leedanie2/curve-tracer/sim/README.md

# sim/ — LTspice experiments

One file per experiment, and that file is the source of truth. Circuits with
topology worth seeing are LTspice schematics (`.asc`: 00–03, 08–11); circuits
that are just a resistor network are plain netlists (`.cir`: 04–07). Vendor
models live in `models/`. LTspice's `.log`, `.raw`, `.db`, `.op.raw` and `.net`
outputs are regenerable and gitignored.

Run a file headless (`-b` takes `.asc` and `.cir` alike), then parse its log or
`.raw`. This LTspice is the Windows build
in a CrossOver bottle, so the `/Applications` binary is only a launcher stub —
`-b` against it returns exit 0 without simulating. Drive the bottled `.exe`
instead:

```
CX=/Applications/LTspice.app/Contents/SharedSupport/ltspice/bin
"$CX/cxstart" --bottle ltspice --workdir "$PWD/sim" -- \
  "C:\\Program Files\\ADI\\LTspice\\LTspice.exe" -b "$PWD/sim/06_diffamp_loading.cir"

python3 host/parse_cmrr_log.py sim/05_diffamp_mc.log   # -> media/cmrr_mc.png
```

Note that `.meas` on a stepped `.op` logs only the first step; the remaining
steps are in the `.raw` file (f64 first variable, f32 for the rest).

---

## 04_diffamp_cmrr.cir — CMRR vs resistor tolerance, worst-case corner

**Sweeps:** `VCM` 0–11 V, stepped over `tol` = 1e-6, 1e-3, 1e-2. The four
resistors are skewed to the worst-case sign pattern (`s1..s4` = +, −, −, +) so
each tolerance gives the corner, not a typical case. `E1` gain 1e7 and tightened
`reltol/vntol/abstol` keep the solver from dominating the result.

**Question:** with a plain one-op-amp difference amp, how much common-mode
rejection do resistor tolerances alone cost at the worst-case corner?

**Results:**

| tol  | CMRR |
|---|---|
| 1e-6 | 134.40 dB |
| 0.1% | 74.42 dB |
| 1% | 54.57 dB |

The 1e-6 row is a **solver-floor control, not a result** — it confirms the
numerical noise floor sits far below the rows that matter.

Closed form for this corner:

```
A_cm = 80t / [(1 - t^2)(1 + b)],   b = 20(1 + t) / (1 - t)
```

The familiar `(1 + G)/(4t)` shortcut agrees to within 0.02 dB at 0.1%.

## 05_diffamp_mc.cir — CMRR Monte Carlo, 0.1% resistors

**Sweeps:** 500 runs (`.step param run 1 500 1`), each resistor drawn
independently via `mc(1, tol)` at `tol` = 1e-3, same `VCM` 0–11 V DC sweep.

**Question:** the corner in 04 is the guaranteed floor — what does the
*distribution* look like across a real production batch?

**Results (n = 500):**

| stat | CMRR |
|---|---|
| min | 76.20 dB |
| p5 | 79.43 dB |
| median | 88.26 dB |
| p95 | 110.51 dB |
| max | 144.73 dB |

Report this as a distribution with **74.4 dB as the floor**, not as a single
number. Note that `mc()` draws uniform and independent values, whereas real
reel-matched resistors are both tighter and correlated — so this spread is
conservative. **Do not cite the max**; it is one lucky draw, not a spec.

Reproduced from a batch run on 2026-09-18: `parse_cmrr_log.py` returns these
figures to the digit, since LTspice seeds `mc()` deterministically. Histogram:
`media/cmrr_mc.png`.

## 06_diffamp_loading.cir — input loading with no DUT connected

**Sweeps:** `Rsh` stepped over 1 Ω, 100 Ω, 10 kΩ at a fixed 10 V source, `.op`
only. `E1` gain is 1e5 here since the question is resistive loading, not CMRR.

**Question:** with nothing plugged into the fixture, does the difference amp's
own input network inject current into the shunt?

**Results:** `V(out) = 9.512 mV` at `Rsh = 1 Ω`, which is **475.6 µA of phantom
current with no DUT connected**. In general:

```
I_err = 0.476 / (1000 + Rsh)   [A]
```

Against full scale that is **0.95% / 43% / 433%** on ranges 1 / 2 / 3.

**Conclusion:** unity-gain input buffers are required — move to the 3-op-amp
instrumentation topology. The op-amp count goes from four channels to six,
i.e. from 2 to 3 × OPA2197.

## 07_diffamp_buffered.cir — same loading test, with input buffers

**Sweeps:** identical to 06 — `Rsh` over 1 Ω, 100 Ω, 10 kΩ, fixed 10 V source,
`.op` only. Node names are kept the same as 06 so the two files diff cleanly;
the only change is `Eba`/`Ebb`, unity-gain buffers inserted between the source
nodes (`na`, `nb`) and the bridge resistors, which now feed from `bufa`/`bufb`.

**Question:** does the 3-op-amp instrumentation topology remove the phantom
current that 06 measured?

**Read this before citing a number from it:** the buffers here are ideal
`E` sources, so they draw **zero input current by construction**. The sim
returns zero because that is what an ideal VCVS does, not because it measured
anything. It demonstrates the topology change — the bridge no longer loads the
shunt — and nothing more.

The real-world figure is the **OPA2197 input bias current, ~5 pA typical**,
which comes from the datasheet, not from this netlist. **This sim does not
prove pA-level performance.** To simulate that, swap the `E` sources for the
vendor OPA2197 model.

**Measured (batch run, 2026-09-18):**

| Rsh | 06 unbuffered V(out) | 07 buffered V(out) |
|-----|---|---|
| 1 Ω | 9.5123 mV | 0 |
| 100 Ω | 0.86563 V | 0 |
| 10 kΩ | 8.6578 V | 0 |

07 returns exact zero at every step, which is the expected output of an ideal
VCVS and confirms the netlist is wired as intended — it is **not** evidence of
any particular bias-current performance. Read it as: the error term 06 found
is gone once the bridge stops drawing from the shunt. Sizing the residual
needs the vendor model.

## 08_sweep_source_rb_sweep.asc — base resistor and falling edge, no clamp

**Sweeps:** three nested steps, 48 runs in all:
- `Rb` over 100, 220, 330, 390, 470 and 680 Ω (470 and 680 added 2026-09-22).
- Four load cases, stepped as `lcase` 1–4 with `Cload` and `RL` set by
  `table()`: 100 nF / 200 Ω, 100 nF / open (1 GΩ), 100 pF / 200 Ω, 100 pF / open.
- Two drive cases, stepped as `tcase` with the `V2` pulse levels set by
  `table()`: `tcase` = 1 is a 100 mV small-signal step, `PULSE(1.5 1.6 ...)`,
  5.0 V → 5.33 V at the emitter; `tcase` = 2 is full scale, `PULSE(0.3 2.7 ...)`,
  1 V → 9 V.

LTspice sets `.tran` once per run, not per step, so both drive cases share
`.tran 0 20m 0 10n`. That is long enough for the full-scale passive fall to
finish while keeping the 10 ns max timestep (blueprint §12, item 3); the
small-signal measurements only use 0–90 µs. `.save` limits output to
`V(emitter)`, `V(n004)` (the BD139 base, which has no FLAG) and `I(Rbase)`.
Even so the `.raw` is ~1.8 GB and a batch run takes ~20 min. (It was ~1.3 GB
and ~7 min at the original four `Rb` values.) The `tcase` = 2 / `lcase` = 2
steps — full scale into 100 nF with an open load — dominate the runtime: a
3.33 ms passive fall resolved at a 10 ns maximum timestep.

**Question:** which base resistor, and what does the falling edge do when the
follower can only source current?

**Results — `Rb` vs small-signal overshoot** (`tcase` = 1, 100 nF / 200 Ω;
batch runs 2026-09-18 and 2026-09-22, the first four rows reproduced exactly):

| Rb | Overshoot | 1% settling | ζ (2nd-order) | implied PM |
|----|---|---|---|---|
| 100 Ω | 0.28% | 0.23 µs | 0.88 | ~88° |
| 220 Ω | 5.28% | 0.36 µs | 0.68 | ~68° |
| **330 Ω** | **10.34%** | **0.50 µs** | **0.59** | **~59°** |
| 390 Ω | 12.73% | 0.56 µs | 0.55 | ~55° |
| 470 Ω | 15.57% | 0.62 µs | 0.51 | ~51° |
| 680 Ω | 21.35% | 0.94 µs | 0.44 | ~44° |

The 470 and 680 Ω rows were added in a re-run on **2026-09-22** (48 steps,
~20 min, 2.0 GB `.raw`) to test whether a larger `Rb` could cut the
short-circuit load current; see 11. Nothing oscillates at any `Rb`, and the
100 pF cases show no overshoot at all. But ζ falls monotonically, and at
680 Ω the `Rb·C_jc` pole has halved to 6.5 MHz against a ~3 MHz crossover.

**680 Ω was rejected.** Not for anything in this sim, which it passes, but
because the breadboard input pole at 2–3 MHz (blueprint §3.1) is *not*
modelled here and costs ~45° where it sits. From 330 Ω's ~59° that is
recoverable with the prescribed 2–4 pF `C_f`; from ~44° it is not.

Up to 390 Ω, damping does not set `Rb`; op-amp current does, when the limiter
trips (~13.95 V / `Rb`), which this netlist does not model — see blueprint
§3.1. Beyond 470 Ω damping becomes the binding constraint. Both point to
**330 Ω**.

At full scale (`tcase` = 2), rising edges are slew-limited at 9.1–9.95 V/µs
and settle to 1% in 0.87–1.18 µs across all four loads and all four `Rb`.
Overshoot at 100 nF is 0.22 / 1.25 / 2.18 / 2.65% at 100 / 220 / 330 / 390 Ω,
and zero at 100 pF. The op-amp sources under 3 mA on the rise. Falling edges
do not depend on `Rb` without the clamp; they are tabulated under 09.

Even the 100 mV small-signal fall reverse-biases the base-emitter junction to
−5.3 V at 100 nF open load, because the op-amp output still slams to its low
rail while the load holds the emitter up. The swing size does not protect the
junction; the clamp in 09 does.

**Convergence:** 24 of the 32 steps need Gmin stepping to find the initial
operating point. All succeed, with no timestep failures. The op-amp is
`UniversalOpAmp2` with default parameters: 10 V/µs slew and a 25 mA output
clamp, against the OPA2197's ~20 V/µs and ~65 mA typical.

```
python3 host/parse_tran_overshoot.py sim/08_sweep_source_rb_sweep.raw
```

## 09_sweep_source_clamped.asc — 08 plus a B-E clamp diode

**Sweeps:** 08's full-scale case only: `Rb` over 220 and 330 Ω, the same four
loads, `PULSE(0.3 2.7 ...)`, same `.tran`. The only circuit change is `D1`, a 1N4148 across the
BD139 base-emitter junction, anode at the emitter and cathode at the base
(`D1 emitter N004 1N4148` in the netlist). It uses the stock LTspice
`standard.dio` model (`Is=2.52n Rs=.568 N=1.752 Cjo=4p M=.4 tt=20n`). Those
are fitted-looking values, not placeholders. `Cjo` matches the datasheet, but
`tt` implies ~14 ns reverse recovery against the datasheet's 4 ns, so the sim
is pessimistic there. Reverse breakdown is not modelled; the clamp never gets
near it.

**Question:** does the clamp keep V_BE inside the BD139's 5 V `V_EBO`, and what
does the active pull-down it creates cost the op-amp?

**Results — falling edge, 9 V → 1 V, `Rb` = 330 Ω** (batch run, 2026-09-18):

| Load | 08 τ | 08 settle | 08 min V_BE | 09 τ | 09 settle | 09 min V_BE | 09 op-amp sink |
|---|---|---|---|---|---|---|---|
| 100 nF, 200 Ω | 19.9 µs | 45.1 µs | −7.72 V | 12.9 µs | 33 µs | −0.73 V | 18.6 mA |
| 100 nF, open | 3.33 ms | 7.06 ms | −8.98 V | 36.6 µs | 103 µs | −0.74 V | 21.9 mA |
| 100 pF, 200 Ω | driven | 0.88 µs | +0.83 V | driven | 0.88 µs | +0.83 V | 0.2 mA |
| **100 pF, open** | 3.05 µs | **9.4 µs** | **−6.28 V** | driven | **1.7 µs** | −0.58 V | 1.0 mA |

"Driven" means the op-amp pulls the emitter down at its slew rate: through the
BJT, which stays on, at 100 pF / 200 Ω; and through the diode, with the BJT
off, in 09 at 100 pF open. Everywhere else in 08 the BJT cuts off and the load
discharges passively. At 100 nF, τ matches `C·(RL ‖ 33.3 kΩ)` to 3 significant figures.
In 09 the diode path runs in parallel, giving `τ ≈ C·[RL ‖ (R_iso + Rb)]`:
12.7 / 34.9 µs predicted, 12.9 / 36.6 µs fitted.

100 pF open is current range 3's real operating condition. Unclamped, it
reverse-biases the junction past `V_EBO` on every falling step; the clamp fixes
that and cuts settling from 9.4 to 1.7 µs. Rising edges are unchanged:
overshoot, sustained slew and settling are identical to 08's `tcase` = 2 rows.

**Read this before citing the 220 Ω rows** (in the parser output, not the table
above): the discharge would need ~33 mA at 220 Ω. The op-amp model clamps at
25 mA and hit exactly 25.00 mA, so those rows show the model's limit, not the
circuit's.

```
python3 host/parse_tran_overshoot.py sim/09_sweep_source_clamped.raw
```

## 10_current_limit.asc — the current limiter (Q2 + R_sense)

**Circuit:** 09 plus the limiter, the one block no earlier sim covered.
`R_sense` (10 Ω) sits between the BD139 emitter (`e_bjt`) and the feedback tap
(`fb`), with `R_iso` (22 Ω) from `fb` to the load (`out`). Q2 is a 2N3904 with
its base on `e_bjt`, emitter on `fb`, and collector on the BD139 base. The
1N4148 clamp is across the BD139's own B-E junction (`e_bjt` → `base`).
`V2` is DC 3.0 V, so the setpoint is 10 V at `fb`.

**Sweeps:** `Rb` over 100 and 330 Ω × op-amp `Ilimit` over 25 mA and 65 mA ×
`Cload` over 100 pF and 100 nF (8 runs). `Ilimit` is set through the op-amp's
`SpiceLine`: 25 mA is the `UniversalOpAmp2` default and 65 mA is the OPA2197's
typical. It has to be stepped because at 25 mA both `Rb` values deliver exactly
25 mA of drive, which would make the `Rb` comparison meaningless. The load is a
time-varying resistor: open (1 MΩ) to 0.2 ms, a log ramp to 0.1 Ω by 2.2 ms, a
held short to 3.2 ms, then snapped back open. `.tran 0 3.6m 0 10n`; the `.raw`
is ~130 MB and a batch run takes ~15 s.

**Question:** where does the limiter engage, what does `R_B` change, and what
happens when the short is removed?

**Results — held short at 3.1 ms** (batch run, 2026-09-18; identical at 100 pF
and 100 nF):

| Rb | op-amp Ilimit | I(R_sense) | op-amp drive | in own limit? | load current | Q2 | BD139 |
|----|---|---|---|---|---|----|---|
| 100 Ω | 25 mA | 74.3 mA | 25.0 mA | yes | 99.0 mA | 24.6 mA, 41 mW | 894 mW |
| 330 Ω | 25 mA | 74.3 mA | 25.0 mA | yes | 99.0 mA | 24.6 mA, 41 mW | 894 mW |
| 100 Ω | 65 mA | 77.8 mA | 65.0 mA | yes | 142.6 mA | 64.6 mA, 109 mW | 860 mW |
| **330 Ω** | **65 mA** | **75.2 mA** | **32.2 mA** | **no** | **107.0 mA** | 31.8 mA, 53 mW | 891 mW |

- **Q2's threshold is log-insensitive to drive, as predicted.** Going from 32
  to 65 mA of drive moves the `R_sense` current by 2.6 mA (3%). With the
  default 25 mA clamp both `Rb` rows are identical, which is why `Ilimit` is
  stepped.
- **The threshold is ~75 mA, not ~65 mA.** Q2's V_BE is ~0.75 V at these
  currents. The stock `2N3904` model has round, generic-looking parameters
  (`IS=1E-14 VAF=100 Bf=300`), so the same case was cross-checked with the
  fitted Rohm `SST3904` (swap Q2's value): 76.5 / 79.9 mA at 330 / 100 Ω,
  within 2%.
- **The load current is not limited to the `R_sense` current.** Q2's emitter
  returns to the output side of `R_sense`, so the drive it steals from the
  BD139 base goes to the load: load = `R_sense` current + drive. At 330 Ω the
  load current is ~81 mA when the output has drooped 1% and 107 mA into a hard
  short, because the drive grows as the output collapses.
- **Op-amp dissipation** is 12 mW at 330 Ω and 238 mW at 100 Ω (65 mA limit),
  from (15 V − V(oa)) × drive. The model rails at exactly 15 V, so treat these
  as lower bounds.

**Results — recovery when the short is removed (3.2 ms):**

| Cload | peak V(out) | above 10.1 V for | back within 1% |
|---|---|---|---|
| 100 pF | 14.8 V (+48%) | ~1.6 µs | 1.9 µs |
| 100 nF | no overshoot at `out` (V(fb) peaks 10.8–10.9 V) | — | 12–14 µs |

With a light load the output jumps to within a V_BE of the op-amp's rail. It
holds near 14.2 V for ~1 µs while the op-amp comes out of saturation, then
slews back to 10 V. The same happens whenever a heavy load current suddenly
stops, for example when a MOSFET DUT in the current limit is switched off. The
peak is structural: the op-amp is at its rail when the short clears. The
duration depends on the op-amp's overload recovery, which this model does not
represent faithfully. Results are the same for both `Rb` values and both
`Ilimit` settings.

**Read this before citing the op-amp rows:** the model's output stage (hard
rail at 15 V, ideal current clamp) is not the OPA2197's, so the op-amp's own
condition in the fault is not trustworthy here. The trip point, the Q2 and
BD139 figures, and the drive routing are.

**Convergence:** the four `Rb` = 330 Ω runs need Gmin stepping to find the
initial operating point; all succeed, with no timestep failures.

```
python3 host/parse_current_limit.py sim/10_current_limit.raw
```

## 11_limit_sizing.asc — joint R_B / R_sense sizing

**Circuit:** identical to 10, with `R_sense` set by the parameter `Rs`.

**Sweeps:** `Rb` over 330, 470 and 680 Ω × `Rs` over 10, 12 and 15 Ω ×
setpoint (`vin` 3.0 V → 10 V at `fb`; `vin` 3.3 V, the DAC's full scale →
11 V at `fb`). That is 18 runs. The op-amp `Ilimit` is fixed at 65 mA (the
OPA2197's typical) and `Cload` at 100 pF; the sim 10 short-circuit figures did
not depend on `Cload`. The load profile is the same as 10. The .raw is ~280 MB
and a batch run takes ~30 s.

**Question:** the spec is now **load** current in a hard short, ≤ 65 mA. Load
current = `R_sense` current + op-amp drive, because Q2's emitter is on the
output side of `R_sense`. Which pair gets there?

**Results** (batch run, 2026-09-18). "Onset" is the load current when `V(fb)`
first droops 1% below its setpoint during the ramp, i.e. where limiting begins
to bite. Everything else is the held short and does not depend on the
setpoint.

| Rb | Rs | load, hard short | I(R_sense) | op-amp drive | Q2 | BD139 | onset @ 10 V | onset @ 11 V |
|----|----|---|---|---|----|---|---|---|
| 330 | 10 | 107.0 mA | 75.2 mA | 32.2 mA | 53 mW | 891 mW | 81.2 mA | 77.3 mA |
| 470 | 10 | 97.1 mA | 74.1 mA | 23.3 mA | 38 mW | 895 mW | 77.3 mA | 74.2 mA |
| 680 | 10 | 89.2 mA | 73.1 mA | 16.5 mA | 26 mW | 895 mW | 74.0 mA | 71.6 mA |
| 330 | 12 | 95.4 mA | 62.7 mA | 32.9 mA | 54 mW | 759 mW | 69.4 mA | 65.7 mA |
| 470 | 12 | 85.4 mA | 61.8 mA | 23.9 mA | 39 mW | 762 mW | 65.6 mA | 62.7 mA |
| 680 | 12 | 77.5 mA | 60.9 mA | 16.9 mA | 27 mW | 762 mW | 62.5 mA | 60.3 mA |
| 330 | 15 | 83.7 mA | 50.2 mA | 33.7 mA | 55 mW | 621 mW | 57.5 mA | 54.0 mA |
| 470 | 15 | 73.7 mA | 49.5 mA | 24.4 mA | 40 mW | 624 mW | 53.9 mA | 51.2 mA |
| 680 | 15 | **65.8 mA** | 48.8 mA | 17.3 mA | 28 mW | 623 mW | 51.0 mA | **49.0 mA** |

The op-amp stays out of its own 65 mA limit in every case. Its dissipation is
3–13 mW, a lower bound because the model rails at exactly 15 V. The
short-removal overshoot is +47.9 to +48.3% for every pair, the same as 10.
The 330 / 10 row reproduces sim 10's matching row exactly.

**Read this before choosing a pair:** only 680 / 15 reaches the ≤ 65 mA
load-current target, and at the 11 V spec corner it starts limiting at
**49.0 mA**, below the 50 mA sweep spec.

The two targets conflict in this topology. The gap between onset and hard
short is roughly the op-amp drive current, which grows as the output collapses
and base headroom opens up. That gap is still ~17 mA at 680 Ω. Closing it to
~10 mA would need `Rb` near 1.4 kΩ, which puts the `Rb·C_jc` pole at ~3 MHz,
on top of the ~3 MHz crossover.

Onset is also lower at the higher setpoint, because less headroom above the
base means less drive. On top of that, Q2's V_BE falls about 2 mV/°C, which
lowers every onset figure as Q2 warms.

**Convergence:** 13 of the 18 runs need Gmin stepping; all succeed.

```
python3 host/parse_current_limit.py sim/11_limit_sizing.raw
```

## 12_bare_loop_cin.cir — bare loop with a stray C_in at IN−, held at 6 V

Written 2026-11-03, after board 2 oscillated at open load (CONTINGENCY A3).
It is CONTINGENCY §3's procedure: add C_in at IN−, C1 empty, and step it
until the simulated oscillation matches the bench.

**Circuit:** sim 10/11's topology (feedback after `R_sense`, B-E clamp, Q2
limiter), plus what the board has between FB_SENSE and the socket: `R_iso`
22 Ω, the PTC at 8.4 Ω, the 1 Ω range-1 shunt, D3 as a capacitor
(`cd3`), the 400 kΩ Kelvin divider, and the scope's 10× probe on TP3
(12 pF ‖ 10 MΩ). `R_f` is the board's 23.2 kΩ. The op-amp is sims 08–11's
`UniversalOpAmp2` (GBW 10 MHz, no excess phase, no input capacitance), with
slew raised to the OPA2197's 20 V/µs. The 8.4 Ω PTC is inferred from the
bench, not measured: (6.001 − 5.193) V / 25.74 mA − 23 Ω, which also
absorbs any DAC error. D3's capacitance is in no datasheet on hand;
distributor listings for other makers' SMAJ12A give 0.8–1.3 nF at 0 V, less
at 6 V, so `cd3` is bracketed at 0.5, 1.2 and 2.2 nF.

**Sweeps:** `cin` 0, 5, 9, 15, 20, 30 pF × load (open; 200 Ω ‖ 100 nF) ×
`cd3`, 36 runs, ~30 s. The DAC steps 0 → 6 V at 2 µs; a 5 mV kick at the
node at 150 µs; p-p and frequency at TP3 over the last 50 µs.

**Results (simulated, LTspice, sim 12):**

| `cin` | open, D3 0.5 nF | open, 1.2 nF | open, 2.2 nF | 200 Ω ‖ 100 nF, all `cd3` |
|---|---|---|---|---|
| 0–15 pF | quiet | quiet | quiet | quiet |
| 20 pF | 1.24 V p-p, 0.986 MHz | 1.90 V, 0.893 MHz | quiet (rings, decays) | quiet |
| 30 pF | 3.39 V, 0.954 MHz | 4.48 V, 0.780 MHz | 4.18 V, 0.673 MHz | quiet |

Under the 200 Ω ‖ 100 nF load the node sits at 5.185 V, 25.94 mA (bench:
5.193 V, 25.74 mA into 202 Ω; partly circular, since the PTC value came from
that reading). Below the threshold the open-load loop rings after the kick
at 0.8–2.6 MHz and decays more slowly as `cin` rises: at `cin` = 0 each
half-cycle is ~0.3× the last, at 15 pF and 1.2 nF 0.93–0.95×. The ~0.8 MHz
ring is there even at `cin` = 0. Sustained oscillation runs at a lower
frequency than that small-signal ring: it is large-signal, with the follower
cutting off on each down-swing (see `docs/characterization.md`).

All runs need Gmin stepping for the operating point; all succeed.

```
python3 host/parse_osc.py sim/12_bare_loop_cin.raw
```

## 13_parallel_load.cir — the smallest resistor across D–S that keeps it quiet

Written 2026-11-03 for the diode demo. A diode sweep starts at open load,
because the diode is off below ~0.3–0.4 V on range 1, so the question is
what resistor `R_p`, clamped across D–S with the diode, keeps the loop free
of sustained oscillation from 0.1 V up.

**Circuit:** sim 12's, at its fitted `cin` of 20 pF (the threshold) and
30 pF (margin), `cd3` 0.5 and 1.2 nF (D3 near zero bias).

**Sweeps:** load (open; `R_p` 10 k, 4.7 k, 2.2 k, 1 k, 680, 470, 330,
200 Ω; 100 nF alone) × level (0.1, 0.2, 0.3, 0.6, 1.0, 1.5, 6 V) × `cin` ×
`cd3`, 280 runs, ~3 min.

**Results (simulated, LTspice, sim 13).** Sustained oscillation, p-p at TP3:

| `R_p` | `cin` 20 pF (both `cd3`) | `cin` 30 pF, `cd3` 0.5 nF | `cin` 30 pF, `cd3` 1.2 nF |
|---|---|---|---|
| open | 0.6–6 V | 0.2–6 V | 0.2–6 V |
| 10 k, 4.7 k | 0.1–1.5 V | 0.1–6 V | 0.1–6 V |
| 2.2 k | 0.1–0.3 V | 0.1–0.3 V | 0.1–1.5 V |
| 1 k | quiet | quiet | **0.1–0.3 V**, 105–274 mV p-p |
| 680 | quiet | quiet | **0.1 V**, 97 mV p-p, 0.76 MHz |
| **470, 330, 200** | **quiet** | **quiet** | **quiet** |
| 100 nF alone | quiet | quiet | quiet |

470 Ω is the largest value quiet in all 28 level × corner cases. The
100 nF-alone row shows that a large capacitance quiets the loop with almost
no bias current, so the mechanism is not bias alone.

**Refuted on the bench, 2026-11-08.** 470 Ω (469 Ω by DMM) across D–S
oscillated at idle, with the node at the DAC floor (~0.19 V): **781.1 kHz,
> 205 mV p-p** at TP3, clipped. L1 was quiet at idle, 0.1 V and 0.3 V. So
the 470/330/200 Ω rows above are not evidence that a plain resistor is
safe. The 20–30 pF fit made the macro-model oscillate at open load as the
bench did. That did not make it a faithful stand-in for the op-amp's excess
phase at other loads. The 100 nF-alone row is the one the bench bears out;
see sim 15 and `docs/characterization.md` (2026-11-08 (a)). The table is
kept as the record of the prediction.

```
python3 host/parse_osc.py sim/13_parallel_load.raw
```

## 14_bare_loop_opa197.cir, 14b_l1_opa197.cir — sim 12 with TI's OPAx197 model

Written 2026-11-03. Sims 08–13 use LTspice's generic `UniversalOpAmp2`,
which has one pole and no excess phase. In sim 12 the fitted 20–30 pF
"C_in" therefore stands in for every lag that model lacks. This sim swaps in
the vendor model to see how much of that lag is real.

**The model is not in git** (TI copyright). Fetch it once:

```
curl -sSL -o "$TMPDIR/sboma34.zip" https://www.ti.com/lit/zip/sboma34
unzip -o -j "$TMPDIR/sboma34.zip" OPAx197.LIB -d sim/models
```

That is `OPAx197.LIB`, Final 1.3, 23 Jun 2022. It models input capacitance:
C_COM 6.4 pF from each input to ground and C_DIFF 1.6 pF across them. That
answers §2A's open question for the model: 6.4 pF is per input. So `cin` is
0 here, and C1 (C_f, across R_f) is stepped instead.

**Slow.** TI's E2E forum reports the same. Once a ring decays below
~0.1 mV, the timestep collapses and the run never finishes. Each run stops at
14 µs, and the 0 → 6 V start-up step at 2 µs is the only excitation. The
metric is the start-up ring's frequency and the median ratio of successive
half-cycle peaks over 3–14 µs. A ratio near 1 is near-marginal.

**Sweeps:** `cf` 0, 3.3 pF, D3 1.2 nF. Sim 14 is open load. Sim 14b is
L1 (200 Ω ‖ 100 nF). With L1, LTspice finds no operating point for TI's
model (Gmin and source stepping both fail), so 14b starts from zero
(`uic`). Its 6 V step charges 100 nF and is still settling at 14 µs, so its
metric is the p-p left after a cubic fit to the settling over 10–14 µs.
Each L1 run takes ~5 s. Each open-load run takes ~1 min. A first combined
deck stalled for over an hour at the L1 operating point and was split.

**Results (simulated, LTspice, sims 14 and 14b), V(e) at TP3:**

| Load | `cf` | Ring f | Half-cycle ratio | First peak | Residual 10–14 µs |
|---|---|---|---|---|---|
| open | 0 | 0.91 MHz | **0.83** | 616 mV | — |
| open | 3.3 pF | 1.1–1.6 MHz (few cycles) | **0.40** | 129 mV | — |
| L1 | 0 | — | — | — | 0.24 mV p-p |
| L1 | 3.3 pF | — | — | — | 0.24 mV p-p |

With no C_in added, the bare loop at open load is near-marginal at
0.91 MHz. Sim 12 needed 20–30 pF of C_in to reach that, so that figure
mostly stands in for excess phase the macro-model lacks. 3.3 pF in C1 damps
the ring well. Under L1 it is quiet either way. The ring decays here where
the bench's was sustained, so the model is somewhat optimistic. The open
3.3 pF ring is too damped to give a firm frequency: 1.10 MHz over 3–6.4 µs,
1.55 MHz over 3–14 µs.

```
python3 host/parse_osc.py sim/14_bare_loop_opa197.raw --ring 3e-6 14e-6
python3 host/parse_osc.py sim/14b_l1_opa197.raw --residual 10e-6 14e-6
```

## 14c_cf_bracket_opa197.cir, 14d_low_level_opa197.cir — C1 either side of 3.3 pF, and low levels

Sim 14 with TI's model, open load, D3 1.2 nF, for the rev 2 C1 value
(`hardware/REV2.md` on the `rev2` branch). **14c** steps C1 to the stocked
values either side of 3.3 pF, 2.2 and 4.7 pF, at 6 V. **14d** holds 0.1
and 0.3 V with C1 empty and 3.3 pF. At 0.1 V Q1 carries only ~3 µA, the
case sim 13 found hardest.

**Run notes.** 14c's 4.7 pF step hit the timestep collapse at 9.30 µs and
was stopped there after an hour (2 fs of simulated time per second). Its
raw file was truncated to whole points and read over 3–9.2 µs, and so were
sim 14's two steps and 14c's 2.2 pF step, for a common window. 14d runs to
80 µs, ~40 min. Its start-up overshoot recovers slowly through R_f + R_g
and D3, so 14 µs would have caught that recovery, not the loop.

**Results (simulated, LTspice, TI's OPAx197 model), V(e) at TP3, 6 V step,
3–9.2 µs:**

| C1 | Sim | Half-cycle ratio | Peak over final | 1% settling after the edge |
|---|---|---|---|---|
| 0 | 14 | 0.80 | +1.47 V | 7.1 µs |
| 2.2 pF | 14c | 0.50 | +0.76 V | 2.7 µs |
| 3.3 pF | 14 | 0.40 | +0.40 V | 2.1 µs |
| 4.7 pF | 14c | no ring (0.4 mV) | +0.4 mV; one 0.17 V dip | 0.5 µs |

The edge itself is slew-limited and identical in all four: 90% in 0.33 µs.

**Low levels (14d), residual p-p after a cubic fit:**

| Level | C1 | 40–60 µs | 60–80 µs |
|---|---|---|---|
| 0.1 V | 0 | 8.68 mV | 0.23 mV (0.23 MHz, ratio 0.62) |
| 0.3 V | 0 | 2.69 mV | 0.03 mV |
| 0.1 V | 3.3 pF | 0.01 mV | 0.00 mV |
| 0.3 V | 3.3 pF | 0.00 mV | 0.00 mV |

**What it says.** In this model, damping improves steadily from 0 to
4.7 pF. 4.7 pF shows none of CONTINGENCY's *too much C_f* failure, and
C1's ±0.1 pF tolerance is far inside the 2.2–4.7 pF bracket. With C1
empty the low levels ring and decay without sustaining. That is the same
optimism as sim 14: the bench sustained at open load where the model
decays. With 3.3 pF both levels are quiet within 40 µs. All of this is
one vendor model, open load only.

```
python3 host/parse_osc.py sim/14c_cf_bracket_opa197.raw --ring 3e-6 9.2e-6   # after truncating, see above
python3 host/parse_osc.py sim/14d_low_level_opa197.raw --ring 60e-6 80e-6
python3 host/parse_osc.py sim/14d_low_level_opa197.raw --residual 40e-6 60e-6
python3 host/parse_osc.py sim/14d_low_level_opa197.raw --residual 60e-6 80e-6
```

## 14e_l1_4p7_opa197.cir, 14f_low_level_4p7_opa197.cir — C1 = 4.7 pF into L1 and at low levels

Rev 2's C1 is 4.7 pF (`hardware/DECISIONS.md` R2-4, 2026-11-03). These two
cover the cases sim 14c didn't. **14e** is sim 14b (L1, 6 V, `uic`) at
3.3 and 4.7 pF. **14f** is sim 14d (open load, 0.1 and 0.3 V, 80 µs) at
4.7 pF. 14e runs in seconds and 14f in ~5 min.

**Results (simulated, LTspice, TI's OPAx197 model), V(e) at TP3:**

| Sim | Load, level | C1 | Residual p-p after a cubic fit |
|---|---|---|---|
| 14e | L1, 6 V, 10–14 µs | 3.3 pF | 0.24 mV (matches 14b) |
| 14e | L1, 6 V, 10–14 µs | 4.7 pF | 0.24 mV |
| 14f | open, 0.1 V, 40–60 and 60–80 µs | 4.7 pF | 0.00 / 0.00 mV |
| 14f | open, 0.3 V, 40–60 and 60–80 µs | 4.7 pF | 0.00 / 0.00 mV |

4.7 pF is as quiet as 3.3 pF in every case simulated. The `--ring` parse of
14f reports a ratio of 1.0 at 0.1 V. That is sub-µV numerical noise: its
first peak rounds to 0.0 mV.

```
python3 host/parse_osc.py sim/14e_l1_4p7_opa197.raw --residual 10e-6 14e-6
python3 host/parse_osc.py sim/14f_low_level_4p7_opa197.raw --residual 40e-6 60e-6
python3 host/parse_osc.py sim/14f_low_level_4p7_opa197.raw --residual 60e-6 80e-6
```

## 15_floor_rp_opa197.cir — 470 Ω against L1 at the DAC floor: is it the 100 nF?

Written 2026-11-08. On the bench that night, 470 Ω across D–S oscillated at
idle (781.1 kHz, > 205 mV p-p at TP3) and L1 (200 Ω ‖ 100 nF) did not.
Sim 13 had predicted 470 Ω quiet. 470 Ω and L1 differ in two ways, Q1's
bias and the 100 nF. This sim separates them.

**Circuit:** sim 14b's deck (TI's OPAx197 model, `uic`, D3 1.2 nF, C1
empty), held at the sweep DAC's floor instead of 6 V. The bench read
0.18 V at J6 with L1 at idle; referred to FB_SENSE that is
0.18 V + 0.9 mA × 31.4 Ω = 0.208 V, the `vds` used. The DAC steps 0 → floor
at 2 µs, and that step is the only excitation.

**Sweeps:** load: 470 Ω; 470 Ω ‖ 100 nF (470's bias, L1's capacitance);
200 Ω alone (L1's bias, no capacitance); L1. Runs end at 12 µs. A first
30 µs run stalled in the timestep collapse described under sim 14, at
~15 µs, once the 470 Ω ring had decayed. All four take ~3 min.

**Results (simulated, LTspice, TI's OPAx197 model), V(e) at TP3:**

| Load | Q1 bias | Ring f | Half-cycle ratio, 3–12 µs | Residual p-p, 8–12 µs |
|---|---|---|---|---|
| 470 Ω | 0.415 mA | 1.69 MHz | 0.66 | 0.77 mV |
| 470 Ω ‖ 100 nF | (charging) | none | — | 0.01 mV |
| 200 Ω alone | 0.900 mA | 2.13 MHz | 0.57 | 0.01 mV |
| L1 | (charging) | none | — | 0.01 mV |

The `--ring` parse reports a "first peak" of 165–198 mV for every load. For
the two 100 nF loads that is the charging step, not a ring: no crossings
follow it.

**What it says.** With 100 nF the loop doesn't ring at either bias; without
it, it rings at either bias, and the extra bias only moves the ratio from
0.66 to 0.57. So the 100 nF is what quiets it, by moving the load's
pole-zero pair from ~1.6–4.9 MHz to ~20–60 kHz, far below crossover
(`docs/characterization.md`, 2026-11-08 (a)). The model is optimistic, as
in sims 14 and 14d: its 470 Ω ring decays where the bench sustained, and
at 1.7 MHz where the bench oscillated at 781 kHz. Read it for the
ordering, not the margin.

```
python3 host/parse_osc.py sim/15_floor_rp_opa197.raw --ring 3e-6 12e-6
python3 host/parse_osc.py sim/15_floor_rp_opa197.raw --residual 8e-6 12e-6
```

## 16_cap_only_opa197.cir, 16b_cap_only_levels_opa197.cir — 100 nF alone across D–S, and the session-3 fixture

Written 2026-11-09, for MVP card section E. Sim 15 found that L1's 100 nF,
not its 200 Ω, keeps the loop quiet. Does the capacitor alone do it? A
resistor-free stabiliser draws no DC, so nothing would need subtracting.
Without a resistor Q1 carries only the feedback network and the Kelvin
divider, ~6 µA at the floor (r_e ~4 kΩ): the weakest bias the loop has.

**Circuit:** sim 15's (TI's OPAx197 model, `uic`, C1 empty, D3 1.2 nF).
The stabiliser is either at J6, or 5 cm away on the session-3 breadboard,
behind 100 nH and 0.1 Ω for the D and S wires together. 100 nH with 100 nF
resonates near 1.6 MHz, inside the loop's band, which is why the fixture
gets its own case.

**Sweeps:**
- **16, at the floor** (FB_SENSE 0.205 V): cap at J6; cap on the fixture;
  open load as the reference. Each settles from the start-up step, then the
  DAC moves one sweep step (15 mV at the node) up at 30 µs and back down at
  50 µs. 70 µs.
- **16b, at 1 V and 6 V**: cap at J6 and on the fixture. Start-up step only,
  25 µs. TI's model collapses its timestep once a run goes quiet, and a
  first 70 µs version of these crawled at ~1 µs per minute.

**Results (simulated, LTspice, TI's OPAx197 model), V(e) at TP3:**

| Sim | Load | Level | Ring after the step | Residual / note |
|---|---|---|---|---|
| 16 | 100 nF at J6 | floor, settled 20–29 µs | none | 0.00 mV |
| 16 | 100 nF at J6 | +15 mV step | none (smooth charge) | node reaches 0.218 V in 20 µs |
| 16 | 100 nF at J6 | −15 mV step | none | node stays at 0.219 V: no path down but 33.2 kΩ |
| 16 | 100 nF on the fixture | floor, both steps | none (µV wiggle, gone in 5 µs) | as at J6 |
| 16 | open load (reference) | floor, steps | **155 kHz, ratio 0.44 (up); 290 kHz, 0.72 (down)** | 58 mV p-p still left from start-up at 20–29 µs |
| 16b | 100 nF at J6 | 1 V, 6 V start-up | none | tail 0.12 / 0.96 mV (exponential charge, not a ring) |
| 16b | 100 nF on the fixture | 1 V | none | 0.12 mV |
| 16b | 100 nF on the fixture | 6 V | overshoot to 7.35 V at TP3 during the charge, gone by 8 µs; none after | 0.96 mV |

**What it says.** In TI's model, 100 nF with no resistor keeps the loop
from ringing from the floor to 6 V, at J6 and on the fixture. The open-load
reference rings under the same steps, so the method can see a ring. The
weakness is DC, not stability. With no resistor, the node can only fall
through the 33.2 kΩ feedback network (τ ≈ 3 ms), because the B-E clamp
can't sink below ~0.6 V. That's harmless for a rising diode sweep, but a
MOSFET family's off steps would start high. As always with this model
(blueprint §11), it decides what the bench tries first, not the margin.

```
python3 host/parse_osc.py sim/16_cap_only_opa197.raw --ring 30.2e-6 49e-6
python3 host/parse_osc.py sim/16_cap_only_opa197.raw --ring 50.2e-6 69e-6
python3 host/parse_osc.py sim/16b_cap_only_levels_opa197.raw --ring 3e-6 25e-6
python3 host/parse_osc.py sim/16b_cap_only_levels_opa197.raw --residual 15e-6 25e-6
```
