leedanie2/curve-tracer/firmware/README.md

# firmware/ — STM32 curve tracer

MVP scope: **range 1 only, DC sweep, no pulsed mode, no auto-ranging.**
Target board is the **Nucleo-F303RE**. Measurement logic lives in `core/`,
which has no STM32 dependency and is tested on the host against a modelled
DUT — see [Testing without hardware](#testing-without-hardware).

```
core/    portable sweep and HOLD engines, CSV writer, parameters, command parser
sim/     modelled DUT + a host binary that speaks the same protocol
tests/   C suites for the engine and format, pytest for the CSV contract
stm32/   STM32 build: HAL glue, peripheral init, interrupts, Makefile
```

---

## The CSV contract

This section and `core/ct_csv.h` define the format. **Change them together
or not at all** — the Python host in `host/` parses what is specified here.

### Framing

One rule, which makes command responses and sweep output shareable on a
single serial link:

| First character | Meaning |
|---|---|
| `#` | metadata or informational |
| `!` | error response |
| anything else | a CSV row |

Lines end **CRLF**, so a raw serial terminal stays readable.

### A complete sweep

```
# curve-tracer csv
# schema: 2
# fw: 0.1.0
# board: nucleo-f303re
# device: 2N7000
# date: 2026-09-28T14:03:11Z
# date_src: host
# range: 1
# mode: dc
# temp_c: 31.4
# temp_src: mcu_die
# settle_us: 50
# n: 200
# oversample_n: 64
# i_limit_ma: 60.00
# vds_max: 10.000
# vgs_list: 2.500,3.000,3.500
# cal_gain_sweep: 3.320
# cal_gain_gate: 3.320
# cal_shunt_ohm: 1.000
# cal_diffamp_gain: 20.00
# cal_vdiv: 4.000
# cal_rdiv_ohm: 400000
# cal_r_iso_ohm: 22.000
# cal_r_ptc_ohm: unset
# cal_vref: 3.300
# cal_adc_full_scale: 4095
# cal_dac_full_scale: 4095
# columns: point,vgs_set_v,vds_set_v,vds_meas_v,i_meas_ma,i_acc,v_acc,range,flags
point,vgs_set_v,vds_set_v,vds_meas_v,i_meas_ma,i_acc,v_acc,range,flags
0,2.499,0.000,0.000,0.0000,0,0,1,
1,2.499,0.714,0.622,3.9890,6336,12352,1,
...
# end: ok
```

### Columns

| Column | Unit | Meaning |
|---|---|---|
| `point` | — | index within the whole sweep, across all gate steps; detects dropped lines |
| `vgs_set_v` | V | gate voltage **commanded**, after DAC quantisation |
| `vds_set_v` | V | drain voltage **commanded**, after DAC quantisation |
| `vds_meas_v` | V | drain voltage **measured** by ADC2, Kelvin-sensed at the DUT |
| `i_meas_ma` | mA | **DUT** current: the shunt current less the Kelvin divider's `V_DS / cal_rdiv_ohm` (schema 2; see below) |
| `i_acc` | counts | **sum** of `oversample_n` raw current conversions |
| `v_acc` | counts | **sum** of `oversample_n` raw voltage conversions |
| `range` | — | always `1` in this build |
| `flags` | — | empty for a valid point; see below |

### `vds_set_v` and `vds_meas_v` are not redundant

This is the single most misread part of the format, so it is worth being
blunt about: **the two columns are different physical quantities, and their
difference is a measurement, not noise.**

- `vds_set_v` is the DAC code converted through the **nominal** gain of 3.32.
  It is what the amplifier's feedback node was *told* to produce. It contains
  no measurement at all.
- `vds_meas_v` is what **ADC2 actually read** at the DUT terminals through
  the Kelvin sense lines.

They differ because the feedback node is tapped **ahead of `R_iso`**
(blueprint §3.1), so three drops are downstream of the loop and
uncorrected: `R_iso` (22 Ω), the shunt burden (1 Ω on range 1), and the PTC
in the drain path (blueprint §3.6):

```
delta = vds_set_v - vds_meas_v ≈ I × (R_iso + R_shunt + R_PTC) = I × (23 Ω + R_PTC)
```

**`R_PTC` is not a constant.** The nSMD010 on the board is 1.6 Ω minimum and
15 Ω maximum, and its datasheet specifies the maximum one hour after reflow,
so a new board can sit anywhere in that range. **The figure also moves after
every trip**: the part recovers to a value anywhere up to 15 Ω, not
necessarily the one it had. So the expected delta is a band, not a line:
**1.23–1.90 V at 50 mA** (I × 24.6 Ω to I × 38 Ω). The 1.15 V at 50 mA that
this section used to quote (I × 23 Ω) left the PTC out.

Measure the board's own `R_PTC` at bring-up — the drop from TP5 (`LOAD`) to
TP17 (`PTC_OUT`) at a known current — and re-measure it after any trip. With
that number the delta becomes a tight check again. Either way it should grow
smoothly and monotonically with current, which makes it a useful diagnostic:

| What you see | What it means |
|---|---|
| delta ≈ I × (23 Ω + R_PTC) | working as designed |
| delta ≈ 0 at high current | Kelvin leads probably shorted to the force leads, or sensing the wrong node |
| delta scattered / non-monotonic | noise on ADC2, or a bad Kelvin connection — **or a PTC still recovering from a trip**, whose resistance drifts during the sweep |
| delta much larger than I × (23 Ω + R_PTC) | extra series resistance — lead, socket or contact. Rule out a recent trip first |

The expected resistance travels in the header as calibration constants,
not as a literal: `cal_r_iso_ohm` (22 Ω, the fitted part) and
`cal_r_ptc_ohm`, which is **`unset`** until the board's PTC has been measured.
Set `CT_R_PTC_OHM` in `core/ct_config.h` after bring-up. Because a trip moves
it, the host also takes an override without a reflash:
`vds_delta_report(sweep, r_ptc_ohm=...)` or `python -m ct_host extract
--diagnostics --r-ptc OHM`. While it is unset, the report says to measure it
and prints the R_PTC the fit implies, against the nSMD010's 1.6–15 Ω band.

**Plot `vds_meas_v`, never `vds_set_v`.** The whole reason the instrument has
a four-wire sense is that the commanded value is wrong by over a volt at full
current. `vds_set_v` is retained for diagnosis and for reconstructing what
was asked for, not for plotting.

### Raw accumulators

`i_acc` and `v_acc` are the **sum** of `oversample_n` conversions, not the
mean — with the default 64 samples they span 0..262080.

They are in the format so an archived sweep survives a calibration change.
If the 3.32 gain turns out to be 3.31 on the bench, or the shunt measures
0.998 Ω, every CSV ever captured can be re-derived from the raw counts using
the `cal_*` header fields. Without them, a calibration correction would mean
re-measuring every device. Nine extra bytes a row is a cheap insurance
premium against that.

To re-derive:

```python
mean     = i_acc / oversample_n
volts    = mean / cal_adc_full_scale * cal_vref
i_shunt  = volts / (cal_diffamp_gain * cal_shunt_ohm) * 1000     # mA
v_dut    = v_acc / oversample_n / cal_adc_full_scale * cal_vref * cal_vdiv
i_ma     = i_shunt - v_dut / cal_rdiv_ohm * 1000                 # schema 2
```

**Why the subtraction (schema 2).** The ÷4 Kelvin divider (300k/100k,
blueprint §3.4) hangs across the DUT, on the DUT side of the shunt, so the
shunt carries `I_DUT + V_DS / 400 kΩ`: 2.5 µA per volt. The firmware reports
and current-limits on the DUT's share alone. A **schema-1** capture has no
`cal_rdiv_ohm` and its `i_meas_ma` is the shunt current; re-derive it without
the last line, which is what the host does.

On range 1 the divider's 25 µA at 10 V is 0.6 of an LSB. The subtraction is
exact while the shunt reading is quantised, so a device that is off reads
within one LSB of zero on either side — **slightly negative is expected**,
and averages out once ADC noise dithers the oversampled mean. The correction
matters most on ranges 2 and 3, where 25 µA is most of full scale.

### The `flags` column and the current limit

**Any row with a non-empty `flags` field is not a valid measurement point.**
A host should filter on `flags == ""` by default.

Currently one flag exists, `ilimit`. When a measured current exceeds
`i_limit_ma`, the firmware — in this order, per blueprint §4:

1. zeroes the sweep DAC,
2. emits the offending point **with `flags=ilimit`**,
3. terminates both loops,
4. emits `# end: ilimit`.

The offending point is kept because it tells you *where* the DUT ran away,
which is exactly what you need to choose a lower ceiling. The ordering
matters: zeroing before emitting means the DUT is not held at an over-limit
bias for the ~5.5 ms the row takes to transmit. `tests/test_sweep.c` asserts
that ordering explicitly rather than trusting it.

### `# end:` reasons

| Reason | Meaning |
|---|---|
| `ok` | ran to completion (SWEEP only) |
| `ilimit` | aborted, firmware current limit |
| `stopped` | SWEEP: aborted by Ctrl-C. HOLD: ended by STOP, Ctrl-C or any other command; this is HOLD's normal end |

A transcript without an `# end:` line is **truncated** — treat it as a failed
capture, not a short sweep.

### Metadata the firmware cannot know

Two fields are host-supplied because the MCU genuinely has no way to
determine them. Both say so rather than guessing.

- **`date`** — a Nucleo has no battery-backed RTC time source. Set it with
  `SET date <ISO8601>` and the header reports `date_src: host`. Unset, it
  emits `date: unset` / `date_src: none`, and the host should stamp the file
  when saving.
- **`device`** — the firmware cannot identify what is in the socket. Defaults
  to `unknown`.

### Temperature is the MCU die, not the DUT

`temp_c` is the **STM32's internal die temperature**, labelled
`temp_src: mcu_die`. It is included because §5 asks for a temperature field,
but be clear about what it is not:

- it is **not** the DUT temperature, which is what a self-heating measurement
  needs;
- it is **not** ambient — it reads high by the MCU's own dissipation;
- the F303 has **no factory temperature calibration** (unlike L4/G4), so it is
  derived from the datasheet's *typical* V25 = 1.43 V and 4.3 mV/°C, both with
  wide tolerances. Treat it as indicative to a few degrees, not as a
  measurement.

If DC-vs-pulsed self-heating work needs real DUT temperature, that is an
external sensor, not this field.

---

## Command interface

Commands share the serial link with CSV output, are case-insensitive, and are
terminated by CR, LF or CRLF.

| Command | Effect |
|---|---|
| `ID` | firmware version, board, schema |
| `GET` | every parameter, one `# name: value` per line |
| `SET <name> <value>` | assign; replies `# ok: name=value` or `! err: ...` |
| `SWEEP` | run a sweep, emitting a full CSV block |
| `HOLD <vds>` | hold the drain at one level until STOP or any other command, one row per second ([HOLD](#hold)) |
| `STOP` | end a HOLD. A running **SWEEP** is aborted only by **Ctrl-C (0x03)**: the parser is blocked while a command runs, so a typed `STOP` waits in the receive queue until the sweep finishes |
| `HELP` | command list |

### HOLD

`HOLD <vds>` sets the sweep DAC to `<vds>` (0–10.96 V) and the gate DAC to
`vgs_list`'s **single** entry, and keeps them there. It exists for the bench,
where a level has to stay put long enough to read with a meter. A sweep
point lasts at most `settle_us` = 1 s, and the drain returns to zero at the
end. To hold a gate level, `SET vgs_list 10.95` first.

- **Gate.** `vgs_list` must have exactly one entry. With more, HOLD is
  rejected (`! err: HOLD needs vgs_list with exactly one entry`) rather than
  guessing which to use. The DACs are not touched.
- **Current limit, as the sweep does it.** The current is measured every
  `settle_us` (oversampled `oversample_n` times) and checked against
  `i_limit_ma` on **every** measurement, not only the reported ones. On
  exceedance the drain DAC is zeroed **before** the offending measurement is
  emitted, flagged `ilimit`, and HOLD ends with `# end: ilimit`.
- **Reporting.** One row per second (`CT_HOLD_REPORT_MS`), the first after
  the first `settle_us`, so a HOLD always reports at least one row. `point`
  counts reported rows. The rows are ordinary CSV rows; `vds_set_v` is the
  level the DAC code actually commands.
- **Ending.** STOP, Ctrl-C, or **any other command** ends it with
  `# end: stopped`; both DACs go to zero. The command that ended it is
  then executed normally (STOP replies `# stop: requested`). A bare CR or LF
  does not end it: the host's CRLF would otherwise end the hold at once.
- **Header.** The usual block, with `# mode: hold` (SWEEP says `dc`) and
  `# hold_vds_set_v:` before the column header. `n` and `vds_max` are
  printed as the current parameter values; HOLD does not use them.

```
SET vgs_list 0
SET i_limit_ma 60
HOLD 5
...rows, one per second...
STOP
```

From the host: `python -m ct_host hold --port <port> --vds 5 --seconds 30 -o
hold.csv`, or `ct_host.protocol.run_hold()`. Against the simulator its clock
is simulated, so "one per second" means simulated seconds and rows arrive far
faster than that.

### Settable parameters

| Name | Default | Range | Notes |
|---|---|---|---|
| `settle_us` | 50 | 1 – 1000000 | blueprint §4; the 1 kΩ × 10 nF ADC1 filter (τ = 10 µs) binds, not the amplifier. DUT settling may need more |
| `n` | 200 | 2 – 4096 | points per gate step |
| `oversample_n` | 64 | 1 – 1024 | samples summed per reading |
| `i_limit_ma` | 60 | 0.001 – 165 | **DUT protection ceiling** |
| `vds_max` | 10.0 | 0.1 – 10.96 | ceiling is DAC full scale × 3.32 |
| `vgs_list` | `0` | 0 – 10.96, ≤16 entries | comma-separated, no spaces |
| `device` | `unknown` | ≤31 chars | no `,` `#` CR LF |
| `date` | unset | ≤31 chars | ISO 8601 from the host |

`range` is reported but **rejects writes** in this build.

**Setters reject, they never clamp.** `SET i_limit_ma 500` is an error and
leaves the old value in place; it does not silently become 165. For a DUT
protection ceiling, a silently-adjusted value is a safety bug, not a
convenience. The same applies to `vgs_list`: a malformed list leaves the
previous one entirely intact rather than partially applying.

### Example session

```
SET device 2N7000
SET date 2026-09-28T14:03:11Z
SET vgs_list 2.5,3.0,3.5,4.0
SET vds_max 8
SET i_limit_ma 55
SET n 200
SWEEP
```

---

## Testing without hardware

`core/` depends only on `core/ct_device.h`, a struct of function pointers.
Two implementations satisfy it:

- `stm32/Core/Src/ct_hal_device.c` — real DACs, ADCs and UART
- `sim/ct_sim_device.c` — a modelled DUT, with output captured to a buffer

The sweep engine cannot tell them apart, so every test below runs the
**actual firmware logic**, not a reimplementation of it.

```sh
make            # build the simulator and the test binaries
make test       # run all four C suites
make demo       # a short MOSFET sweep to stdout
pytest tests/test_csv_contract.py
```

The simulator is also a standalone tool that speaks the real protocol, so the
Python host can be developed against it with no board attached. It **streams**
— each line is written and flushed as the sweep produces it, exactly as rows
arrive over the serial link — so the host's live plot is developed and tested
against it rather than against a replayed file:

```sh
printf 'SET n 50\nSET vgs_list 2.5,3.0,3.5\nSWEEP\n' | ./build/ct_sim --dut mosfet
./build/ct_sim --dut diode --noise 8 < commands.txt > data/sim_diode.csv
```

### What the models are

| `--dut` | Model |
|---|---|
| `mosfet` | square-law with a subthreshold exponential tail; `--vth`, `--k`, `--lambda` |
| `diode` | `I = Is(exp(V/nVt) − 1)`; `--is`, `--n-diode`, `--rs` |
| `resistor` | ohmic; `--rload`. The simplest way to trip the current limit |

Front-end options, for any `--dut`: `--rptc OHM` (the drain-path PTC; off
by default), `--rdiv OHM` (the Kelvin divider; 400 kΩ by default),
`--rpar OHM` (a resistor clamped across D–S with the DUT, which the firmware
reports as DUT current; off by default) and `--dac-floor V` (the lowest node
voltage the sweep DAC reaches; ideal by default).

The simulator models the **whole signal chain**, not just the device: the
commanded voltage becomes a node voltage, the DUT draws current, that current
drops across `R_iso` and the shunt, and what remains is what ADC2 would
Kelvin-sense. So `vds_set_v` and `vds_meas_v` differ in simulation for the
same physical reason they differ on the bench, and the tests can assert the
23 Ω relationship above. **The simulator has no PTC unless `--rptc` is
given**, so by default its delta is the low edge of the board's band,
I × 23 Ω, not the middle of it.

**It is a test fixture, not a circuit simulator.** No reactive elements, no
settling, no loop dynamics — sims 08–11 in `sim/` cover those. Its purpose is
to exercise the sweep engine, the CSV writer and the current limit.

### What the tests cover

| Suite | Checks |
|---|---|
| `test_sweep.c` | row counts, header ordering, **limit fires**, **DAC zeroed before emit**, STOP, settle called per point, ramp endpoints, accumulator semantics, the `vds` delta |
| `test_csv.c` | row shape, field count, float formatting and rounding, buffer-overflow safety, framing rule, CRLF, metadata presence |
| `test_params.c` | bounds rejection, `vgs_list` parsing, unit conversions, command parsing, line framing, overlong lines |
| `test_hold.c` | HOLD: held levels and one report per second, **limit checked between reports**, **DAC zeroed before the flagged row**, rejection without touching the DACs (bad value, two gate values), Ctrl-C, the no-clock fallback, SWEEP still `dc` |
| `test_csv_contract.py` | the format as a naive Python host consumes it, **no truncation on a full-size family**, **output streams rather than arriving in one block** |

Current status: **230 C checks and 16 pytest cases, all passing** (2026-10-09).

---

## Pin assignments

**Every pin below is a choice made while writing this firmware. The blueprint
specifies none of them. Check each against the Nucleo-F303RE pinout before
flashing.**

| Signal | Pin | Peripheral | Arduino / connector | Why this pin |
|---|---|---|---|---|
| Gate / step source | **PA4** | `DAC1_OUT1` | A2 (CN8-3) | DAC1 channel 1 |
| Sweep source | **PA5** | `DAC1_OUT2` | D13 (CN10-11), **jumpered to CN10-13** | the F303RE's only other DAC output; the board takes it at PA6. **SB21 fitted, LD2 loads it** — see below |
| (sweep, board side) | **PA6** | analog, high-Z | D12 (CN10-13) | where the board's DAC_SWEEP lands; held analog so it never drives against PA5 |
| Current sense | **PA0** | `ADC1_IN1` | A0 (CN8-1) | §4 assigns current to ADC1 |
| Voltage sense | **PC0** | `ADC2_IN6` | A5 (CN8-6) | §4 assigns voltage to ADC2; PA4–PA7 are taken |
| Serial TX | **PA2** | `USART2_TX` | ST-LINK VCP | fixed by the board |
| Serial RX | **PA3** | `USART2_RX` | ST-LINK VCP | fixed by the board |
| Die temperature | — | `ADC1_IN16` | internal | not a DUT reading |

### The sweep DAC: PA5, jumpered to PA6

**The F303RE has one DAC peripheral, DAC1, with two outputs: PA4 and PA5.**
This file used to put the sweep source on `DAC2_OUT1`, PA6. DAC2 exists only
on the F303x6/x8, F328 and F334, and `stm32f303xe.h` defines no DAC2. The
first build against ST's real headers failed on it (2026-10-23). The earlier
compile check used stub headers that defined DAC2, so it could not catch
this (blueprint §11). The board was already built with DAC_SWEEP on PA6
(CN10-13) and CN10-11 left open.

**Option A, taken** (Daniel, 2026-10-24): the sweep source is `DAC1_OUT2`
on PA5, carried to the board on the Nucleo itself.

- A 2.54 mm shunt joins **CN10-11 (PA5) to CN10-13 (PA6)**, on the morpho
  pins on the Nucleo's top side.
- PA6 is set **analog** in `MX_GPIO_Init`, before any DAC starts, so it has
  no output driver and cannot fight PA5. From reset until then it is a
  floating digital input, also high-impedance.
- **SB21 stays fitted for now** (Daniel, 2026-10-25; `hardware/DECISIONS.md`
  R2-3). LD2, the green user LED, and its 510 Ω resistor hang on PA5. They
  load the DAC beyond its 5 kΩ rating from PA5 ≈ 2.0–2.3 V, 6.6–7.8 V at the
  feedback node. H4 never needs that range. Above it `vds_set_v` is not
  what the DAC produced, and full-range sweeps may fall short. Removing
  SB21 is the fallback.
- H4 prep P1a fits the shunt. P1b, which was to map where the LED load
  starts to bite, is skipped (Daniel, 2026-10-30): not measured.

**Why not a Nucleo-F334R8** (which has DAC2 on PA6, so the board would work
unchanged):

- the F303RE is already in hand, and the F334R8 cost ~$11 and ~3 days;
- the F334's DAC2 has no output buffer, up to 15 kΩ out. The DAC feeds IN+,
  not the critical IN− node, so that RC is on the command path, outside the
  loop. But it stops IN+ being held at AC ground above roughly 1.3–2.2 MHz,
  around the ~3 MHz crossover. The 1.6 pF differential input capacitance,
  which `hardware/CONTINGENCY.md` §2A counts at IN− as fixed, would become
  frequency-dependent there: an unmodelled change to C_in, on the parameter
  §3.1 treats as critical;
- A puts both sources back on one peripheral, so the synchronised
  dual-channel update that was lost on PA6 is available again if pulsed
  mode returns.

**Range.** Both channels run with the output buffer on, for the same
low-impedance reason. Buffered, the F3's DAC output is guaranteed only from
**0.2 V to VDDA − 0.2 V**, 0.66 V to 10.29 V after the ×3.32 gain, not
0–10.96 V. Better parts get closer to the rails. The floor matters more
than the ceiling: sweeps start at V_DS = 0, and the diode fit lives at the
low end. H4 prep P1b was to record this part's actual minimum and maximum; it is
skipped (Daniel, 2026-10-30), so this stays open (blueprint §3.5, *Range*).

### "USB CDC" is the ST-LINK VCP

Blueprint §4 originally said "USB CDC virtual COM", which describes what the
*host* sees. The F303RE's native USB device peripheral (PA11/PA12) is **not
routed to a connector on a Nucleo-64** — no socket, no pull-up. The board's
VCP is the ST-LINK's, wired to USART2, and it enumerates on the PC as a USB
CDC serial port.

So the host opens an ordinary serial device at 115200, and the firmware needs
**no USB stack, no descriptors, no middleware**. Do not add USB device
middleware to this project; on this board it would have nothing to connect
to. Corrected in blueprint §4.

### Peripheral configuration

If the `.ioc` misbehaves, this table is authoritative — recreating the project
from it takes a few minutes.

| Peripheral | Setting |
|---|---|
| Clock | HSI 8 MHz → PREDIV /1 → PLL ×9 → **72 MHz**, Flash latency 2. (Was written as /2 → ×18: the F3 PLL stops at ×16, and the fixed HSI/2 input is the F303xB/C, not the xE) |
| | HSI not HSE: the Nucleo's 8 MHz comes from the ST-LINK MCO, absent when standalone |
| AHB / APB1 / APB2 | ÷1 / ÷2 / ÷1 → 72 / 36 / 72 MHz |
| ADC12 clock | PLL ÷1 → 72 MHz |
| ADC1, ADC2 | 12-bit, single-ended, software trigger, scan off, **601.5-cycle sampling** |
| DAC1, channels 1 and 2 | 12-bit right-aligned, trigger none, **output buffer enabled** on both |
| USART2 | 115200 8N1, TX+RX, RXNE and TC interrupts, priority 1 |
| TIM6 | prescaler 71 → 1 MHz free-running, for the µs delay |

Both ADCs are calibrated at startup (`HAL_ADCEx_Calibration_Start`). On the
F303 an uncalibrated ADC can sit several LSB off, which on range 1 is tens of
microamps.

---

## Timing

At 115200 baud a ~64-byte row takes **~5.5 ms** to transmit, against **~1.1 ms**
for 128 conversions (2 channels × 64 samples at 601.5 cycles). **Transmission
dominates.**

A blocking write would therefore hold the DUT at each bias point roughly five
times longer than the measurement needs — the self-heating that pulsed mode
exists to suppress. So TX is an interrupt-driven 4 KB ring buffer, and
`ct_hal_tx_pump()` is called from inside the conversion and delay loops so
transmission overlaps measurement. A 200-point sweep lands near **1.2 s**.

The ring only blocks if the host stops reading, and then only at the point
where it fills.

---

## Building

### Host (simulator and tests)

```sh
make            # gcc/clang, no dependencies beyond libm
make test
```

Built with `-Wall -Wextra -Wpedantic -Wshadow -Wconversion -Werror`.

### STM32

`stm32/` holds hand-written sources, a linker script and a Makefile. ST's
HAL and CMSIS are not vendored: `make drivers` fetches them from ST's
GitHub (STM32CubeF3 **v1.11.4**, the package the `.ioc` names, checked by
commit) into `stm32/STM32CubeF3/`, which is gitignored.

```sh
cd stm32
make drivers    # once
make            # build/curve-tracer.elf, .bin, .hex
make flash      # copies the .bin onto the Nucleo's ST-LINK USB drive
```

Project sources (`stm32/Core/`, `core/`) build with the host's warning flags
and `-Werror`; the HAL builds with `-Wall`, not fatal.

**Toolchain:** Arm GNU Toolchain **14.3.Rel1** (GCC 14.3.1 with
newlib-nano), the same GCC STM32CubeIDE 2.2.0 bundles. It was installed on
2026-10-23 from Arm's darwin-arm64 tarball, whose SHA-256 matched Arm's
published digest. It lives in
`~/.local/opt/arm-gnu-toolchain-14.3.rel1-darwin-arm64-arm-none-eabi`, with
its binaries symlinked into `~/.local/bin`. To upgrade, extract a newer
tarball beside it and re-point the symlinks. Homebrew's `arm-none-eabi-gcc`
formula ships without a C library and will not link this firmware.

**Not through CubeIDE or CubeMX.** STM32CubeIDE 2.x no longer contains
CubeMX, so it cannot open `curve-tracer.ioc` or generate code from it;
that needs the standalone STM32CubeMX, which is not installed. Do not
generate code into `stm32/` anyway: these sources have no `USER CODE`
markers, and CubeMX rewrites `main.c`, `stm32f3xx_it.c` and
`stm32f3xx_hal_msp.c` outside them. The `.ioc` is a record of the
peripheral settings, unvalidated; the table above is authoritative.

---

## Known limitations

- **Range 1 only.** Ranges 2 and 3 need the jumper and a `range` command.
- **No pulsed mode.** `duty_off_us` is deliberately absent from the parameter
  table rather than present and ignored.
- **No auto-ranging.**
- **No calibration storage.** The `cal_*` constants are compile-time, in
  `core/ct_config.h`. Bench calibration currently means editing and
  reflashing — though because the raw accumulators are in the CSV, past
  captures can be corrected without re-measuring.
- **Die temperature is uncalibrated** and is not a DUT reading.
- **Nothing here has run on hardware.** As of 2026-09-28 the bench is blocked
  on a lab trainer fault (`docs/characterization.md`, 2026-09-24), so every
  figure in this file comes from the host simulation or from datasheets. The
  pin assignments have been checked against ST's device headers by a real
  build (2026-10-23), but never against a running board.
