leedanie2/curve-tracer/hardware/review/pass1/p1_3d.png

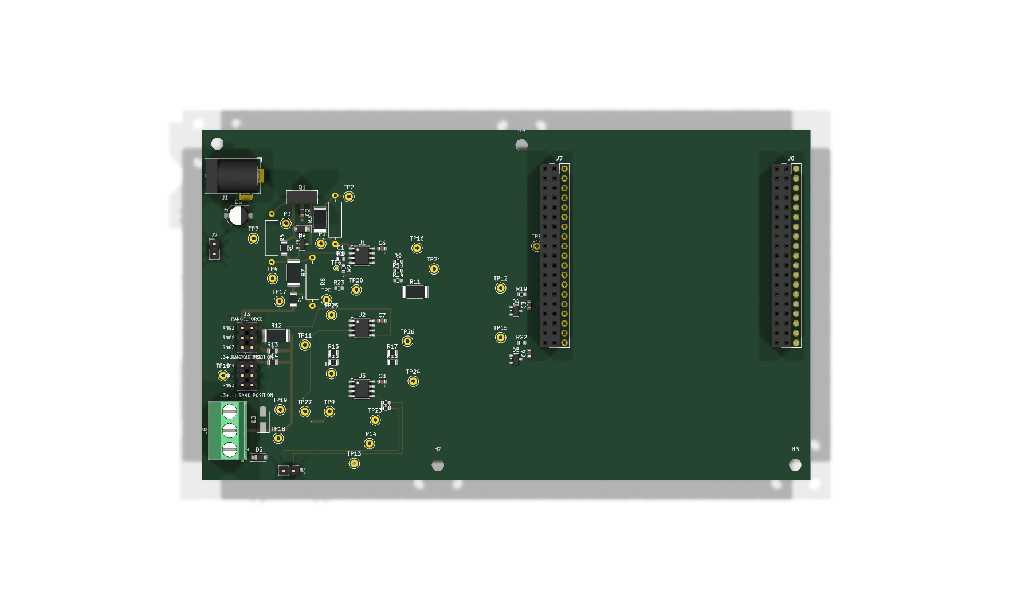
hardware/review/pass1/p1_3d.png
