leedanie2/curve-tracer/hardware/review/pass1/p1_decoupling.png

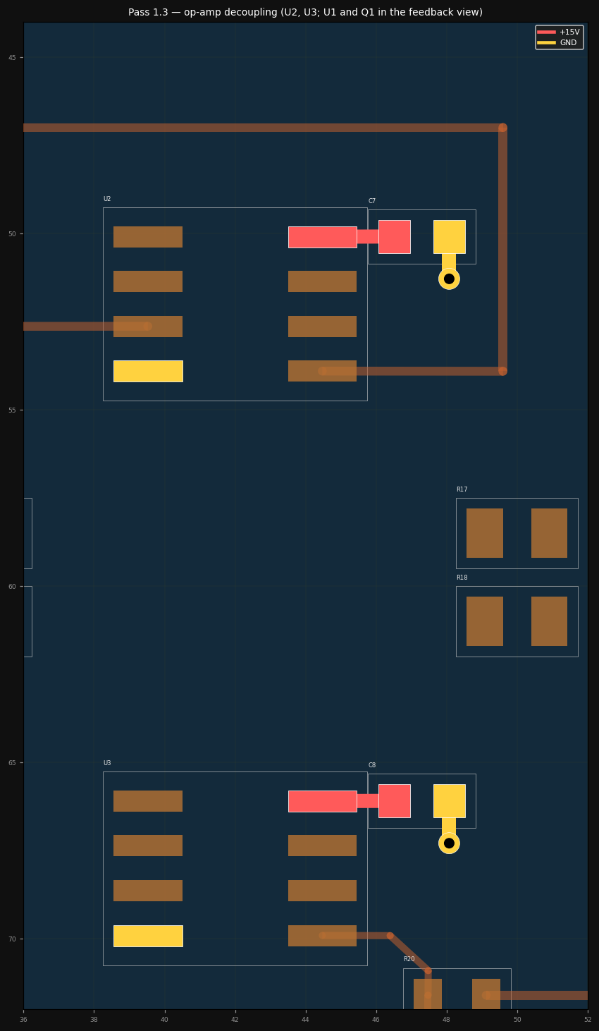
hardware/review/pass1/p1_decoupling.png
