leedanie2/curve-tracer/hardware/review/pass1/p1_feedback.png

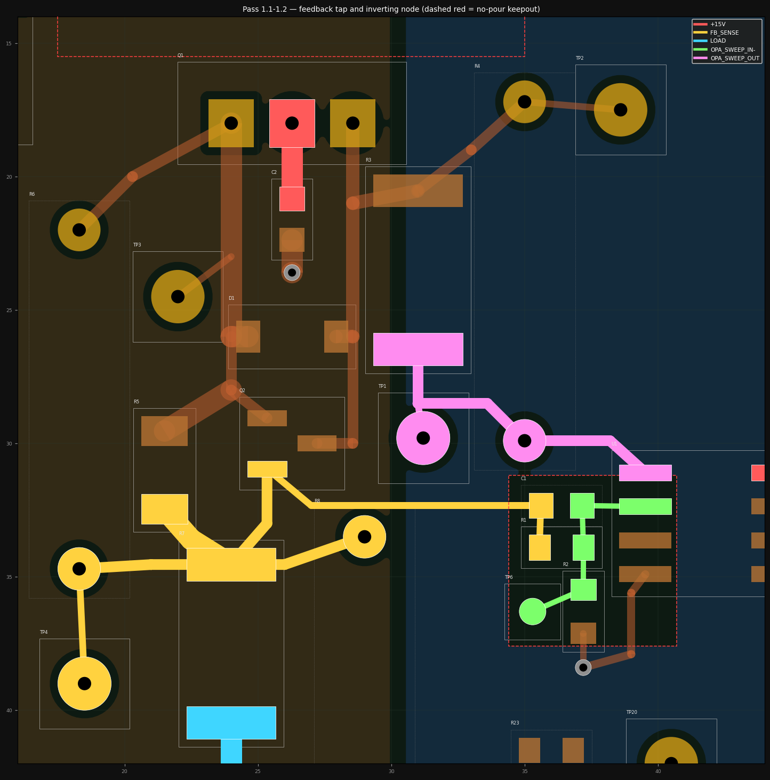
hardware/review/pass1/p1_feedback.png
