leedanie2/curve-tracer/hardware/review/pass1/p1_kelvin.png

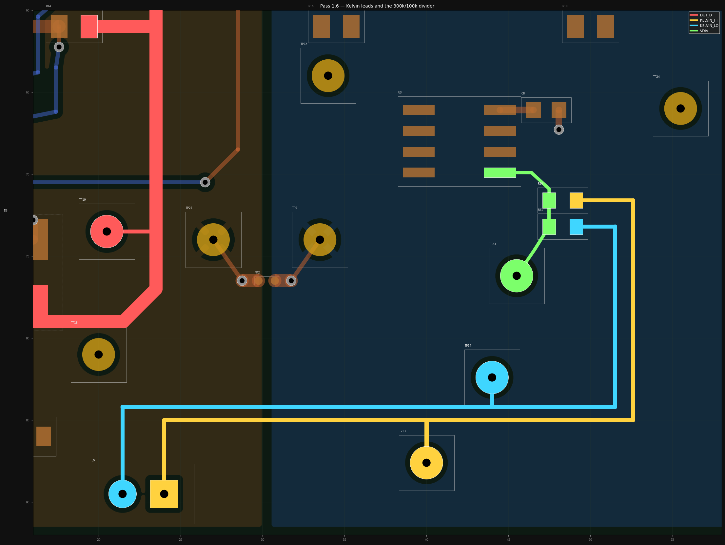
hardware/review/pass1/p1_kelvin.png
