leedanie2/curve-tracer/hardware/review/pass1/p1_overview.png

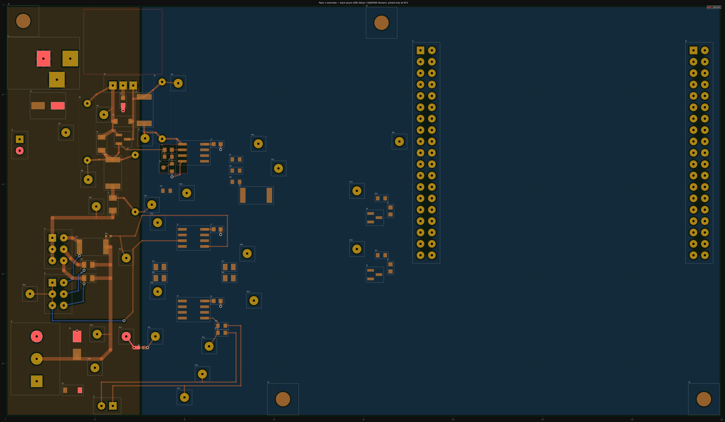
hardware/review/pass1/p1_overview.png
