leedanie2/curve-tracer/hardware/review/pass1/p1_shunt.png

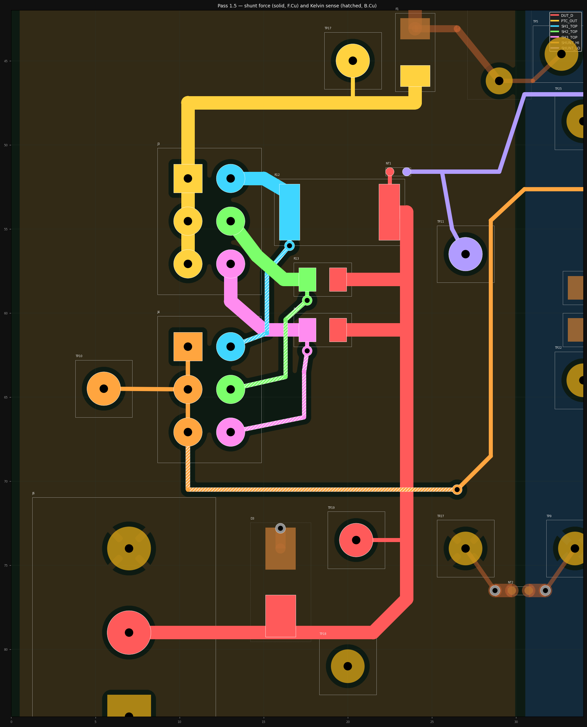
hardware/review/pass1/p1_shunt.png
