leedanie2/curve-tracer/hardware/review/pass1/p1_star.png

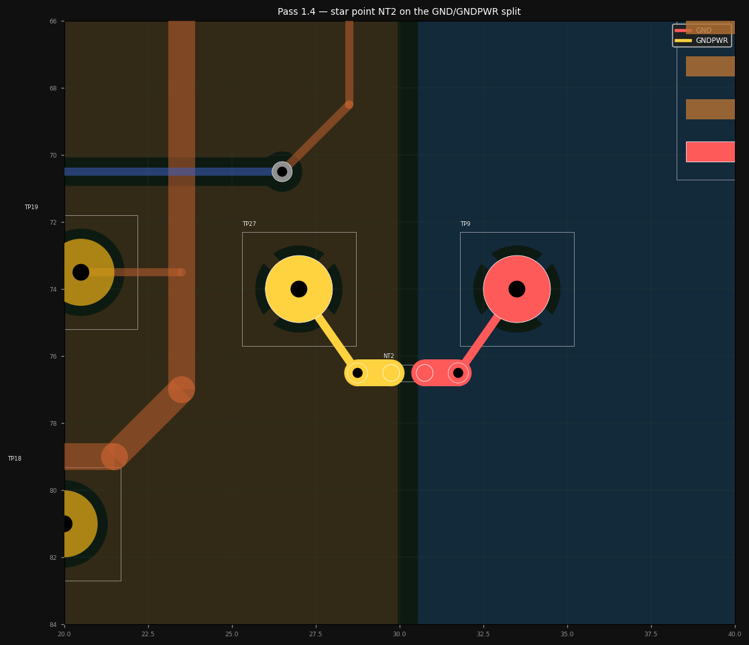
hardware/review/pass1/p1_star.png
