leedanie2/curve-tracer/hardware/review/pass2/p2_bottom.png

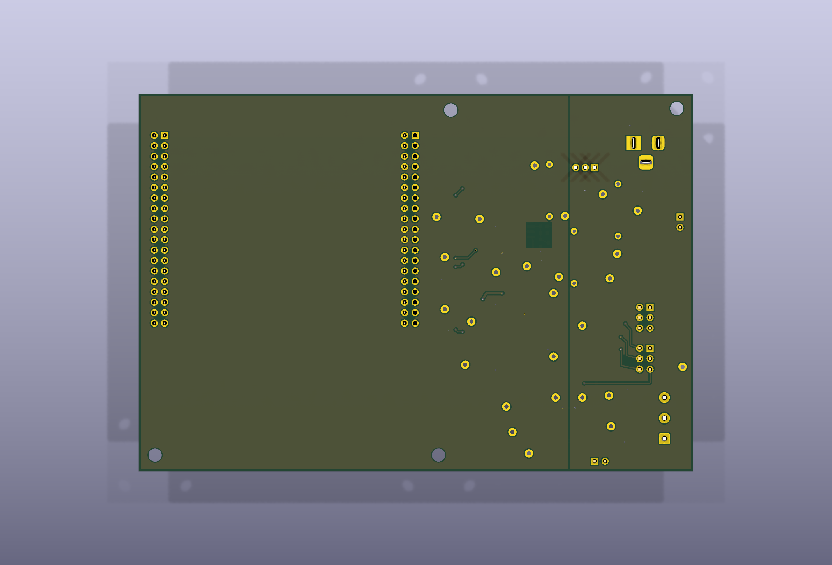
hardware/review/pass2/p2_bottom.png
