leedanie2/curve-tracer/hardware/review/pass2/p2_orientation.png

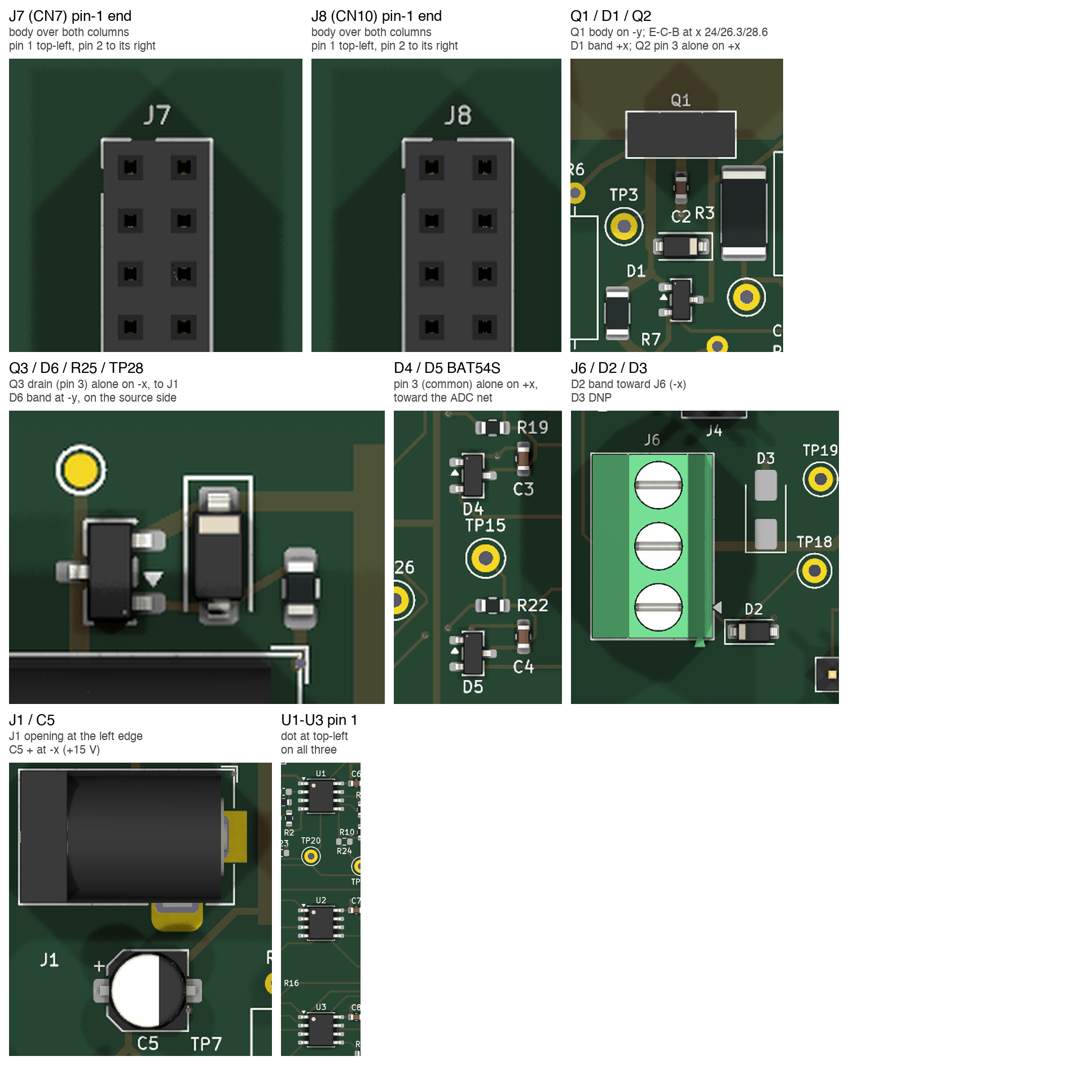
hardware/review/pass2/p2_orientation.png
