leedanie2/curve-tracer/hardware/review/pass2/p2_split_crossings.png

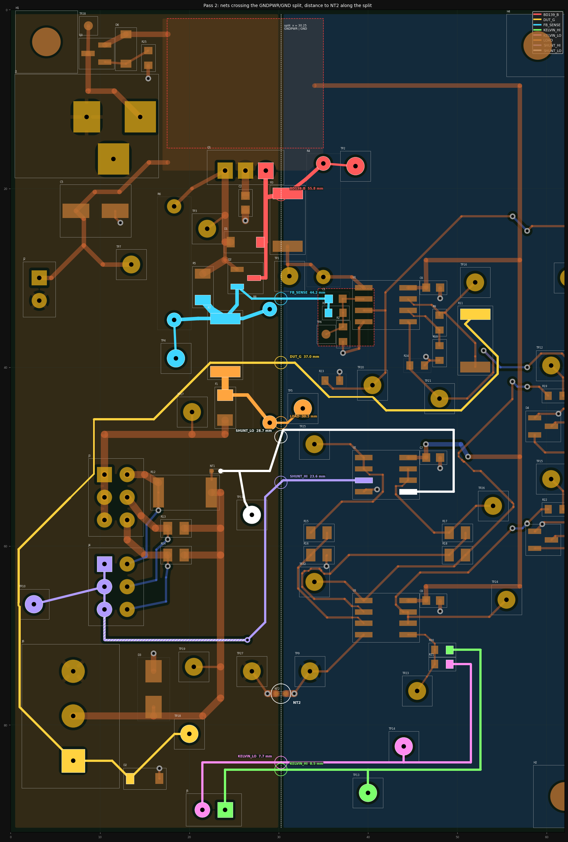
hardware/review/pass2/p2_split_crossings.png
