leedanie2/curve-tracer/host/h4/mvp_17_diode_rp.png

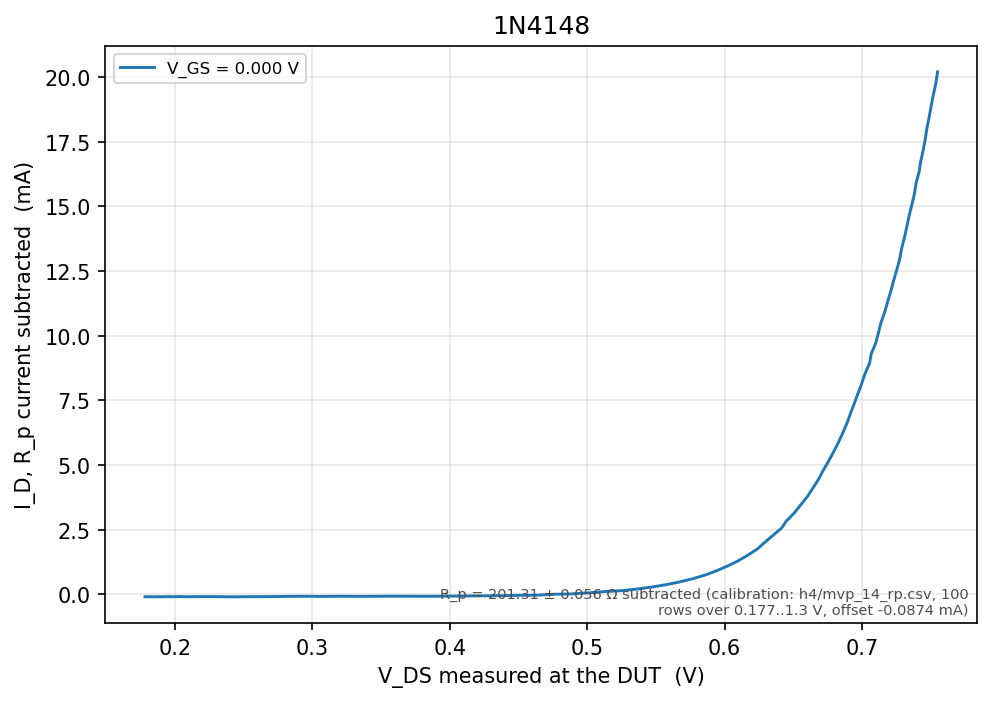
host/h4/mvp_17_diode_rp.png
