leedanie2/curve-tracer/host/h4/mvp_18_mosfet_rp.png

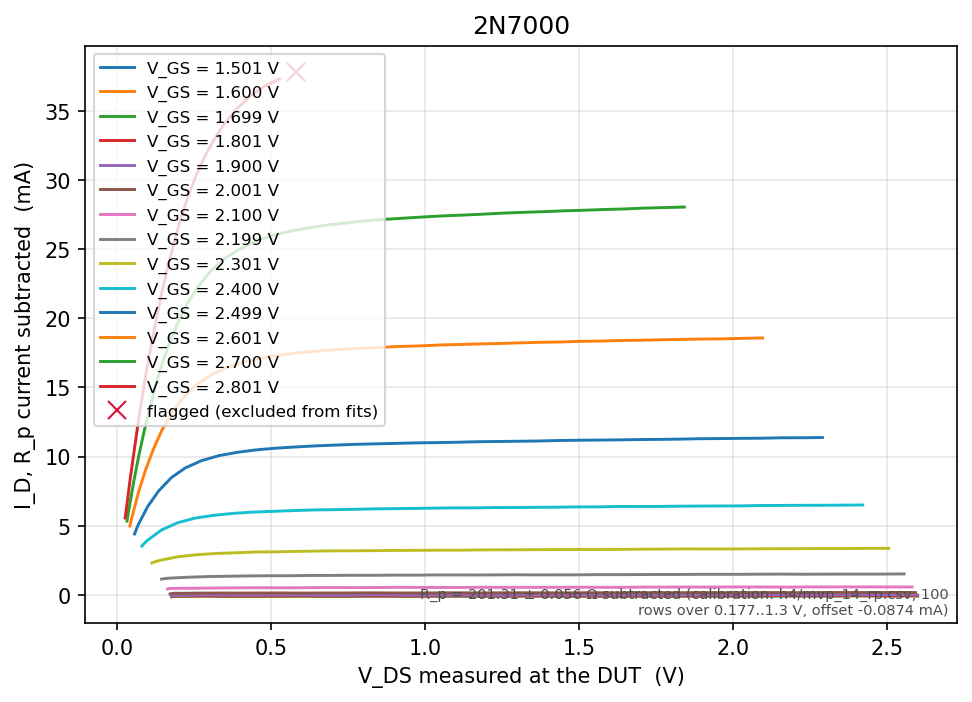
host/h4/mvp_18_mosfet_rp.png
