leedanie2/curve-tracer/host/h4/s3_25_mosfet.png

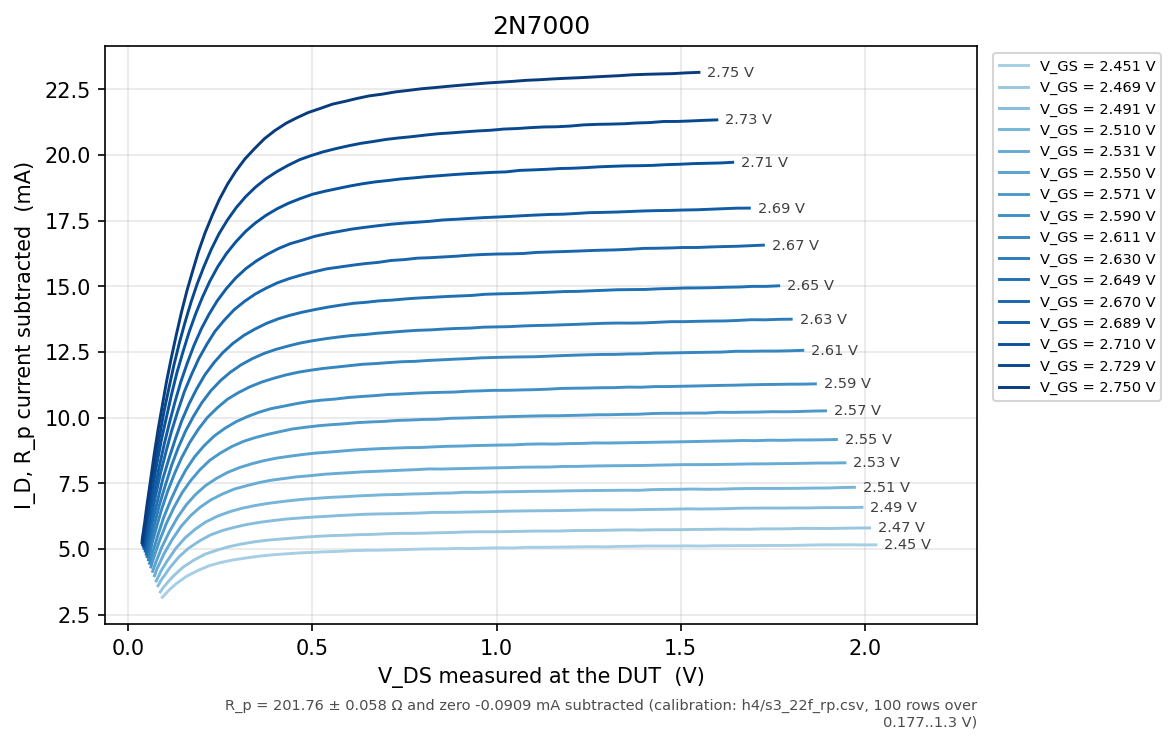
host/h4/s3_25_mosfet.png
