leedanie2/curve-tracer/media/demo_overlay_diode_SIMULATED.png

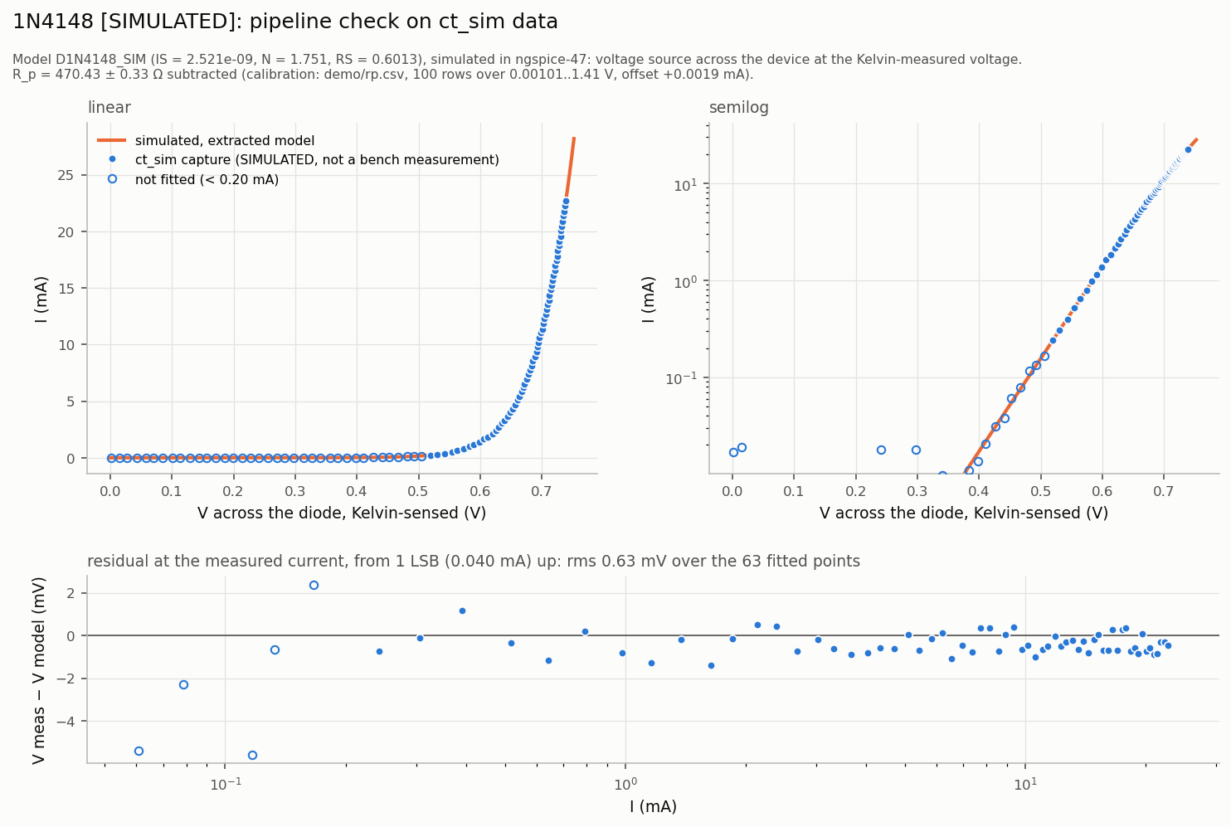
media/demo_overlay_diode_SIMULATED.png
