leedanie2/curve-tracer/media/demo_overlay_mosfet_SIMULATED.png

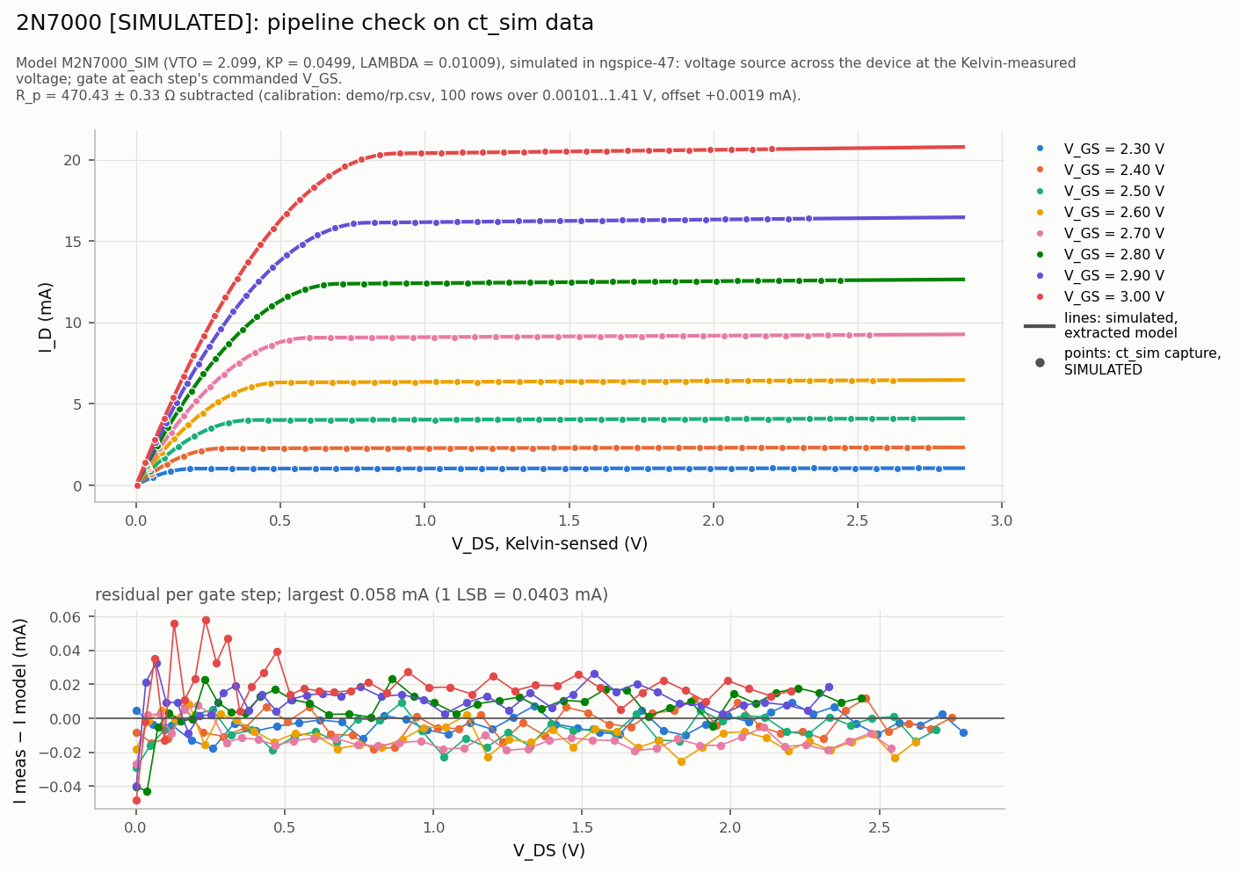
media/demo_overlay_mosfet_SIMULATED.png
