leedanie2/curve-tracer/media/overlay_2n7000_s3.png

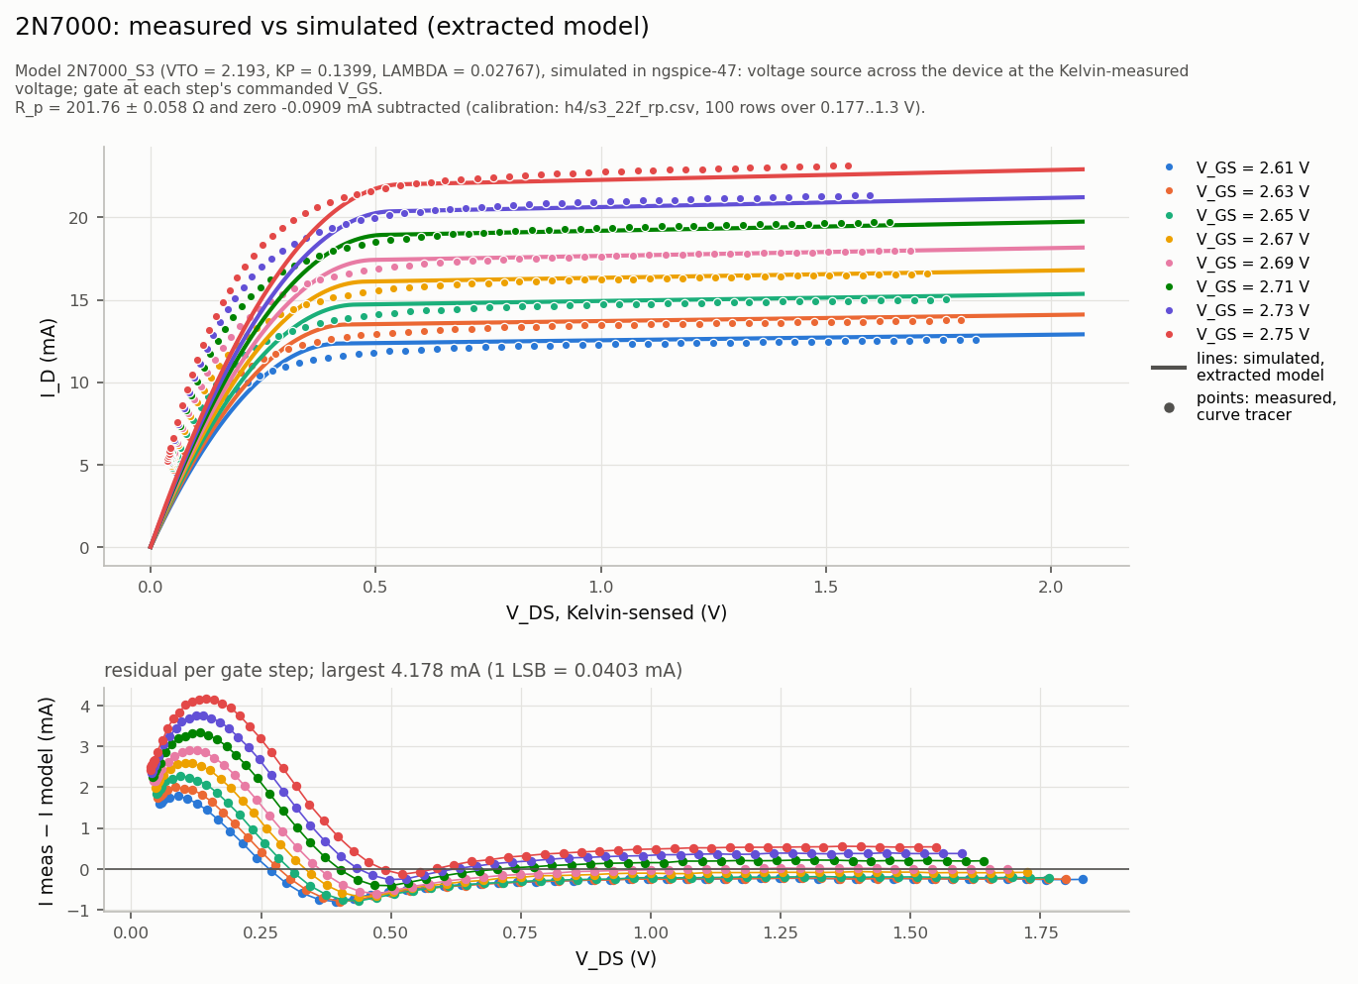
media/overlay_2n7000_s3.png
