leedanie2/curve-tracer/hardware/orders/LCSC__WM2610120117_20261012094515.csv

LCSC Part Number | Manufacture Part Number | Manufacturer | Customer NO. | Package | Description | RoHS | Quantity | Unit Price($) | Ext.Price($) | Estimated lead time (business days) | Updated lead time | Date Code / Lot No.
C100114 | 2.54 | BOOMELE(Boom Precision Elec) |  | P=2.54mm | Capped 2.54mm P=2.54mm Shunts, Jumpers | YES | 50 | 0.0094 | 0.47
C2836771 | 0603CG3R3B500NT | FH |  | 0603 | 3.3pF 50V Ceramic Capacitor C0G 0603 | YES | 50 | 0.0127 | 0.64
C507055 | 0603CG1R5B500NT | FH |  | 0603 | 1.5pF 50V Ceramic Capacitor C0G 0603 | YES | 100 | 0.0066 | 0.66
C313085 | 0603CG2R2B500NT | FH |  | 0603 | 2.2pF 50V Ceramic Capacitor C0G 0603 | YES | 50 | 0.0118 | 0.59
C2836769 | 0603CG2R7B500NT | FH |  | 0603 | 2.7pF 50V Ceramic Capacitor C0G 0603 | YES | 50 | 0.0129 | 0.65
C162229 | GRM1885C1H3R9BA01D | muRata |  | 0603 | 3.9pF 50V Ceramic Capacitor C0G 0603 | YES | 10 | 0.1428 | 1.43
C313086 | 0603CG4R7B500NT | FH |  | 0603 | 4.7pF 50V Ceramic Capacitor C0G 0603 | YES | 100 | 0.0095 | 0.95
C172930 | MFR1WSFTE52-200R | YAGEO |  | Through Hole,D3.3xL9mm | 200Ω 1W Metal Film Resistor ±50ppm/℃ ±1% Through Hole,D3.3xL9mm Through Hole Resistors | YES | 20 | 0.0303 | 0.61
C1882781 | C317C104K5R5TA7301 | KEMET |  | Through Hole | 100nF ±10% 50V Ceramic Capacitor X7R Through Hole | YES | 5 | 0.524 | 2.62
C385394 | RN1WS47ΩFT/BA1 | TyoHM |  | Through Hole,D3.3xL9.2mm | 47Ω 1W 350V Metal Film Resistor ±50ppm/℃ ±1% Through Hole,D3.3xL9.2mm Through Hole Resistors RoHS | YES | 20 | 0.0269 | 0.54
C172941 | MFR1WSFTE52-330R | YAGEO |  | Through Hole,D3.3xL9mm | 330Ω 1W Metal Film Resistor ±50ppm/℃ ±1% Through Hole,D3.3xL9mm Through Hole Resistors | YES | 20 | 0.0319 | 0.64
C2057972 | OPA2196IDR | TI |  | SOIC-8 | Standard (General Purpose) Amplifier 2 Circuit Rail-to-Rail Input, Rail-to-Rail Output SOIC-8 | YES | 2 | 1.5405 | 3.08
C113957 | SMAJ12A | MDD(Microdiode Semiconductor) |  | DO-214AC(SMA) | 19.9VC Clamp 20.1A@10/1000us Ipp TVS DIODE DO-214AC(SMA) | YES | 20 | 0.0432 | 0.86
C410695 | RN1/4W10KFT/BA1 | TyoHM |  | Through Hole,D2.4xL6.5mm | 10kΩ 250mW 250V Metal Film Resistor ±50ppm/℃ ±1% Through Hole,D2.4xL6.5mm Through Hole Resistors RoHS | YES | 50 | 0.0145 | 0.73
C410692 | RN 1/4W 10R F T/B A1 | TyoHM |  | Through Hole,D2.4xL6.4mm | 10Ω 250mW 250V Metal Film Resistor ±100ppm/℃ ±1% Through Hole,D2.4xL6.4mm Through Hole Resistors RoHS | YES | 50 | 0.013 | 0.65
