leedanie2/curve-tracer/sim/00_inverting_amp_smoke_test.asc

R1: res; 10k
R2: res; 100K; tol=1 pwr=0.1
U1: UniversalOpAmp2
V1: voltage; SINE(0 0.1 1k); AC 1
V2: voltage; -15
V3: voltage; 15
Named nets: 0
.ac dec 100 1 10Meg
