leedanie2/curve-tracer/sim/08_sweep_source_rb_sweep.asc

C1: cap; {Cload}
Rbase: res; {Rb}
Rf: res; 23.3k
RG: res; 10k
Ri: res; 22
RL: res; {RLv}
U1: UniversalOpAmp2
V1: voltage; 15
V2: voltage; PULSE({vlo} {vhi} 1u 100n 100n 100u 40m)
X: npn; BD139
Named nets: 0, emitter
.tran 0 20m 0 10n
.include models/BD139.LIB
.step param Rb list 100 220 330 390 470 680
.step param lcase list 1 2 3 4
.step param tcase list 1 2
.param vlo=table(tcase,1,1.5,2,0.3)
.param vhi=table(tcase,1,1.6,2,2.7)
.param Cload=table(lcase,1,100n,2,100n,3,100p,4,100p)
.param RLv=table(lcase,1,200,2,1e9,3,200,4,1e9)
.save V(emitter) V(n004) I(Rbase)
.meas tran vbase FIND V(emitter) AT 0.9u
.meas tran vmax MAX V(emitter) FROM 1u TO 90u
.meas tran vfin FIND V(emitter) AT 90u
.meas tran os PARAM 100*(vmax-vfin)/(vfin-vbase)
.meas tran cl PARAM Cload
.meas tran rl PARAM RLv
.meas tran taupred PARAM Cload*RLv*33322/(RLv+33322)
