leedanie2/curve-tracer/sim/11_limit_sizing.asc

C1: cap; {Cload}
D1: diode; 1N4148
Q2: npn; 2N3904
Rbase: res; {Rb}
Rf: res; 23.3k
RG: res; 10k
Riso: res; 22
RL: res; R=if(time>3.2m,1Meg,pow(10,6-7*min(max((time-0.2m)/2m,0),1)))
Rsense: res; {Rs}
U1: UniversalOpAmp2; Ilimit={ilim} Rail=0 Vos=0
V1: voltage; 15
V2: voltage; {vin}
X: npn; BD139
Named nets: 0, e_bjt, fb, out, base, oa
.tran 0 3.6m 0 10n
.include models/BD139.LIB
.step param Rb list 330 470 680
.step param Rs list 10 12 15
.step param vin list 3.0 3.3
.param ilim=65m
.param Cload=100p
.meas tran ilimit PARAM ilim
.save V(fb) V(out) V(base) V(e_bjt) V(oa) I(Rbase) I(Rsense) Ic(Q2) Ib(Q2)
Load: open (1 MEG) to 0.2 ms, log ramp to 0.1 ohm by 2.2 ms,
short held to 3.2 ms, then snapped back open to watch recovery.
op-amp Ilimit fixed at 65m (OPA2197 typ). Joint R_B / R_sense sizing:
target <= 65 mA LOAD current in a hard short.
vin 3.0 = 10 V setpoint; 3.3 = DAC full scale, 11 V at fb (the 50 mA spec corner).
