leedanie2/curve-tracer/sim/07_diffamp_buffered.cir

* Diff amp input loading WITH input buffers - no DUT connected
.param R1n=1k R2n=20k
.param Rsh=1
V1  na 0 DC 10
Rs  na nb {Rsh}
Eba bufa 0 na 0 1
Ebb bufb 0 nb 0 1
R1  bufb inm {R1n}
R2  inm out {R2n}
R3  bufa inp {R1n}
R4  inp 0  {R2n}
E1  out 0 inp inm 1e5
.step param Rsh list 1 100 10k
.op
.meas op vout find V(out)
.end
