leedanie2/curve-tracer/sim/03_sweep_source_load_sweep.asc

C1: cap; {Cload}
Rbase: res; 100
Rf: res; 23.3k
RG: res; 10k
Ri: res; 22
RL: res; 200
U1: UniversalOpAmp2
V1: voltage; 15
V2: voltage; PULSE(1.5 1.6 1u 100n 100n 100u 200u)
X: npn; BD139
Named nets: 0
.tran 0 200u 0 10n
.include models/BD139.LIB
.step param Cload list 100p 1n 10n 100n
