leedanie2/curve-tracer/sim/01_sweep_source_compensation.asc

C1: cap; 1n
Ccomp: cap; {Cc}
Q1: npn
Rbase: res; 100
Rf: res; 23.3k
RG: res; 10k
RL: res; 200
U1: UniversalOpAmp2
V1: voltage; 15
V2: voltage; PULSE(1.5 1.6 1u 100n 100n 100u 200u)
Named nets: 0
.tran 0 200u 0 10n
.step param Cc list 1p 10p 22p 47p 100p
