leedanie2/curve-tracer/hardware/curve-tracer.kicad_pcb

## KiCad design hardware/curve-tracer.kicad_pcb (2026-10-11)

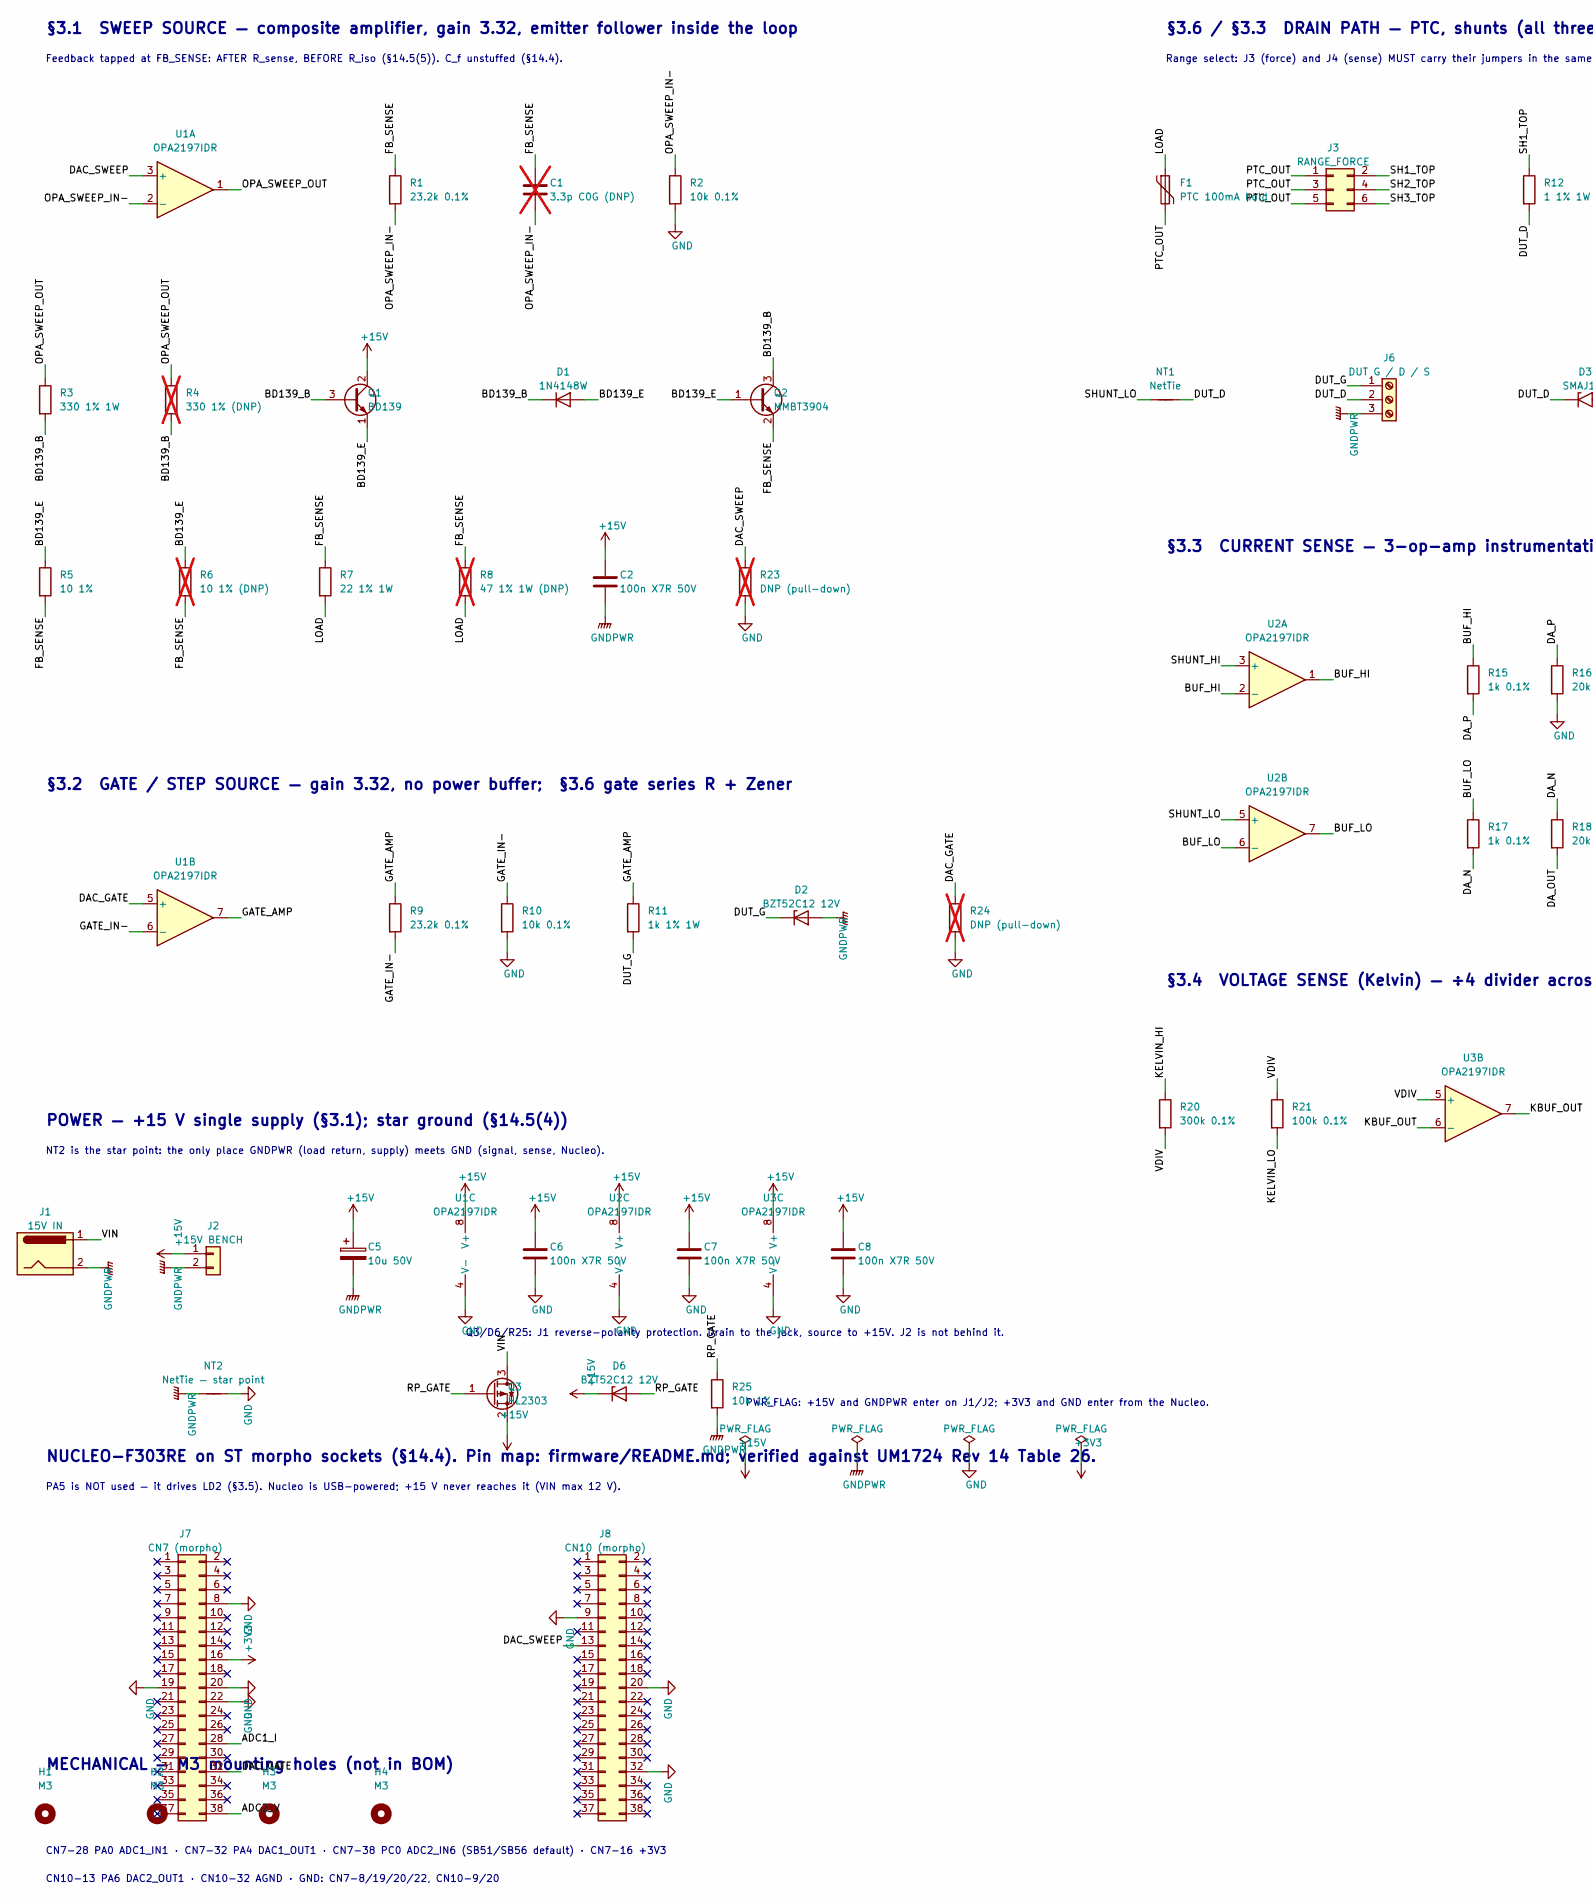
[picture p22: schematic curve-tracer.kicad_sch, Curve tracer — MVP schematic (range 1, DC sweep), part in row 1, column 1]

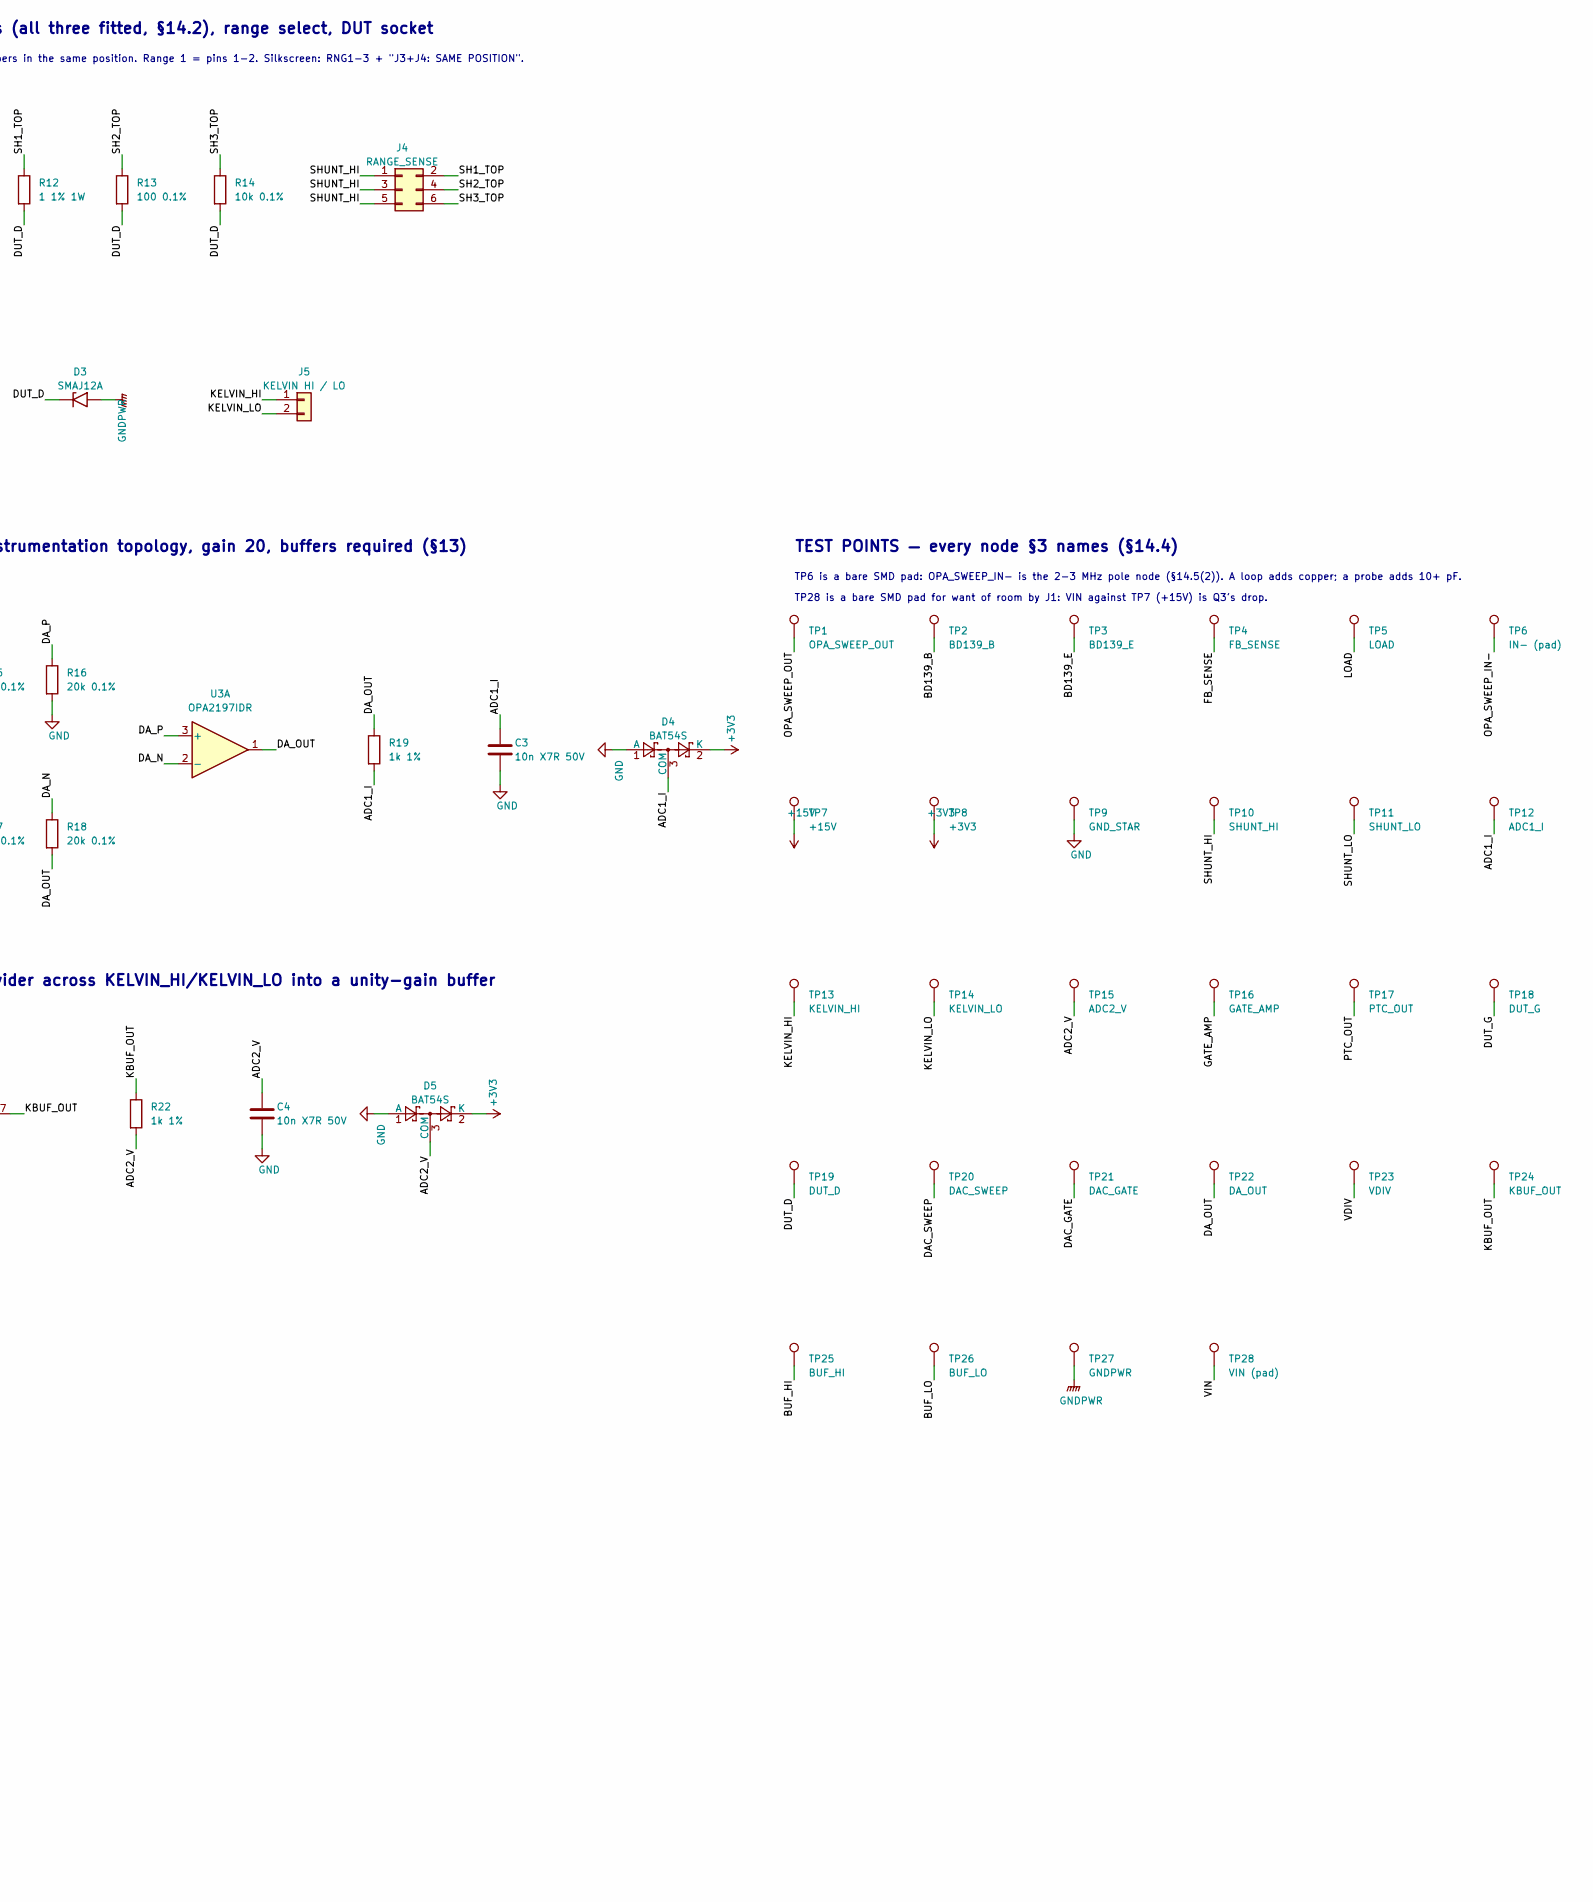
[picture p23: schematic curve-tracer.kicad_sch, Curve tracer — MVP schematic (range 1, DC sweep), part in row 1, column 2]

Parts:
C1: 3.3p C0G (DNP); C_0603_1608Metric; MPN 0603CG3R3B500NT; LCSC C2836771; not fitted
C2, C6, C7, C8: 100n X7R 50V; C_0603_1608Metric; MPN CC0603KRX7R9BB104; LCSC C14663
C3, C4: 10n X7R 50V; C_0603_1608Metric; MPN 0603B103K500NT; LCSC C57112
C5: 10u 50V; CP_Elec_5x5.4; MPN RVT50V10M5X5; LCSC C47023118
D1: 1N4148W; D_SOD-123; MPN 1N4148W; LCSC C81598
D2, D6: BZT52C12 12V; D_SOD-123; MPN BZT52C12; LCSC C173429
D3: SMAJ12A; D_SMA; MPN SMAJ12A; LCSC C113957
D4, D5: BAT54S; SOT-23; MPN BAT54S; LCSC C7420333
F1: PTC 100mA hold; Fuse_1206_3216Metric; MPN nSMD010; LCSC C70065
H1, H2, H3, H4: M3; MountingHole_3.2mm_M3
J1: 15V IN; BarrelJack_Horizontal; MPN DC-005 2.0; LCSC C16214
J2: 15V BENCH; PinHeader_1x02_P2.54mm_Vertical; MPN PZ254V-11-02P; LCSC C492401
J3: RANGE_FORCE; PinHeader_2x03_P2.54mm_Vertical_RangeSelect; MPN PZ254V-12-6P; LCSC C492420
J4: RANGE_SENSE; PinHeader_2x03_P2.54mm_Vertical_RangeSelect; MPN PZ254V-12-6P; LCSC C492420
J5: KELVIN HI / LO; PinHeader_1x02_P2.54mm_Vertical; MPN PZ254V-11-02P; LCSC C492401
J6: DUT G / D / S; TerminalBlock_Phoenix_MKDS-1,5-3_1x03_P5.00mm_Horizontal; MPN KF301-5.0-3P; LCSC C474882
J7: CN7 (morpho); PinSocket_2x19_P2.54mm_Vertical_NucleoCarrier; MPN PM254-2-19-Z-8.5; LCSC C2897420
J8: CN10 (morpho); PinSocket_2x19_P2.54mm_Vertical_NucleoCarrier; MPN PM254-2-19-Z-8.5; LCSC C2897420
NT1: NetTie; NetTie-2_SMD_Pad0.5mm
NT2: NetTie — star point; NetTie-2_SMD_Pad0.5mm
Q1: BD139; TO-126-3_Vertical; MPN BD139; LCSC C27866
Q2: MMBT3904; SOT-23; MPN MMBT3904; LCSC C20526
Q3: HL2303; SOT-23; MPN HL2303; LCSC C7420345
R1, R9: 23.2k 0.1%; R_0603_1608Metric; MPN RT0603BRE0723K2L; LCSC C861768
R2, R10: 10k 0.1%; R_0603_1608Metric; MPN RT0603BRD0710KL; LCSC C95204
R3: 330 1% 1W; R_2512_6332Metric; MPN FRC2512F3300TS; LCSC C2934068
R4: 330 1% (DNP); R_Axial_DIN0309_L9.0mm_D3.2mm_P12.70mm_Horizontal; not fitted
R5: 10 1%; R_1206_3216Metric; MPN CRCW120610R0FKEAHP; LCSC C511457
R6: 10 1% (DNP); R_Axial_DIN0309_L9.0mm_D3.2mm_P12.70mm_Horizontal; not fitted
R7: 22 1% 1W; R_2512_6332Metric; MPN RC2512FK-0722RL; LCSC C276336
R8: 47 1% 1W (DNP); R_Axial_DIN0309_L9.0mm_D3.2mm_P12.70mm_Horizontal; MPN RN1WS47ΩFT/BA1; LCSC C385394; not fitted
R11: 1k 1% 1W; R_2512_6332Metric; MPN FRC2512F1001TS; LCSC C2960683
R12: 1 1% 1W; R_2512_6332Metric; MPN RC2512FK-071RL; LCSC C181756
R13: 100 0.1%; R_0805_2012Metric; MPN RT0805BRD07100RL; LCSC C110773
R14: 10k 0.1%; R_0805_2012Metric; MPN RT0805BRD0710KL; LCSC C110775
R15, R17: 1k 0.1%; R_0805_2012Metric; MPN RT0805BRD071KL; LCSC C110774
R16, R18: 20k 0.1%; R_0805_2012Metric; MPN RT0805BRD0720KL; LCSC C469660
R19, R22: 1k 1%; R_0603_1608Metric; MPN 0603WAF1001T5E; LCSC C21190
R20: 300k 0.1%; R_0603_1608Metric; MPN RT0603BRD07300KL; LCSC C705762
R21: 100k 0.1%; R_0603_1608Metric; MPN RT0603BRD07100KL; LCSC C122538
R23, R24: DNP (pull-down); R_0603_1608Metric; not fitted
R25: 10k 1%; R_0603_1608Metric; MPN 0603WAF1002T5E; LCSC C25804
TP1: OPA_SWEEP_OUT; TestPoint_Keystone_5000-5004_Miniature; MPN RH-5001; LCSC C5199801
TP2: BD139_B; TestPoint_Keystone_5000-5004_Miniature; MPN RH-5001; LCSC C5199801
TP3: BD139_E; TestPoint_Keystone_5000-5004_Miniature; MPN RH-5001; LCSC C5199801
TP4: FB_SENSE; TestPoint_Keystone_5000-5004_Miniature; MPN RH-5001; LCSC C5199801
TP5: LOAD; TestPoint_Keystone_5000-5004_Miniature; MPN RH-5001; LCSC C5199801
TP6: IN- (pad); TestPoint_Pad_D1.0mm
TP7: +15V; TestPoint_Keystone_5000-5004_Miniature; MPN RH-5001; LCSC C5199801
TP8: +3V3; TestPoint_Keystone_5000-5004_Miniature; MPN RH-5001; LCSC C5199801
TP9: GND_STAR; TestPoint_Keystone_5000-5004_Miniature; MPN RH-5001; LCSC C5199801
TP10: SHUNT_HI; TestPoint_Keystone_5000-5004_Miniature; MPN RH-5001; LCSC C5199801
TP11: SHUNT_LO; TestPoint_Keystone_5000-5004_Miniature; MPN RH-5001; LCSC C5199801
TP12: ADC1_I; TestPoint_Keystone_5000-5004_Miniature; MPN RH-5001; LCSC C5199801
TP13: KELVIN_HI; TestPoint_Keystone_5000-5004_Miniature; MPN RH-5001; LCSC C5199801
TP14: KELVIN_LO; TestPoint_Keystone_5000-5004_Miniature; MPN RH-5001; LCSC C5199801
TP15: ADC2_V; TestPoint_Keystone_5000-5004_Miniature; MPN RH-5001; LCSC C5199801
TP16: GATE_AMP; TestPoint_Keystone_5000-5004_Miniature; MPN RH-5001; LCSC C5199801
TP17: PTC_OUT; TestPoint_Keystone_5000-5004_Miniature; MPN RH-5001; LCSC C5199801
TP18: DUT_G; TestPoint_Keystone_5000-5004_Miniature; MPN RH-5001; LCSC C5199801
TP19: DUT_D; TestPoint_Keystone_5000-5004_Miniature; MPN RH-5001; LCSC C5199801
TP20: DAC_SWEEP; TestPoint_Keystone_5000-5004_Miniature; MPN RH-5001; LCSC C5199801
TP21: DAC_GATE; TestPoint_Keystone_5000-5004_Miniature; MPN RH-5001; LCSC C5199801
TP22: DA_OUT; TestPoint_Keystone_5000-5004_Miniature; MPN RH-5001; LCSC C5199801
TP23: VDIV; TestPoint_Keystone_5000-5004_Miniature; MPN RH-5001; LCSC C5199801
TP24: KBUF_OUT; TestPoint_Keystone_5000-5004_Miniature; MPN RH-5001; LCSC C5199801
TP25: BUF_HI; TestPoint_Keystone_5000-5004_Miniature; MPN RH-5001; LCSC C5199801
TP26: BUF_LO; TestPoint_Keystone_5000-5004_Miniature; MPN RH-5001; LCSC C5199801
TP27: GNDPWR; TestPoint_Keystone_5000-5004_Miniature; MPN RH-5001; LCSC C5199801
TP28: VIN (pad); TestPoint_Pad_D1.0mm
U1, U2, U3: OPA2197IDR; SOIC-8_3.9x4.9mm_P1.27mm; MPN OPA2197IDR; LCSC C139363

Connections:
+3V3: D4.2 (K), D5.2 (K), J7.16, TP8.1
+15V: C2.1, C5.1, C6.1, C7.1, C8.1, D6.1 (K), J2.1, Q1.2 (C), Q3.2 (S), TP7.1, U1.8 (V+), U2.8 (V+), U3.8 (V+)
/ADC1_I: C3.1, D4.3 (COM), J7.28, R19.2, TP12.1
/ADC2_V: C4.1, D5.3 (COM), J7.38, R22.2, TP15.1
/BD139_B: D1.1 (K), Q1.3 (B), Q2.3 (C), R3.2, R4.2, TP2.1
/BD139_E: D1.2 (A), Q1.1 (E), Q2.1 (B), R5.1, R6.1, TP3.1
/BUF_HI: R15.1, TP25.1, U2.1, U2.2 (-)
/BUF_LO: R17.1, TP26.1, U2.6 (-), U2.7
/DAC_GATE: J7.32, R24.1, TP21.1, U1.5 (+)
/DAC_SWEEP: J8.13, R23.1, TP20.1, U1.3 (+)
/DA_N: R17.2, R18.1, U3.2 (-)
/DA_OUT: R18.2, R19.1, TP22.1, U3.1
/DA_P: R15.2, R16.1, U3.3 (+)
/DUT_D: D3.1 (A1), J6.2, NT1.2, R12.2, R13.2, R14.2, TP19.1
/DUT_G: D2.1 (K), J6.1, R11.2, TP18.1
/FB_SENSE: C1.1, Q2.2 (E), R1.1, R5.2, R6.2, R7.1, R8.1, TP4.1
/GATE_AMP: R9.1, R11.1, TP16.1, U1.7
/GATE_IN-: R9.2, R10.1, U1.6 (-)
/KBUF_OUT: R22.1, TP24.1, U3.6 (-), U3.7
/KELVIN_HI: J5.1, R20.1, TP13.1
/KELVIN_LO: J5.2, R21.2, TP14.1
/LOAD: F1.1, R7.2, R8.2, TP5.1
/OPA_SWEEP_IN-: C1.2, R1.2, R2.1, TP6.1, U1.2 (-)
/OPA_SWEEP_OUT: R3.1, R4.1, TP1.1, U1.1
/PTC_OUT: F1.2, J3.1, J3.3, J3.5, TP17.1
/RP_GATE: D6.2 (A), Q3.1 (G), R25.1
/SH1_TOP: J3.2, J4.2, R12.1
/SH2_TOP: J3.4, J4.4, R13.1
/SH3_TOP: J3.6, J4.6, R14.1
/SHUNT_HI: J4.1, J4.3, J4.5, TP10.1, U2.3 (+)
/SHUNT_LO: NT1.1, TP11.1, U2.5 (+)
/VDIV: R20.2, R21.1, TP23.1, U3.5 (+)
/VIN: J1.1, Q3.3 (D), TP28.1
GND: C3.2, C4.2, C6.2, C7.2, C8.2, D4.1 (A), D5.1 (A), J7.8, J7.19, J7.20, J7.22, J8.9, J8.20, J8.32, NT2.2, R2.2, R10.2, R16.2, R23.2, R24.2, TP9.1, U1.4 (V-), U2.4 (V-), U3.4 (V-)
GNDPWR: C2.2, C5.2, D2.2 (A), D3.2 (A2), J1.2, J2.2, J6.3, NT2.1, R25.2, TP27.1

Notes on the sheet:
Feedback tapped at FB_SENSE: AFTER R_sense, BEFORE R_iso (§14.5(5)). C_f unstuffed (§14.4).
CN7-28 PA0 ADC1_IN1 · CN7-32 PA4 DAC1_OUT1 · CN7-38 PC0 ADC2_IN6 (SB51/SB56 default) · CN7-16 +3V3
PA5 is NOT used — it drives LD2 (§3.5). Nucleo is USB-powered; +15 V never reaches it (VIN max 12 V).
Range select: J3 (force) and J4 (sense) MUST carry their jumpers in the same position. Range 1 = pins 1-2. Silkscreen: RNG1-3 + "J3+J4: SAME POSITION".
§3.1 SWEEP SOURCE — composite amplifier, gain 3.32, emitter follower inside the loop
NUCLEO-F303RE on ST morpho sockets (§14.4). Pin map: firmware/README.md; verified against UM1724 Rev 14 Table 26.
MECHANICAL — M3 mounting holes (not in BOM)
TP28 is a bare SMD pad for want of room by J1: VIN against TP7 (+15V) is Q3's drop.
POWER — +15 V single supply (§3.1); star ground (§14.5(4))
§3.6 / §3.3 DRAIN PATH — PTC, shunts (all three fitted, §14.2), range select, DUT socket
CN10-13 PA6 DAC2_OUT1 · CN10-32 AGND · GND: CN7-8/19/20/22, CN10-9/20
TP6 is a bare SMD pad: OPA_SWEEP_IN- is the 2-3 MHz pole node (§14.5(2)). A loop adds copper; a probe adds 10+ pF.
TEST POINTS — every node §3 names (§14.4)
PWR_FLAG: +15V and GNDPWR enter on J1/J2; +3V3 and GND enter from the Nucleo.
§3.4 VOLTAGE SENSE (Kelvin) — ÷4 divider across KELVIN_HI/KELVIN_LO into a unity-gain buffer
Q3/D6/R25: J1 reverse-polarity protection. Drain to the jack, source to +15V. J2 is not behind it.
§3.2 GATE / STEP SOURCE — gain 3.32, no power buffer; §3.6 gate series R + Zener
NT2 is the star point: the only place GNDPWR (load return, supply) meets GND (signal, sense, Nucleo).
§3.3 CURRENT SENSE — 3-op-amp instrumentation topology, gain 20, buffers required (§13)

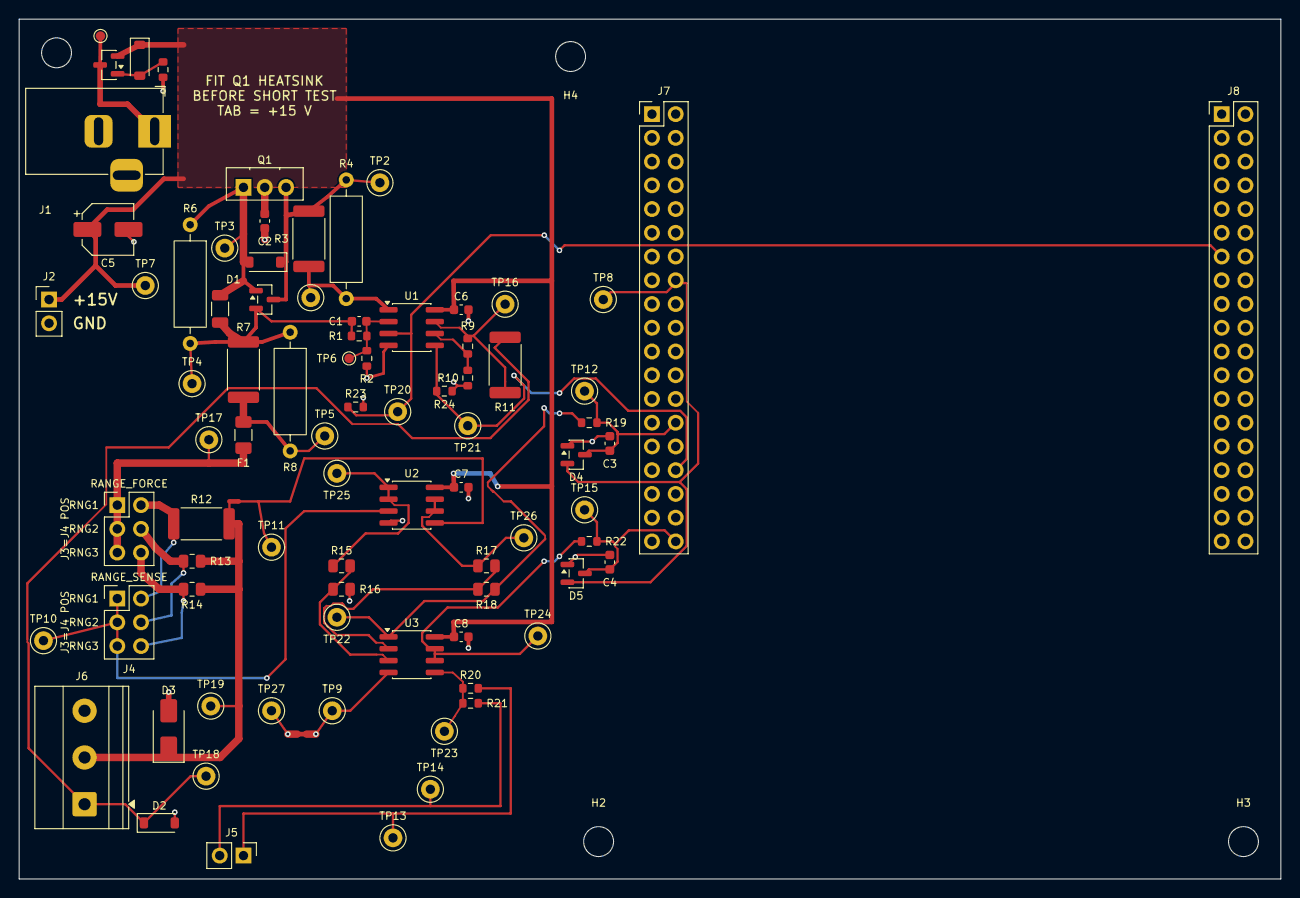
[picture p24: board curve-tracer.kicad_pcb from above]

Board: 2 copper layers, 135.0 x 92.0 mm, 88 parts (0 on the bottom side), 35 nets.
