leedanie2/curve-tracer/firmware/stm32/curve-tracer.ioc

Mcu.UserName=STM32F303RETx
PA0.Signal=ADC1_IN1
PA13.Signal=SYS_JTMS-SWDIO
PA14.Signal=SYS_JTCK-SWCLK
PA2.Signal=USART2_TX
PA3.Signal=USART2_RX
PA4.Signal=DAC1_OUT1
PA5.Signal=DAC1_OUT2
PA6.Signal=GPIO_Analog
PC0.Signal=ADC2_IN6
