leedanie2/curve-tracer/host/ct_host/plot.py

"""Plotting the I-V family, live as it arrives and as a finished figure.

**The x-axis is ``vds_meas_v``, never ``vds_set_v``.** The whole reason the
instrument carries a four-wire sense is that the commanded voltage is wrong by
over a volt at full current (blueprint §3.1, §3.4). Plotting the commanded
value would draw a curve the device never saw. ``vds_set_v`` appears here only
in the diagnostic overlay, where the *difference* between the two is the
quantity of interest.

Live plotting is driven by the ``on_row`` callback of
:func:`ct_host.protocol.run_sweep`, so points appear at the rate the
instrument produces them. It works against the simulator too, which streams
line by line for exactly this reason.
"""

from __future__ import annotations

import time
from collections import OrderedDict
from dataclasses import dataclass, field
from pathlib import Path
from typing import Any, Iterable

from .csvio import Row, Sweep
from .dataset import VDS_SET_MAX_V, family_of, vds_delta_report

__all__ = ["LivePlot", "plot_family", "plot_vds_delta"]


def is_two_terminal(vgs_values: Iterable[float]) -> bool:
    """One gate step, at 0 V: a diode, LED or resistor capture.

    V_GS means nothing there, so its plots carry no V_GS legend or label and
    are titled with the device name alone.
    """
    steps = set(vgs_values)
    return len(steps) == 1 and abs(next(iter(steps))) < 5e-4


@dataclass
class LivePlot:
    """Accumulates rows and redraws the family as they arrive.

    Redraws are rate-limited: a 1600-point sweep completes in about a second
    and a half on the wire, and redrawing per row would make the plot, not the
    instrument, the bottleneck.
    """

    title: str = "I-V family"
    redraw_interval_s: float = 0.2
    i_limit_ma: float | None = None
    show: bool = True

    _series: "OrderedDict[float, tuple[list[float], list[float]]]" = field(
        default_factory=OrderedDict, init=False, repr=False)
    _flagged: tuple[list[float], list[float]] = field(
        default_factory=lambda: ([], []), init=False, repr=False)
    _lines: dict[float, Any] = field(default_factory=dict, init=False,
                                     repr=False)
    _last_draw: float = field(default=0.0, init=False, repr=False)
    _fig: Any = field(default=None, init=False, repr=False)
    _ax: Any = field(default=None, init=False, repr=False)
    _flag_artist: Any = field(default=None, init=False, repr=False)
    _device: str | None = field(default=None, init=False, repr=False)
    _two_terminal: bool = field(default=False, init=False, repr=False)
    n_rows: int = field(default=0, init=False)

    # -- lifecycle ---------------------------------------------------------

    def open(self) -> LivePlot:
        import matplotlib.pyplot as plt

        if self.show:
            plt.ion()
        self._fig, self._ax = plt.subplots(figsize=(7.5, 5.0))
        self._ax.set_xlabel("V_DS measured at the DUT  (V)")
        self._ax.set_ylabel("I_D  (mA)")
        self._ax.set_title(self.title)
        self._ax.grid(True, alpha=0.3)
        if self.i_limit_ma is not None:
            self._ax.axhline(self.i_limit_ma, linestyle="--", linewidth=1.0,
                             color="0.5")
            self._ax.text(0.01, self.i_limit_ma, " firmware i_limit",
                          va="bottom", ha="left", fontsize=8, color="0.4",
                          transform=self._ax.get_yaxis_transform())
        if self.show:
            self._fig.canvas.draw_idle()
            plt.show(block=False)
        return self

    def __enter__(self) -> LivePlot:
        return self.open()

    def __exit__(self, *exc: object) -> None:
        self.close()

    def close(self) -> None:
        if self._fig is not None and self.show:
            import matplotlib.pyplot as plt
            plt.ioff()

    # -- callbacks ---------------------------------------------------------

    def on_meta(self, key: str, value: str) -> None:
        if key == "device":
            self._device = value
        elif key == "vgs_list":
            try:
                self._two_terminal = is_two_terminal(
                    float(v) for v in value.split(",") if v.strip())
            except ValueError:
                pass
        if key in ("device", "vgs_list") and self._ax is not None and self._device:
            self._ax.set_title(self._device if self._two_terminal
                               else f"{self.title} — {self._device}")
        if key == "i_limit_ma" and self.i_limit_ma is None:
            try:
                self.i_limit_ma = float(value)
            except ValueError:
                pass

    def on_row(self, row: Row) -> None:
        """Feed one row. Safe to pass straight to ``run_sweep(on_row=...)``."""
        self.n_rows += 1
        if self._ax is None:
            self.open()

        if not row.valid:
            self._flagged[0].append(row.v_dut)
            self._flagged[1].append(row.i_ma)
        else:
            xs, ys = self._series.setdefault(row.vgs_set_v, ([], []))
            xs.append(row.v_dut)
            ys.append(row.i_ma)

        now = time.monotonic()
        if now - self._last_draw >= self.redraw_interval_s:
            self._last_draw = now
            self.refresh()

    def refresh(self) -> None:
        if self._ax is None:
            return
        for vgs, (xs, ys) in self._series.items():
            line = self._lines.get(vgs)
            if line is None:
                (line,) = self._ax.plot(
                    xs, ys, marker="", linewidth=1.4,
                    label=None if self._two_terminal else f"V_GS = {vgs:.3f} V")
                self._lines[vgs] = line
                if not self._two_terminal:
                    self._ax.legend(fontsize=8, loc="upper left")
            else:
                line.set_data(xs, ys)

        if self._flagged[0]:
            if self._flag_artist is None:
                (self._flag_artist,) = self._ax.plot(
                    *self._flagged, linestyle="none", marker="x",
                    markersize=9, color="crimson", label="flagged (excluded)")
                self._ax.legend(fontsize=8, loc="upper left")
            else:
                self._flag_artist.set_data(*self._flagged)

        self._ax.relim()
        self._ax.autoscale_view()
        if self.show:
            self._fig.canvas.draw_idle()
            self._fig.canvas.flush_events()

    def finish(self, sweep: Sweep | None = None) -> None:
        self.refresh()
        if sweep is not None and self._ax is not None:
            if sweep.end_reason and sweep.end_reason != "ok":
                self._ax.set_title(
                    f"{self._ax.get_title()}   [ended: {sweep.end_reason}]")

    def save(self, path: str | Path, dpi: int = 150) -> Path:
        self.refresh()
        path = Path(path)
        self._fig.savefig(path, dpi=dpi, bbox_inches="tight")
        return path

    # -- introspection, for tests ------------------------------------------

    @property
    def figure(self) -> Any:
        return self._fig

    @property
    def axes(self) -> Any:
        return self._ax

    @property
    def series(self) -> "OrderedDict[float, tuple[list[float], list[float]]]":
        return self._series

    @property
    def flagged(self) -> tuple[list[float], list[float]]:
        return self._flagged


def plot_family(sweep: Sweep, *, ax: Any = None, show_flagged: bool = True,
                title: str | None = None) -> Any:
    """Draw a finished sweep. Returns the axes."""
    import matplotlib.pyplot as plt

    if ax is None:
        _, ax = plt.subplots(figsize=(7.5, 5.0))

    family = family_of(sweep)
    two_terminal = is_two_terminal(c.vgs for c in family)
    # V_GS is an ordered magnitude: one hue, light to dark, so no two steps
    # share a colour (the default cycle repeats after ten). Curves that rise
    # clear of zero are labelled at their end as well as in the legend.
    ramp = plt.get_cmap("Blues")
    span = max((float(c.i_ma.max()) for c in family if len(c.i_ma)), default=0.0)
    for k, curve in enumerate(family):
        color = (ramp(0.35 + 0.6 * k / (len(family) - 1)) if len(family) > 1
                 else None)
        ax.plot(curve.v, curve.i_ma, linewidth=1.4, color=color,
                label=None if two_terminal else f"V_GS = {curve.vgs:.3f} V")
        if len(family) > 1 and len(curve.v) and curve.i_ma.max() > 0.04 * span:
            ax.annotate(f"{curve.vgs:.2f} V", (curve.v[-1], curve.i_ma[-1]),
                        xytext=(4, 0), textcoords="offset points",
                        va="center", fontsize=7, color="0.25")

    floor = [r for r in sweep.flagged_rows if r.flags == "floor"]
    flagged = [r for r in sweep.flagged_rows if r.flags != "floor"]
    if show_flagged and floor:
        # A reading on the floor bounds the device's current from above; it
        # isn't a measurement of it. Drawn as such, apart from the curve.
        ax.plot([r.v_dut for r in floor], [r.i_ma for r in floor],
                linestyle="none", marker=".", markersize=3, color="0.6",
                label="on the channel's floor (excluded from fits)")
    if show_flagged and flagged:
        ax.plot([r.v_dut for r in flagged], [r.i_ma for r in flagged],
                linestyle="none", marker="x", markersize=9, color="crimson",
                label="flagged (excluded from fits)")

    label = title or sweep.meta.device
    if sweep.meta.is_simulated:
        label += "   [SIMULATED]"
    notes = [c.label for c in (sweep.r_parallel, sweep.zero) if c is not None]
    if notes:
        # Below the axes, where it cannot sit on a curve near zero.
        ax.text(1.0, -0.13, "\n".join(_wrap(n, 100) for n in notes),
                transform=ax.transAxes, ha="right", va="top", fontsize=7,
                color="0.3")
    ax.set_xlabel("V_DS measured at the DUT  (V)")
    taken = [w for w, c in (("R_p current", sweep.r_parallel), ("zero", sweep.zero))
             if c is not None]
    ax.set_ylabel(f"I_D, {' and '.join(taken)} subtracted  (mA)" if taken
                  else "I_D  (mA)")
    ax.set_title(label)
    ax.grid(True, alpha=0.3)
    if two_terminal:
        # No V_GS entry; a legend only if flagged points need one.
        if show_flagged and sweep.flagged_rows:
            ax.legend(fontsize=8, loc="upper left")
    elif len(family) > 8:
        # A long family's legend would cover the top curves: put it outside,
        # and leave room on the right for the end labels.
        ax.legend(fontsize=7, loc="upper left", bbox_to_anchor=(1.01, 1.0))
        lo, hi = ax.get_xlim()
        ax.set_xlim(lo, hi + 0.08 * (hi - lo))
    else:
        ax.legend(fontsize=8, loc="upper left")
    return ax


def _wrap(text: str, width: int = 70) -> str:
    import textwrap
    return "\n".join(textwrap.wrap(text, width))


def plot_vds_delta(sweep: Sweep, *, ax: Any = None,
                   r_iso_ohm: float | None = None,
                   r_ptc_ohm: float | None = None,
                   vds_set_max_v: float | None = VDS_SET_MAX_V) -> Any:
    """The commanded-minus-measured diagnostic against the expected line.

    This is the one plot where ``vds_set_v`` appears, and only as part of the
    difference. A healthy instrument puts every point on the
    I x (R_iso + shunt + R_PTC) line; with R_PTC unmeasured the line drawn is
    R_iso + shunt only, a lower bound. Rows above ``vds_set_max_v`` are drawn
    grey and left out of the fit. See ``vds_delta_report``.
    """
    import matplotlib.pyplot as plt
    import numpy as np

    if ax is None:
        _, ax = plt.subplots(figsize=(7.0, 4.5))

    rows = [r for r in sweep.valid_rows if r.i_total_ma > 0.5]
    i_ma = np.array([r.i_total_ma for r in rows])
    delta = np.array([r.vds_set_v - r.v_dut for r in rows])
    above = np.array([vds_set_max_v is not None and r.vds_set_v > vds_set_max_v
                      for r in rows], dtype=bool)

    report = vds_delta_report(sweep, r_iso_ohm=r_iso_ohm, r_ptc_ohm=r_ptc_ohm,
                              vds_set_max_v=vds_set_max_v)
    ax.plot(i_ma[~above], delta[~above], linestyle="none", marker=".",
            markersize=4, label="measured delta")
    if above.any():
        ax.plot(i_ma[above], delta[above], linestyle="none", marker=".",
                markersize=4, color="0.7",
                label=f"vds_set_v > {vds_set_max_v:g} V, not fitted")
    if i_ma.size:
        grid = np.linspace(0.0, float(i_ma.max()), 50)
        ax.plot(grid, grid / 1000.0 * report.expected_r_ohm, linewidth=1.2,
                color="0.4", linestyle="--",
                label=f"expected: I x {report.expected_r_ohm:.0f} Ω")

    ax.set_xlabel("I_D  (mA)")
    ax.set_ylabel("vds_set_v − vds_meas_v  (V)")
    ax.set_title(f"Series-drop diagnostic — {report.verdict}")
    ax.grid(True, alpha=0.3)
    ax.legend(fontsize=8, loc="upper left")
    return ax
