leedanie2/curve-tracer/(commit log)

2026-09-04 Phase 0 complete: sweep source stability
    Ccomp across Rf destabilizes non-inverting topology; removed.
    BD139 model (fT 54MHz) reveals instability that 2N2222 hid.
    Bare load limit 1-2.2nF; 22R isolation resistor extends past 100nF
    with feedback tapped emitter-side.
2026-09-18 Week 2: difference amp CMRR and input-loading sims
    Split the repeatedly-overwritten 04_diffamp_cmrr netlist into one file per
    experiment. The .cir under the 04 name had been clobbered with the loading
    circuit, and its .log/.raw/.db were that loading run's output wearing the
    CMRR name.
    - 04_diffamp_cmrr.cir: worst-case tolerance corner, CMRR 134.40 / 74.42 /
    54.57 dB at tol 1e-6 / 0.1% / 1%. The 1e-6 row is a solver-floor control.
    - 05_diffamp_mc.cir: 500-run Monte Carlo at 0.1%. n=500, min 76.20, p5 79.43,
    median 88.26, p95 110.51, max 144.73 dB. Report as a distribution over the
    74.4 dB floor, not a single number.
    - 06_diffamp_loading.cir: V(out)=9.512 mV at Rsh=1 ohm, i.e. 475.6 uA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
2026-09-18 Blueprint: record Phase 0 difference-amp decisions
    Sweep source (§3.1):
    - Base resistor 100 Ω -> 330–470 Ω (390 Ω pending sim 08). At 100 Ω a tripped
    limiter demands ~110 mA from the op-amp, past the OPA2197's own ~65 mA
    short-circuit limit, so the test would measure the op-amp's protection
    rather than the circuit's. Tradeoff noted: R_B·C_jc moves the pole from
    ~44 MHz to ~10 MHz against a ~3 MHz crossover.
    - Pass transistor: tab = collector at +15 V; worst case 0.75 W -> 0.85 W.
    - "Foldback" -> "constant-current limit"; the circuit has no output-to-base
    divider, so the name was wrong. Feedback taps after the 10 Ω sense resistor.
    - Output headroom: 11 V at the feedback nod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
2026-09-18 Sims 08/09: base resistor sizing and B-E clamp diode
    sim/08 steps Rb (220, 330) over four load cases (100 nF / 100 pF, 200 ohm /
    open) with a full-scale 1 V -> 9 V emitter step and a 20 ms window so the
    passive falling edge completes. sim/09 is the same with a 1N4148 across the
    BD139 base-emitter junction (anode at emitter).
    Without the clamp the BD139 turns off on falling edges and the junction is
    reverse-biased to -6.3 V (100 pF, open: current range 3) and -9.0 V (100 nF,
    open), over its 5 V V_EBO. The clamp holds it to -0.74 V and adds an active
    pull-down through R_B; op-amp sink peaks at 21.9 mA at 330 ohm.
    host/parse_tran_overshoot.py reads the stepped .raw directly and reports rise
    o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
2026-09-18 Rename sim 08, document 08/09, add 1N4148 to BOM
    - git mv 08_sweep_source_rb390.asc -> 08_sweep_source_rb_sweep.asc; it steps
    Rb, not a fixed 390 ohm. Parser usage line updated.
    - sim/README.md: 08 and 09 entries (Rb overshoot table, 08-vs-09 falling
    edge), and the intro now says .asc is used where topology matters and .cir
    for resistor networks, instead of claiming .cir is the only tracked file.
    - Blueprint 8: 1N4148 x10 (B-E clamp, extras as diode DUTs), dropped from
    the DUT line to avoid double counting; total ~$98 (the items already summed
    to $97). Blueprint 12: pointer to the falling-edge results in 3.1.
2026-09-18 Sim 08: fold the small-signal Rb sweep back into the committed file
    The 0.3/5.3/10.3/12.7% overshoot figures cited in blueprint 3.1 came from
    a small-signal configuration of 08 that was never committed. 08 now steps
    tcase (1 = 100 mV step 1.5 -> 1.6 V, 2 = full-scale 0.3 -> 2.7 V) with the
    pulse levels set by table(), and Rb over 100/220/330/390 again, so one
    file produces both. Both cases share .tran 0 20m 0 10n; LTspice fixes the
    stop time per run, not per step.
    Re-run reproduces all four small-signal numbers exactly, and the full-scale
    220/330 rows are unchanged. sim/README.md and the blueprint cite the
    committed file with no caveat; the parser labels rows by tcase.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
2026-09-19 Add docs/characterization.md with first bench entry
    Test matrix mirrors blueprint 7 with a status column (all not started).
    First bench log entry, 2026-09-18: stage 3 gain network on an LM324 with
    5% resistors, a substitute-parts shakedown that does not count toward 7.
    Records a 1.3% gain discrepancy as unresolved and the circuit as not
    working at end of session.
2026-09-19 characterization.md: define breadboard build stages, sharpen next steps
    Adds the eight breadboard build stages the bench log refers to, as a
    sub-breakdown of blueprint Phase 1; the feedback tap moves twice (op-amp
    output, emitter, past R_sense) so each loop addition is tested alone.
    Next-session item 3 now re-measures R_f and R_G on the same meter and range
    alongside the gain points, which separates meter scale error from wiring.
2026-09-19 Blueprint 8: Phase 1 parts, OPA2197 package and bench substitute path
    Adds the Phase 1 parts the BOM was missing (10 ohm R_sense, 330 ohm R_B,
    200 ohm 1 W load, decoupling, trimpots, SOIC-8 to DIP adapters); total
    ~$98 -> ~$116. Notes that the OPA2197 is SOIC-8/VSSOP only, and records
    the LM324 substitute path (TL074 rejected: input range excludes ground):
    acceptable through Phase 6, OPA2197 required before Phase 7. Lists what an
    LM324 result does not carry over: loop stability, the stage 8 short test,
    and the Phase 2-3 accuracy gates.
2026-09-19 Blueprint: LM324 datasheet figures, clamp-discharge caveat, R_iso guidance
    8: substitute-path bullets now use ST LM324 datasheet figures (1.3 MHz
    GBW, 20 nA bias, source 20 mA min / 40 mA typ). New stage 7 bullet: the
    LM324 cannot sink sim 09's 21.9 mA clamp discharge (10 mA min / 20 mA typ)
    and has a weak-sink region below ~0.5 V; at 100 pF its slew rate limits
    the fall instead. Stage 7 clamp results need the OPA2197.
    3.1: note that the LM324 datasheet independently recommends resistive
    isolation for capacitive loads, the general form of Phase 0's R_iso.
2026-09-19 Blueprint 8: LM324 slew caveat, sourced weak-sink mechanism
    Promotes slew rate to a general caveat above the substitute bullets: at
    0.4 V/us typ the LM324 is ~25x slower than sim 08's edges, so only DC
    measurements transfer. Stage 7 bullet drops the unsourced "internal
    100 uA source current" explanation in favour of TI's applications
    guidance (~30 uA sink at 0.2 V, output held near 0.7 V) and the
    datasheet's output-to-ground bias resistor recommendation; the clamp
    path's emitter floor moves to ~1.3 V accordingly.
2026-09-19 Sim 10: current limiter; correct the R_B rationale
    sim/10_current_limit.asc is 09 plus R_sense (10 ohm) and Q2 (2N3904), with
    feedback tapped after R_sense. A time-varying load ramps open -> short,
    holds the short, then removes it. Rb (100, 330), the op-amp model's Ilimit
    (25 mA default, 65 mA OPA2197 typ) and Cload (100 pF, 100 nF) are stepped;
    Ilimit must be, or both Rb cases deliver the same 25 mA of drive.
    Findings: Q2's threshold is log-insensitive to drive (R_sense current
    75.2 vs 77.8 mA for 32 vs 65 mA drive) but sits at ~75 mA, not ~65 mA
    (confirmed with the fitted SST3904 model). Q2's emitter returns after
    R_sense, so the diverted drive reaches the load: held-short load current
    is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
2026-09-23 Sim 11: limiter sizing sweep; short-recovery overshoot
    Add sim/11_limit_sizing.asc sweeping R_B / R_sense pairs, and record the
    two consequences in the blueprint §3.6:
    - Short-recovery overshoot peaks at +48% (14.8 V on a 10 V setpoint) for
    every pair tried, so resizing the limiter does not mitigate it.
    - The 107 mA sustained-short load current sits just above the PTC's
    100 mA hold rating. Unplanned interaction, but safe either way.
2026-09-23 Correct BOM, gain and step size against the received order
    Reconcile the blueprint with the parts that actually shipped
    (DigiKey PO 101667133, ordered Sep 16).
    §8 BOM — the pass transistor is a BD139-16 in SOT-32, which is the
    JEDEC TO-126 outline, not TO-220. TO-220 clip-on heatsinks and hardware
    do not fit. Add a package note covering the equivalence and the fact
    that the tab is the collector, live at +15 V. Qty 2 -> 3, $4 -> $6,
    total ~$116 -> ~$118. Drop 23.3 k from the resistor assortment.
    §3.1 — gain 3.33 -> 3.00. 23.3 kohm is not a stock value and was not
    ordered; 20 kohm 0.1% was. Bench-measured 19.89 k / 9.94 k, predicted
    gain 3.001; both readings ~0.6% low is meter scale er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
2026-09-23 Revert gain to 3.32 on R_f = 23.2k; drop TIP31C
    The gain-3.00 change in f4ba94d was wrong and is reverted. Gain 3.33 was
    compensating the R_iso drop and shunt burden by design, not buying
    headroom the output stage could not deliver, so lowering it was a real
    spec reduction (9.85 V -> 8.75 V at 50 mA) with nothing bought back.
    23.3 kohm was never orderable: it is in neither E24 nor E96. The E96
    neighbour is 23.2 kohm, stocked in the same Yageo MFP-25BRD52 0.1%
    family as the parts on hand.
    - §3.1: R_f = 23.2 k, R_g = 10 k, gain 3.32. R_f + R_g = 33.2 kohm
    against the 33.3 kohm simulated, 0.3%, so no sim result is restated
    and the scaling note added for the 20 k case is removed.
    - §1: 0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
2026-09-23 Limiter: abandon the 65 mA target, keep R_B 330 / R_sense 10
    The <=65 mA load-current target is not achievable in this topology and is
    abandoned. Every "~65 mA" figure in earlier drafts was a target, never a
    measurement; measured figures from sims 10 and 11 replace it throughout
    §3.1, §8, §9 and §12.
    Re-ran sim 08 with Rb extended to 470 and 680 ohm (48 steps, ~20 min,
    1.8 GB raw) to test whether a larger R_B could cut the short-circuit load
    current. It cannot be afforded:
    Rb OS% zeta ~PM Rb*Cjc pole 1% settle
    330 10.34 0.59 59deg 13.4 MHz 0.50 us
    470 15.57 0.51 51deg 9.4 MHz 0.62 us
    680 21.35 0.44 44deg 6.5 MHz 0.94 us
    N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
2026-09-23 §3.1: R_B does not set BD139 dissipation; quantify the stability gate
    Two additions to the limiter section.
    1. Worst-case BD139 dissipation is set by R_sense alone. Across sim 11's
    nine rows it groups strictly by R_sense — 891-895 mW at 10 ohm,
    759-762 at 12, 621-624 at 15 — with <=0.5% spread across R_B inside
    each group, and it rises slightly with R_B rather than falling
    (891 -> 895 mW going 330 -> 680 at R_sense = 10). The effects cancel:
    I_C falls 2.8% while V_CE rises 3.3%, because less current through
    R_iso lets the emitter sit lower.
    So R_B never bought any reduction in pass-transistor dissipation. What
    680 ohm bought was load current below the PTC's 100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
2026-09-23 §3.1: re-justify the 25% bench gate as C_f mismatch margin
    The previous justification was self-contradictory: it attributed the looser
    bench gate to the breadboard's stray input pole, while simultaneously
    requiring C_f — the component that cancels that pole — to be fitted. If C_f
    is fitted and correct, hardware should approach the simulated 10.3%.
    Restate the allowance as margin for imperfect cancellation. C_f = C_in *
    R_g / R_f is sized from C_in, which is only estimated at 5-10 pF, so the
    exact C_f lies anywhere in 2.16-4.31 pF and one fitted part cannot be right
    across that span:
    C_in exact C_f residual w/ 3.3 pF pole phase lost @ 3 MHz
    5 pF 2.16 pF -2.66 pF (O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
2026-09-28 characterization.md: log 2026-09-24, Stage 4 attempted, no data
    Trainer unit 12 had all three supplies (yellow adjustable, +5 V, -15 V)
    collapsed to ~1.2 V in magnitude, measured with the board disconnected.
    Fuse intact. Hardware fault reported for the unit. Stage 4 was wired but
    never successfully powered, so there is no data and nothing enters the
    test matrix.
    Recorded explicitly that the circuit is not implicated either way: the
    rails were already down with nothing connected, so the stage 4 wiring is
    unvalidated rather than known-good or known-bad. The -15 V rail is noted
    as the strongest evidence the fault is upstream in the trainer, since this
    build is single-supply and never connected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
2026-09-28 Blueprint: correct the transport, record the PA5/LD2 DAC constraint
    Both found while writing the F303RE firmware; neither is a firmware
    workaround, they are errors in the blueprint.
    §4 transport: "USB CDC virtual COM" is right about what the host sees and
    wrong about what the MCU does. The F303RE's native USB device peripheral
    (PA11/PA12) is not routed to a connector on a Nucleo-64 — no socket, no
    pull-up. The board's VCP is the ST-LINK's, hard-wired to USART2 (PA2/PA3),
    which enumerates on the PC as a CDC serial port. The host opens an ordinary
    CDC device; the firmware is a plain UART with no USB stack, descriptors or
    middleware. Says so explicitly, and says not to add USB middleware.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
2026-09-28 firmware: MVP sweep engine, CSV contract, host-testable simulator
    Range 1, DC sweep, no pulsed mode, no auto-ranging. Targets the
    Nucleo-F303RE. Implements the blueprint §4 sweep engine, parameter table
    and i_limit_ma current limit.
    Structure. core/ holds the sweep engine, CSV writer, parameter table and
    command parser, and depends only on core/ct_device.h — a struct of function
    pointers. Two implementations satisfy it: stm32/Core/Src/ct_hal_device.c
    (real DACs, ADCs, UART) and sim/ct_sim_device.c (modelled DUT, output to a
    buffer). The engine cannot tell them apart, so the host tests exercise the
    actual firmware logic rather than a reimplementation.
    Testing without hardware. sim/ model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
2026-09-29 sim: stream output per line instead of staging it in a 64 KB buffer
    The simulator accumulated emitted bytes in a fixed 64 KB array and flushed it
    once per *input* line, which had two consequences for host development.
    A full-size family overran the buffer. 200 points across 8 gate steps is 1600
    rows, and the transcript came back with 1390 of them, the last cut mid-field
    and no `# end:` marker. Detectable — README.md already tells a host to treat a
    missing end marker as a failed capture — but a trap with no purpose.
    More importantly a whole sweep arrived as one block, since nothing was written
    until the SWEEP command line completed. That leaves the Python host's live
    plot as the only fu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
2026-09-29 Blueprint: pin the transconductance convention, record two extraction traps
    Three additions from designing the host extractor, all cases where the
    obvious implementation is wrong in a way that still produces plausible
    numbers.
    §5, conventions. "k = slope^2" does not say which k. Two conventions are in
    common use and differ by exactly two: I_D = beta*(Vgs-Vth)^2, which is what
    the fit naturally returns, and SPICE Level 1's I_D = (KP/2)(W/L)(Vgs-Vth)^2.
    Left ambiguous, this is a silent 2x error in a .model card. The table now
    names beta, and the extractor reports both beta and kp_wl = 2*beta, with
    spice.py emitting KP from the latter.
    §5, channel-length modulation. Saturation current carri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
2026-09-29 sim: apply rs in the diode model instead of ignoring it
    --rs was accepted by main_sim and documented in firmware/README.md, but
    ct_sim_dut_current_a never read it: the diode branch returned the ideal
    exponential regardless. Found while writing the host's diode extractor, which
    could not recover a series resistance that was never simulated.
    Unlike R_iso, bulk resistance is inside the device, so the Kelvin sense sees
    it. That is what produces the high-current roll-off from the ideal line a host
    extracts R_s from, and without it that whole path was untestable.
    The terminal voltage now splits between the junction and rs, solved by
    bisection on the junction voltage as the current is monotonic i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
2026-09-29 host: Python host -- capture, live plot, extraction, SPICE cards
    Blueprint §5, MVP scope: range 1, DC sweep, no pulsed mode.
    Transport is an abstraction with two implementations, pyserial and a
    subprocess running firmware/build/ct_sim. Every one of the 119 tests runs
    against the simulator, which is not a mock but firmware/core/ itself compiled
    for the host, so they exercise the real sweep engine and wire format. The
    extraction tests close the loop: feed the simulator a known device, sweep,
    extract, and require the parameters back. Vth 2.15 recovers to 2.1498, k 0.055
    to 0.05493, lambda 0.012 to 0.01207, diode n 1.75 to 1.7559 and rs 0.6 to
    0.5948.
    Four things a naive implementation would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
2026-09-29 Record the accepted-but-unapplied parameter as a recurring failure mode
    §11: the MODPEX placeholder Cjc and the simulator's ignored --rs are the same
    bug twice, and worth naming as a pattern rather than leaving as two isolated
    entries. Both parameters were documented and accepted and never applied, and
    both times the output looked right.
    The shared tell is that a physical effect did appear and was attributed to the
    wrong cause. Placeholder junction capacitances did not remove the follower's
    pole, they described a different circuit that happened to be stable. A missing
    rs did not remove the high-current roll-off, because R_iso's drop was already
    producing one -- front-end series resistance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
2026-10-05 Retarget the build on an assembled PCB, due Nov 16
    The deliverable is a usable instrument, not a demonstration rig, so the
    breadboard stops being the build platform.
    Blueprint §9 is restructured around that. Phase 1 shrinks to one
    measurement -- a stability GO/NO-GO on the composite amplifier, stages
    1-6 of docs/characterization.md, gate is no oscillation with real
    parasitics -- taken before layout freezes so a NO-GO can still change
    the schematic. Phases H1-H4 carry schematic, layout, freeze/order and
    bring-up. Phases 2-3 move onto the board. Phase 6 (pulsed) drops out of
    MVP scope. The six dates land as hard gates, Oct 12 through Nov 16.
    New §14 records the decision: why, MVP scope (ra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
2026-10-05 Drop the OPA2197 from the Oct 12 gate; order early, express
    Three review changes, plus the toolchain install.
    1. The Oct 12 gate no longer requires an OPA2197. It follows from the
    narrowing recorded last commit: stages 1-6 test the §12 cliff at light
    load, not the §3.1 overshoot spec, so the gate has no claim on the
    exact part -- and certainly not enough to put hand-soldered SOIC
    adapters on the critical path in the same week as the gate they were
    blocking. Phase 1 now runs on the fastest DIP-8 op-amp in the lab,
    >=8 MHz GBW. §14.3 carries the criterion as a table: crossover is
    roughly GBW/3.32, so >=8 MHz lands at >=2.4 MHz, inside the 2-3 MHz
    band where §3.1 pu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
2026-10-06 hardware: H1 schematic capture, DECISIONS.md; settle four open items
    Capture the MVP schematic in KiCad 10 under hardware/: sweep source,
    gate source, buffered difference amp, Kelvin sense, protection, and the
    Nucleo-F303RE on morpho sockets. ERC 0 violations; kicad-happy review 0
    errors (two CG-AUD warnings on the range jumpers are false positives).
    Every BOM line is in JLCPCB stock. DECISIONS.md records, per component,
    whether the value came from the blueprint, a sim (with run date), a
    datasheet, a capture decision or a later decision. No bench measurement
    on the intended parts exists yet, so each row names the measurement
    that would confirm it.
    Decisions from review, applied:
    1. D2 gate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
    [curve-tracer.kicad_sch, curve-tracer_bom.csv]
2026-10-06 Fix the Kelvin divider loading (F-1) and ADC clamp back-feed (F-2)
    F-1: the Kelvin divider's current was counted as DUT current. Fixed
    both ways.
    - Hardware: divider 30k/10k -> 300k/100k 0.1% (Yageo RT0603, 25 ppm,
    C705762 / C122538, both in JLC stock). Ratio still /4; loading drops
    from 25 to 2.5 uA/V.
    - Firmware: i_meas_ma is now DUT current, I_shunt - V_DS / CT_RDIV_OHM.
    CSV schema 1 -> 2, since the column's meaning changed. New header
    constants: cal_rdiv_ohm, cal_r_iso_ohm, and cal_r_ptc_ohm ("unset"
    until measured). The current limit acts on DUT current.
    - Simulator: models the divider current through the shunt (--rdiv) and
    an optional PTC (--rptc), so the correction is exe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
    [curve-tracer.kicad_sch, curve-tracer_bom.csv]
2026-10-07 Raise the settle_us default to 50 us for the ADC1 input filter
    The 1 kOhm x 10 nF filter at the ADC1 pin (tau = 10 us, blueprint 3.5) is
    now the binding settling constraint, not the sweep source or the DUT. At
    20 us the 64-sample mean still carries 0.16% of the previous point's step,
    a systematic lag; at 50 us it carries 0.008%, for 48 ms across a 1600-point
    family. Blueprint 4 records why the old rationale no longer holds.
    [ct_config.h]
2026-10-07 hardware: H2 layout, routed and exported for the JLCPCB order
    Pass 1 (analog-critical nets by hand) as approved, then Pass 2: board
    shrunk to 135 x 92 mm, the remaining nets autorouted with Freerouting
    v2.5.0 over the locked Pass 1 copper (DECISIONS.md P-5..P-10). DRC with
    schematic parity, ERC and check_topology.py --self-test are clean.
    - J7/J8 use a project footprint with mirrored pad numbering (L-2); its 3D
    model is shifted one pitch so the renders show the socket on its pads.
    - DECISIONS.md: the split-crossing distances to NT2 and why the feedback
    tap crossing is not a 3 MHz stability term (P-1), the JLCPCB quotes and
    why 100 x 100 is not reachable (P-5), the Q1 thermal estimate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
    [curve-tracer-B_Cu.gbl, curve-tracer-B_Mask.gbs, curve-tracer-B_Paste.gbp, curve-tracer-B_Silkscreen.gbo, curve-tracer-Edge_Cuts.gm1, curve-tracer-F_Cu.gtl, curve-tracer-F_Mask.gts, curve-tracer-F_Paste.gtp]
2026-10-07 hardware: J1 reverse-polarity P-FET, heatsink rule, NT2 justified
    - Q3 HL2303 (JLC Preferred, -30 V, +/-20 V gate, <= 28.5 mV at 150 mA) in
    the high side of J1, with D6 (12 V gate-source clamp, D2's line) and R25
    (10k gate pull-down, Basic): no new loading fee. Placed in the free patch
    above J1; the +15V pour's left edge moves from x 12 to 17. No existing
    copper removed or moved, no Pass 1 copper involved. TP28 bare pad on VIN.
    - check_topology.py asserts the protection and plants two new faults
    (drain/source swapped, gate Zener reversed): 55/55, 11/11 caught.
    - DECISIONS.md: P-11 records the part choice and that the 9.06 V headroom
    is set downstream of the loop, so a Schottky wo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
    [curve-tracer-B_Cu.gbl, curve-tracer-B_Mask.gbs, curve-tracer-B_Paste.gbp, curve-tracer-B_Silkscreen.gbo, curve-tracer-Edge_Cuts.gm1, curve-tracer-F_Cu.gtl, curve-tracer-F_Mask.gts, curve-tracer-F_Paste.gtp]
2026-10-07 hardware: label J2 polarity; design frozen pending the Oct 12 gate
    J2 stays deliberately unprotected (DECISIONS.md P-14): it takes a bench
    supply whose polarity is set and checked before connecting, unlike J1's
    arbitrary wall adapter, which Q3 protects. Its pads now carry "+15V" and
    "GND" in silkscreen. H4 adds a meter check of J2 polarity before first
    power-up, and first power-up through J2 at a 100 mA limit, raised above
    ~120 mA before any held-short test.
    Gerbers re-exported (front silkscreen only); DRC with schematic parity and
    check_topology.py --self-test clean.
    The design is frozen pending the Oct 12 stability gate.
    [curve-tracer-B_Cu.gbl, curve-tracer-B_Mask.gbs, curve-tracer-B_Paste.gbp, curve-tracer-B_Silkscreen.gbo, curve-tracer-Edge_Cuts.gm1, curve-tracer-F_Cu.gtl, curve-tracer-F_Mask.gts, curve-tracer-F_Paste.gtp]
2026-10-09 Drop the breadboard stability gate; add the bring-up contingency plan
    Phase 1, the Oct 12 breadboard stability GO/NO-GO, is dropped as a
    deliberate, accepted risk (blueprint §9): no DIP-8 op-amp of >= 8 MHz
    GBW on hand, no working bench, and the narrowed gate tested only the bare
    loop on a substitute part. The oscillation test moves to H4 on the
    assembled board. The hedge is the C_f footprint and the alternate values
    on R_B, R_sense and R_iso. The order now waits only on the pre-order
    checklist. The Oct 26 breadboard fallback needs a working bench and is
    notional until there is one.
    - hardware/CONTINGENCY.md: what to do if the board oscillates. Decision
    tree first, then measuring C_in, t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
2026-10-09 Bench docs for minimum operator time; drop 33 ohm from contingency parts
    - hardware/H4_CARD.md: the H4 checklist rewritten as one printable card.
    Every step has an exact setting, an expected value, a pass/fail
    threshold, a blank to fill and a goto on failure. Steps run highest-
    information first (oscillation right after power-up), with durations
    and a stop point about every 20 minutes. Prep that needs no bench time
    is split out.
    - C1 is fitted at 3.3 pF before first power-up. As assembled it is
    empty, and the uncancelled IN- pole (2.5-4.5 MHz for 5-9 pF) is
    predicted to cost 33-50 degrees of phase against ~59, which would
    send the card into contingency for a known reason. The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
2026-10-09 Add HOLD to the firmware and host; H4 card uses it; step 15 threshold
    HOLD <vds> holds the drain at one level, with the gate at vgs_list's single
    entry, until STOP or any other command. It keeps the sweep's §4 contract:
    the current is checked against i_limit_ma on every measurement, not only
    on reported rows, and the drain is zeroed before the flagged row is
    emitted. Both DACs end at zero. One row a second. The block is a normal
    CSV block with mode: hold.
    - core/ct_hold.{c,h}; the HOLD verb in ct_cmd. Two optional device hooks:
    input_pending, since a blocking parser can only see "another command" as
    a byte in the receive queue (bare CR/LF ignored, so a CRLF host does not
    end the hold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
2026-10-09 D3 = SMAJ12A TVS; close O-3; add it to the contingency parts
    D3 (DNP, fitted only if H4 step 15 exceeds 12 V) is an SMAJ12A
    unidirectional TVS in SMA: MDD, C113957, 78k at LCSC and 126k at JLC.
    It is a TVS rather than a Zener because the event is a microsecond
    structural overshoot (sim 10: 14.8 V at 100 pF), needing the faster
    response and the energy rating.
    What it clamps to here, from the datasheet: the limiter holds the source to
    <= ~0.11 A, so the clamp sits at its breakdown voltage, 13.3-14.7 V at
    1 mA, plus <= ~0.03 V: ~13.3-14.8 V. That is under 16 V, so no lower
    standoff is needed by that test. 12 V is its standoff, the level below which
    it does not conduct, so a fitted D3 still rea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
2026-10-11 Step 15 threshold 16 V; DUT-node design rule; D3 part number in schematic
    - H4 step 15: pass <= 16.0 V (was 12.0 V). With D3 fitted, 13.3-14.8 V is
    the SMAJ12A working as specified; above 16 V is something other than the
    structural overshoot sim 10 predicts. D3 bounds a microsecond transient,
    not the 10 V ceiling; sustained overcurrent is the firmware limit's job.
    The scope is now centred at +10 V so a 16 V peak is on screen.
    - Blueprint 3.3: everything on the DUT node is read as DUT current, with
    three instances (13's bridge, F-1's divider, D3's leakage). Anything
    added there is checked against range 3. 3.4 and F-1 point to it.
    - D3 schematic and PCB fields: SMAJ12A, MDD, C11395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
2026-10-11 Fit D3 by default; step 15 verifies, step 13a tells D3 from no D3
    - D3 SMAJ12A moves from DNP to PCBA: schematic, PCB, engineering BOM, JLC
    BOM and CPL (26 lines, 39 rows; +1 extended line, $54 in fees). Symbol
    is now Diode:SMAJ12A (unidirectional) instead of the bidirectional
    Device:D_TVS; pin 1, the cathode, stays on DUT_D. Gerbers unchanged.
    - DECISIONS D3 records the trade: <= 1 uA on the DUT node, 10% of range 3
    full scale and negligible on range 1, with ranges 2-3 outside the MVP,
    against bounding the overshoot sim 10 predicts on every limit release.
    - H4 step 15 is now a verification: expect 13.3-14.8 V, pass <= 16 V. It
    cannot confirm D3 on its own (the unclamped peak is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
2026-10-11 Zero hand-soldering: through-hole parts to PCBA, test loops dropped, ORDER.md
    - J1-J8 and Q1 back on the PCBA order. Each checked in JLCPCB's part
    record: THT, manualWeld, available. export_fab.py checks through-hole
    PCBA parts against THT_VERIFIED instead of refusing them, and writes one
    JLC BOM line per LCSC part: 32 lines, 48 CPL rows, no hand-solder lines.
    - TP1-TP27: no loops. Bare 1.0 mm plated holes, out of the BOM and CPL.
    H4 card: scope probe in a holder with its ground on J2 GND (the old
    "spring ground on TP27" was 50 mm from TP3); 13a clips moved to the
    supply post and J6. CONTINGENCY A2 changes the ground path instead.
    - Heatsink: Boyd 577500B00000G (26 C/W, fits the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
2026-10-11 Test loops back as JLC-assembled RH-5001; all 5 boards assembled; R2-1
    - TP1-TP27 (not TP6): RH-5001 (ronghe, C5199801), PCBA, THT/manualWeld,
    in the unchanged Keystone 5001 footprint. Added to THT_VERIFIED. JLC BOM
    33 lines, CPL 74 rows.
    - H4 card and CONTINGENCY back to clip leads on loops (13a on TP7/TP19, no
    probe holder). Kept: the scope ground is a clip lead on TP27, not a
    spring ground; A2 moves that lead to TP9. Heatsink part and 14d kept.
    - All 5 boards assembled. ORDER.md: JLCPCB $188.88 (loops $14.36; 5 vs 2
    assembled is now $27.80), LCSC $11.66, DigiKey $3.52.
    - DECISIONS: TP row, assembly record, and rev-2 item R2-1: no safe scope
    spring-ground point near TP3; rev 2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
2026-10-11 C5 to C47023118; CPL: no correction by analogy, THT at body centre
    - C5: ROQANG C72487 is "Standard Only" at JLCPCB, so it is replaced by
    jieerrui RVT50V10M5X5 (C47023118): same RVT series, 2000 h at 105 C,
    17 mA at 120 Hz. No ESR is listed for either part, so ESR, the parameter
    that matters for damping the supply lead, is inferred.
    - CPL: the +180 on CP_Elec (taken by analogy) is removed; JLCPCB's preview
    drew C5 reversed with it. Through-hole parts are placed at their F.Fab
    body centre, not pin 1, and TO-126 / 2.54 mm headers and sockets get +90,
    read off JLCPCB's preview. export_fab.py now needs KiCad's Python.
    - ORDER.md: JLCPCB $188.56. DECISIONS C5 and P-10 record both chan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
2026-10-11 CPL: SOT-23 at 180 from JLCPCB's preview; J1 back at its origin
    - SOT-23 (Q2, Q3, D4, D5) gets 180, overriding the rotation table's -90.
    At -90 JLCPCB's preview drew all four models turned across their pads;
    at 180 the lone lead and pin 1 land on the footprint's. Approved by
    Daniel: direct evidence about this fab's models beats a general
    reference, and the table's method was already wrong once (C5). Recorded
    in DECISIONS P-10 and in export_fab.py so it is not silently reverted.
    - J1 is placed at its pin-1 origin (ORIGIN_PLACED): at the F.Fab centre
    JLCPCB drew the DC-005 about 5 mm off the board edge.
2026-10-11 ORDER.md: the actual JLCPCB quote; blueprint: arrival Oct 16-20
    - ORDER.md: $137.98 + $37.16 DHL Express (DDP) - $10.00 coupon = $165.14.
    Extended-part fees apply only to the 18 SMD lines (18 x $3.09 =
    $55.62), not the 7 through-hole lines, which is why the $188.56
    estimate was high. Ships Oct 14, arrives Oct 16-20 (payment assumed
    Oct 11). Confirm Parts Placement on, 72-hour approval window. Shipping
    options, customs description (HS 903090) and settings recorded.
    - Blueprint 9: order gate met Oct 11; backstop rows not needed; arrival
    Oct 16-20 gives 27-31 days to the Nov 16 freeze instead of 13. 11 and
    14.3a updated to match.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
2026-10-11 README: per-instrument cost (~$31), a result, not a goal
    About $31 in parts per instrument (board components, bare PCB, assembly
    joints, Nucleo, heatsink), excluding one-time setup fees, shipping and
    duty. Records that low per-unit cost is not a project goal and must not be
    used to argue against the 0.1% resistors and OPA2197s, which make the
    closed-loop result credible.
2026-10-11 ORDER.md: LCSC/DigiKey lists checked today, blocking labels, cabinet list
    - LCSC ($13.72) and DigiKey ($5.37), both marked not yet ordered. Each
    line is labelled blocking (shunts, 3.3 pF, the C_f sweep values, L1
    parts, heatsink and insulator for Block 4) or contingency only (47 ohm,
    330 ohm, OPA2196, SMAJ12A spares).
    - U1 fallback is OPA2196IDR (C2057972, 215 in stock, $1.54); the tube part
    was down to 21. hardware/README matches.
    - Added: 200 ohm 1 W (C172930) and 100 nF X7R leaded (C1882781) for L1;
    330 ohm 1 W (C172941) for R4, which can see 0.67 W; Sil-Pad K-10
    (BER114-ND) to insulate Q1's +15 V tab from the heatsink.
    - "Assumed on hand" is now a lab-cabinet checklist: exact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
2026-10-11 H4 card P4: prove the heatsink pad insulates (heatsink to TP7 = OL)
    P4 now fits the Sil-Pad K-10, trimmed from its TO-220 cut to Q1's TO-126
    tab, checks that the slide-on heatsink still grips, and measures heatsink
    to TP7 (+15 V) as well as to TP27, both OL, before any Block 4 short.
    Recorded why: Q1's tab is the collector at +15 V, so without the pad a
    grounded touch shorts the rail past the current limiter, and the
    heatsink-to-ground check alone passes a live heatsink. ORDER.md's
    checklist matches.
2026-10-12 ORDER.md: DigiKey and LCSC orders placed; LCSC receipt in hardware/orders
    - DigiKey, submitted 2026-10-11: 2 heatsinks (HS216-ND) and 5 Sil-Pad
    K-10 (BER114-ND), both shipped from stock, USPS Ground Advantage, $11.48
    estimated. Arrives about Oct 15-20; needed only for H4 Block 4.
    - LCSC, order WM2610120117, 2026-10-11: the 13 planned lines plus a 10k
    and a 10 ohm quarter-watt axial, $15.12 merchandise. Receipt CSV
    (parts and prices only) at hardware/orders/. The shipping method is not
    on the receipt and is flagged to fill in.
2026-10-12 ORDER.md: LCSC ships by Global Direct Standard Line, arrives after the boards
    Ships ~Oct 13-14, arrives ~Oct 22 - Nov 4 against boards Oct 16-20.
    Blocking H4 parts (shunts, 3.3 pF C1, C_f set, L1 parts) are late;
    options recorded: upgrade to DHL or buy the blocking parts domestically.
2026-10-12 ORDER.md: second DigiKey order, C_f set so H4 does not wait for LCSC
    Six 0603 C0G ±0.1 pF Murata lines (1.5-4.7 pF), 10 each, $4.84 parts,
    ~$10.60 with USPS Ground Advantage (estimate), arriving ~Oct 15-20.
    Shunts, 200 ohm 1 W and 100 nF X7R come from the cabinet; DigiKey part
    numbers recorded in case it comes up short. LCSC C_f lines become spares.
2026-10-15 ORDER.md: both DigiKey orders received 2026-10-15; H4 blocking-item status
    The C_f set (incl. 3.3 pF for C1), heatsink and Sil-Pad are in hand.
    Outstanding before H4: the boards (due Oct 16-20) and the cabinet check
    for the Nucleo, shunts, 200 ohm 1 W, 100 nF X7R/C0G and 10 kohm. LCSC is
    in transit (Oct 22 - Nov 4) as spares. Placement confirmed 2026-10-13.
2026-10-18 ORDER.md, blueprint: boards shipped, DHL 3074485864, due Wed Oct 21
    JLCPCB packed W2026101205158610 (PCB and PCBA, 5 pcs each) for DHL
    Express Priority (DDP). DHL estimates delivery Wed Oct 21, end of day,
    one day after the quoted Oct 16-20 window: 26 days to the Nov 16 freeze
    instead of 27-31. LCSC (Oct 22 - Nov 4) still arrives after the boards.
2026-10-20 README: lead with the $283 first-build cost; $31 is marginal per unit
    The ~$31 figure read as the cost of the instrument. The four orders in
    hardware/ORDER.md total ~$283 with shipping, duty and tax (JLCPCB $235.05,
    LCSC ~$25.97, DigiKey $11.48 and ~$10.60), excluding the Nucleo and earlier
    prototype parts. $31 stays, labelled as the marginal cost of one more unit.
2026-10-24 STM32 build for real; sweep DAC to PA5 (F303RE has no DAC2); bare power-up
    First build against ST's own headers (Arm GNU Toolchain 14.3.Rel1,
    STM32CubeF3 v1.11.4 pinned) instead of stubs. New firmware/stm32/Makefile,
    project linker script, HAL config header; `make drivers` fetches ST's code
    (gitignored). Builds with zero compiler and linker warnings; 17.7 KB flash,
    7.3 KB RAM. Host suites pass; check_topology 59/59, 14/14 faults caught.
    What was wrong:
    - Clock: RCC_PLL_MUL18 does not exist (F3 PLL stops at x16), and on the
    F303xE the HSI enters the PLL through PREDIV, not a fixed /2. Now
    HSI -> PREDIV /1 -> x9 = 72 MHz.
    - No DAC2 on the F303RE (only F303x6/x8, F328, F334). The board tak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
2026-10-24 H4 P1b records the DAC's real floor and ceiling; broad-minimum guard
    DAC range stays undecided; P1b now resolves it. It records PA5 at code 0
    and at code 4095 to the mV (plus PA6, and PA4's floor), and the floor
    x 3.32 at the feedback node, alongside the 0.20 V pass/fail, which is only
    the datasheet guarantee. Blueprint §3.5 records that the floor matters more
    than the ceiling (Daniel): MOSFET sweeps start at V_DS = 0 and the diode's
    exponential fit lives at the low end, while the top 0.67 V (10.96 - 10.29)
    is headroom only, since §1's spec is 0-10 V. Noted for later, not designed:
    a pull-down may lower a buffered DAC's floor without turning the buffer
    off. R23/R24 already exist as DNP foo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
2026-10-24 Broad-minimum guard runs only when the best overshoot is above 20%
    If all three bracket values sit near 10-13%, the loop has margin: the §3.1
    gate is 25%, and the low-margin reading needs every value near 25%. A
    narrow spread there is a flat optimum. Widening would add two fits on the
    inverting-input pad for no information, and fewer fits on that pad is
    worth protecting in its own right (Daniel). H4 Block 2 rule 4 now checks
    best O <= 20% -> step 7 before taking the spread; CONTINGENCY §3 records
    why.
2026-10-24 Revise README with detailed project description
    Updated project description to provide detailed information about the curve tracer's capabilities, including voltage and current specifications, firmware details, and accuracy of parameter extraction.
2026-10-25 READMEs: re-run the simulator figures that predate the F-1 fix
    host/README.md quoted closed-loop results, the V_th sensitivity block and
    the fit-rule text from runs before 8742877. That commit subtracted the
    Kelvin divider current, which moved every extracted value; the README was
    not re-run. Each figure is replaced with a fresh run of the test fixtures,
    not rescaled. The old values reproduce exactly at 8742877^, and the new
    ones are unchanged from 8742877 through HEAD.
    - Test count 119 -> 135.
    - Closed loop: V_th 2.1502 V (0.2 mV), kp_wl 0.05506 (0.1%), lambda
    0.01192 (0.7%, was 0.5%), n 1.7605 (0.6%, was 0.3%), I_S 2.73 nA (9%,
    was 5%), R_s 0.5914 ohm (1.4%, was 0.9%).
    - Sensitivity b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
2026-10-25 I_S error is undithered quantisation, not the divider correction; 10 V only at low current
    host/README.md: the I_S error went from 5% to 9% at 8742877 (F-1), and the
    README still blamed quantisation. Tested on the fixture diode (I_S 2.5 nA,
    n 1.75, R_s 0.6 ohm):
    divider modelled, subtracted (HEAD) I_S +9.3%
    divider modelled, subtraction disabled +10.6%
    no divider, no subtraction +5.2% (= the pre-F-1 figure)
    The subtraction improves I_S, so it is not the cause. The divider's
    current (0.04 LSB at 0.7 V) changes it only by shifting where rounding
    falls: with the host subtracting a matched r_div, 100k..1G gives
    +5.8, +8.3, +9.3 (400k), +10.1, +10.3 (2M), +5.5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
2026-10-25 H4 and CONTINGENCY: no hand-soldering; C_f sweep retired; R2-2
    Daniel is not fitting 0603 parts by hand. The P3 practice on board 5 lost
    the 3.3 pF parts and could not place an 0603 reliably.
    H4_CARD.md
    - Rule: no soldering on any board; C1 empty all session. P3 is now a
    check that C1 is empty; board 5 is no longer a practice board.
    - P8: no iron, IPA or axial alternates. The C0G kit on hand is noted as
    1.5 / 2.2 / 2.7 / 4.7 pF (3.3 and 3.9 gone), unused at the bench.
    - Block 1 is the only loop measurement and always runs to the end.
    - STOP POINT A: oscillation (A3 entered) ends the session. Otherwise
    Block 3.
    - Block 2 says it plainly: no oscillation -> it does not run, C1 stays
    em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
2026-10-25 SB21 stays fitted: measure first; P1b maps the LED load; R2-3
    Daniel's decision (2026-10-25): do not remove SB21. LD2 + R31 (510 ohm)
    load the sweep DAC on PA5 beyond its 5 kohm rating from PA5 ~2.0-2.3 V,
    6.6-7.8 V at the feedback node (LED Vf 1.8-2.1 V assumed; the part is not
    on the MB1136 schematic). Removal stays the fallback for full-range sweeps.
    It is a more forgiving operation than placement, and the pads need not
    survive.
    Correction to the reasoning as given: Block 1 and steps 11-12 stay at
    PA5 = 1.81 V, but steps 14 and 15 hold at 10.96 V and 10 V. Step 14 is set
    by the limiter, which engages above ~4 V at the node, and LD2 cannot pull
    PA5 below its ~1.7 V turn-on. Step 15 now re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
2026-10-25 H4 P1b: gate channel full-scale reading at step 10's level
    P1b adds HOLD --vgs 10.95 --vds 0 (code 4093, PA4 3.298 V at 3.300 V) and
    reads PA4 at CN7-32 against ideal = code/4095 x V_3V3. This is the first
    measurement the gate channel gets, and 10.95 V is above the buffered
    DAC's guaranteed VDDA - 0.2 V.
    The gate is not measured (the CSV has vgs_set_v only). A shortfall makes
    the real gate low by shortfall x 3.32, so V_th reads high by up to that
    for gate steps at that level. The card says it is a bound near full scale
    only. VDDA - 0.2 V is a ceiling, not a gain error, so it says nothing
    about steps inside the guaranteed range: a 2N7000's 2.6-3.6 V steps put
    PA4 at 0.78-1.08 V. A family mix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
2026-10-25 H4 P1b: gate reading at 3.0 V; two V_th bounds recorded separately
    Adds HOLD --vgs 3.0 --vds 0 (code 1121, PA4 0.903 V at 3.300 V) beside the
    10.95 V gate row, both against ideal = code/4095 x V_3V3. The card records
    two V_th bounds (shortfall x 3.32) and what each covers. The 3.0 V row is
    normal operation: inside the guaranteed range, standing for a 2N7000's
    2.6-3.6 V steps (PA4 0.78-1.08 V), on the stated assumption that the
    error changes little over 0.3 V. The 10.95 V row is the ceiling case and
    covers near-full-scale steps only. The card also names the failure mode:
    a family with top steps above the range tilts the sqrt(I_D) fit and moves
    V_th, with no single reading looking wrong.
    Co-A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
2026-10-27 ORDER.md: LCSC first parcel received 2026-10-26, 8 of 15 lines
    Shunts and the 1 W 200 ohm are now in hand. The other 7 lines are marked
    awaiting a second parcel; none blocks H4, since the cabinet covers L1's
    100 nF (measured first) and the 10 kohm.
2026-10-28 Nucleo volume is NOD_F303RE; H4 P9 (mkdir h4) moves after P1
    The Nucleo-F303RE mounts as /Volumes/NOD_F303RE (measured 2026-10-28),
    not NODE_F303RE: Makefile NUCLEO_VOL default and H4_CARD P1 updated.
    P1b writes into h4/ and the host does not create it, so P9 now runs
    directly after P1. P1 leaves the terminal in firmware/stm32/, so P9
    now cds to host/ before mkdir h4, keeping h4/ where the HOLD commands
    write it.
2026-10-30 H4: skip P1b (LED-load map, shunt check, gate DAC rows)
    Daniel, 2026-10-30: least bench time. P1b's rows, pass row and sheet go;
    a short note says what is left unmeasured: the gate DAC error, the LED
    load on PA5 (the host's 6.6 V diagnostic limit stays), and the DAC floor,
    which step 8 still checks indirectly. No shunt check replaces it.
    Step 15 reads the recovered level from its own CSV (vds_meas_v after the
    pull, via the Kelvin pair) instead of P1b's 9.96 V row. R2-3 stays open:
    SB21 stays fitted and nothing now decides whether it comes off. Blueprint
    §3.5 Range, O-4, the J7/J8 row, firmware/README and two code comments say
    P1b was skipped rather than that it decides.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
2026-11-02 MVP bring-up card; README for applications readers; stale docs
    hardware/MVP_CARD.md: the minimum path from the Nucleo off the board to
    first power-up, Block 1 and one diode I-V capture, on board 2 with no
    heatsink. Block 1 is two 60 s holds at 6 V (L1, then open load); the scope
    reads Pk-Pk against an idle baseline, and the host's printed V and I are
    checked against derived bands. A pass shows no sustained oscillation under
    a DC hold; it does not measure phase margin or ringing (H4 step 5, not
    run). Shunt check from the top through the Arduino socket holes: CN6 GND
    pair as a contact check, D13-D12 must beep, D13-GND must not. Q1 runs
    bare, against CONTINGENCY 2B's heatsink precondition; the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
2026-11-02 Board records: boards unnumbered, one practice board retired; card fixes
    The boards were never physically numbered. Exactly one was used for the
    0603 soldering practice; it is the one with solder residue on C1 and is
    retired from measurements. The other four are untouched, and the bring-up
    board is one of them, called "board 2" from here on. DECISIONS R2-2,
    H4_CARD, MVP_CARD and ORDER now say this. They no longer name board 5 as
    the practice board or board 1 as the soldered one. CONTINGENCY §2B and §3
    named them too, and are corrected the same way.
    MVP_CARD step 2: pin 1 of CN7/CN10 is the end nearest the Nucleo's USB
    connector, and goes to the square-pad end of J7/J8. Step 4: the port is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
2026-11-04 Board 2 Block 1: fails at open load; sims 12-14; MVP card fixes
    Bench (measured, board 2, 2026-11-02/03, MVP_CARD.md): no sustained
    oscillation into 202 ohm || 95.2 nF (5.193 V, 25.74 mA; 26 mV p-p
    broadband against a 12.0 mV powered baseline). Intermittent 0.79-1.15 MHz
    oscillation at open load, C1 empty; stopped per CONTINGENCY A3, diode not
    run. Raw holds in host/h4/mvp_*.csv.
    Figures re-derived from the bench notes, corrected where they differ:
    - L1 cross-check: 5.193 V / 202 ohm = 25.705 mA vs 25.738 mA measured,
    0.13%, not "within 0.1%".
    - Step 9 current: 0.83-3.0 mA is over the card's <= 0.5 mA band in all
    three runs (V is in band).
    - Baseline B = 12.0 mV is over the card's < 10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
2026-11-04 MVP card section D: session 2 (R_p holds, R_p calibration, accuracy points, diode and MOSFET with R_p)
2026-11-04 host: --r-parallel OHM|auto|CSV for capture, extract, model, plot; annotate; extract --type resistor
    R_p clamped across D-S keeps board 2's loop quiet at the bottom of a sweep
    (sim 13). The host subtracts V/R_p per row, primary source a calibration
    capture of R_p alone, auto-fit reported as a cross-check. The record goes in
    the CSV header (host_r_parallel_*), the model card and the plot. ct_sim gains
    --rpar and --dac-floor. 16 tests.
2026-11-04 host: simulate (ngspice) and overlay commands; desk pipeline demo on ct_sim data
    model -> simulate -> overlay, one command each, for diode and MOSFET, with
    R_p subtracted. demo/run.sh runs it end to end on simulated captures; the
    figures are titled [SIMULATED]. 6 tests (skip without ngspice).
2026-11-04 Sims 14c and 14d: C1 bracket 2.2/4.7 pF at 6 V, and 0.1/0.3 V open load (TI model)
    Damping improves steadily from 0 to 4.7 pF with no too-much-C_f failure;
    3.3 pF is quiet at 0.1 and 0.3 V. 14c's 4.7 pF step collapsed at 9.30 us
    and was read over a common 3-9.2 us window.
2026-11-04 MVP card §D: L1 is the first R_p fallback, then any 330 Ω ≥ 1/4 W; step 13d stops before the diode if the DAC floor reads above 0.2 V
2026-11-04 R2-4: rev 2's C1 is 4.7 pF, superseding the round-down rule; sims 14e and 14f
    The bench is less damped than TI's model, and the model shows no
    over-compensation at 4.7 pF: no ring at 6 V open load, 0.24 mV into L1
    (as 3.3 pF), quiet at 0.1 and 0.3 V. README notes the fallback and the
    DAC-floor stop for the next session.
2026-11-09 host: subtract the R_p calibration's zero; annotate keeps CRLF; family colours
    - parallel: a fitted R_p (calibration or auto) now subtracts the whole
    line, V/R_p + offset, not V/R_p alone. The offset is the instrument's
    current zero. On board 2 (2026-11-08) it was -0.087 mA, 43% of the
    diode fit's 0.2 mA floor. Left in, it read a 1N4148 as n 1.651,
    I_S 0.83 nA; removed, n 1.789, I_S 2.68 nA, residual 0.80 -> 0.33 mV.
    Same zero in the diode's and MOSFET's own off regions (-0.095..-0.099).
    Daniel chose this over leaving it documented. The header records
    host_r_parallel_offset_ma; older captures without it are unchanged.
    - csvio.add_host_meta read with newline translation and wrot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
2026-11-09 Board 2 session 2 (2026-11-08): 470 Ω oscillates, L1 is R_p; accuracy; 1N4148 overlay; 2N7000 family; sim 15
    Bench (MVP card §D, measured): 470 Ω across D-S oscillated at idle,
    781.1 kHz, > 205 mV p-p. L1 (200 Ω || 100 nF) quiet at idle, 0.1, 0.3 V.
    DAC floor 0.18-0.19 V at the node. L1 calibration 201.31 Ω, zero
    -0.087 mA. Accuracy at 2/4/6 V within the DMM's own band. 1N4148:
    n 1.789, I_S 2.68 nA, R_s 1.14 Ω; ngspice overlay 0.51 mV rms, now the
    README headline. 2N7000: V_GS(th) 2.147 V at 1 mA; no .model card.
    Why 470 Ω and not L1 (analysis; sim 15, TI's model): the 100 nF moves the
    load's 20-30° lag from ~1.6-4.9 MHz to ~20-60 kHz, below crossover. Bias
    is secondary: 200 Ω alon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
2026-11-09 host: --zero-bracket on extract and model (diode): the zero's systematic
    Refits n, I_S and R_s with the instrument's current zero at each of two
    values and reports both, with the spread; `model` writes it into the
    card's header. The zero is subtracted with R_p (13afb00), and on board 2
    its estimates range from -0.087 mA (calibration) to -0.099 mA (the
    diode's own off rows). The headline values stay those of the zero
    applied. Diodes only; a MOSFET is refused.
    164 tests pass.
2026-11-09 Diode zero systematic; blueprint §11 "the model that said stable"; card fallback; README limitations
    Daniel's decisions on 2b9f05d:
    - Diode systematic from the instrument's zero, refitted at -0.087 and
    -0.099 mA: n 1.7877-1.8309 (spread 0.043, 14x its statistical error),
    I_S 2.663-3.691 nA (39%), R_s 1.137-1.006 ohm. V at fixed current moves
    <= 2.9 mV, so the comparison with published models stands. The -0.087
    end fits 2.1x tighter; the headline keeps the calibration's -0.0874.
    Quoted beside the headline in the README and in mvp_17_diode.lib.
    - Blueprint §11: a third named pattern, the model that said stable
    (Phase 0 BD139, sim 13's fitted macro-model, TI's model twice), with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
2026-11-09 Plots: no V_GS legend or label for a two-terminal capture; titled by device
    A capture whose only gate step is 0 V (diode, LED, resistor) now plots
    with no V_GS legend entry or label, titled with the device name alone:
    plot_family, LivePlot (from the vgs_list header) and the overlay, whose
    long "measured vs. simulated" title is now just the device. The
    [SIMULATED] marker stays on ct_sim figures, so they can't pass for bench
    data. Families are unchanged.
    Regenerated: media/overlay_diode_1n4148.png (the README headline) and
    media/demo_overlay_diode_SIMULATED.png, from the existing data; no figure
    changes beyond the title and legend. The bench's own h4/mvp_17_diode_rp.png
    is left as rendered at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
2026-11-09 Overlay: restore the descriptive title; only the V_GS legend/label goes
    45a4793 over-applied Daniel's rule: it was to drop the V_GS legend and label
    on two-terminal captures, not the title's description. The overlay title is
    now "<device>: measured vs simulated (extracted model)" (Daniel's wording),
    for every overlay. Simulator figures keep "[SIMULATED]: pipeline check on
    ct_sim data". plot_family and LivePlot keep 45a4793's behaviour.
    Regenerated media/overlay_diode_1n4148.png. media/demo_overlay_diode_SIMULATED.png
    is restored from 2b9f05d, whose title the code produces again.
    166 tests pass.
2026-11-09 Session 3 planned (MVP card §E); sims 16/16b: 100 nF alone across D-S
    Card section E, <= 30 min by 2026-11-15: a breadboard fixture (5 cm wires
    from J6, Kelvin pair at the device's rows, stabiliser plugged in for good);
    stability at idle and 0.2/1/6 V holds, cap alone first with L1 as the
    fallback; 0.1% 100 ohm and 1 kohm holds; the 1N4148 again.
    Sims 16 (floor, +-15 mV steps) and 16b (1 and 6 V start-up), TI's model:
    100 nF alone doesn't ring anywhere, at J6 or behind the fixture's
    ~100 nH; the open-load reference rings at 155-290 kHz under the same
    steps. With no resistor the node only discharges through 33.2 kohm
    below ~0.6 V: fine for a rising diode sweep, not for MOSFET families.
    Che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
2026-11-09 host: --zero MA|CSV|auto on extract, model and plot
    The instrument's current zero, subtracted on its own (ct_host/zero.py), for
    a stabiliser that draws no DC (MVP card section E):
    - MA: a value. CSV[,CSV...]: the mean of hold files, each file's mean
    listed; a hold drawing > 1.5 mA, or taken with an R_p, is refused.
    auto: the capture's own rows <= 0.3 V, one gate step only.
    - A --zero replaces an R_p calibration's offset (never both); the
    model card and plot record the zero and its source; --zero-bracket
    varies whichever zero was applied.
    - The channel's floor: the current channel is single-supply and the ADC
    unipolar, and board 2's zero is negative (-2.2 counts), so at true zero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
2026-11-09 MVP card §E: parts list at the top; the zero from (c), not the cap holds
    - Parts list first: breadboard, three ~5 cm solid wires, a second 100 nF
    ceramic (L1 stays intact as the fallback), the 0.1% 100 ohm and 1 kohm
    if on hand, the 1N4148 from 11-08; no 2N7000, no DMM.
    - Correction to 8b9f94f: with the cap alone the current channel sits on
    its floor (0 counts; board 2's zero is -2.2 counts), so 22b-d read
    i_meas ~ -V/400k and confirm the floor; they don't measure the zero.
    The zero now comes from (c).
    - (c) gains a third hold, 1 kohm at 2 V (20 s, no swap), added beyond the
    request: two holds can't separate gain, zero and the common-mode term.
    23a/23b at ~1.5-1.9 V fix gain a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
2026-11-09 host: --zero on simulate and overlay
    Same semantics as extract/model/plot (a given zero replaces an R_p
    calibration's offset). overlay subtracts it from the measured points and
    names it in the subtitle under R_p. simulate's curves depend only on the
    capture's voltage range, so the zero changes its header, not its numbers:
    like_zero and like_r_parallel record what the capture was corrected with.
    Tests: the 11-08 overlay with --zero -0.0873765 draws the same points,
    lines and residuals as the published media/overlay_diode_1n4148.png
    (compared as plotted data, not pixels, since the subtitle names a
    different source), including "rms 0.51 mV over the 60 fitted points";
    a zero of -0.099 mA change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
2026-11-09 host: model takes the MOSFET fit window; the card says what it fitted
    --vds-slice, --vgs-range and --saturation-margin move into one helper
    shared by extract and model, and both call extract_mosfet through it.
    The MOSFET card gains a "valid for" line, the V_GS and I_D span of the
    points in the V_th fit (from the fit, not the arguments), and a WARNING
    when that fit has one degree of freedom or fewer.
    11-08 2N7000, --vds-slice 1.5 --vgs-range 2.45 2.75, header R_p: extract
    and model agree at V_th 2.1496 V, KP*W/L 0.17521 A/V^2, R^2 0.999362 over
    3 steps (2.499..2.700 V, 11.3..27.9 mA). No card written: 3 steps is thin.
2026-11-09 host: lambda follows --vgs-range; MVP card §E (f), the 2N7000 at 0.02 V steps
    With --vgs-range, lambda is fitted over the same gate steps as V_th, so
    LAMBDA and the de-embedded KP describe the window VTO does. Without it,
    lambda uses every step, as before (demo figures unchanged). The card lists
    lambda's steps, marks R_DS(on) when its gate step (the top one) is outside
    the window (it was never in the .model body), and notes that V_GS is
    commanded, with the gate DAC's accuracy unmeasured.
    11-08 2N7000, slice 1.5 V, window 2.45-2.75 V: lambda 0.0301 -> 0.02867 /V
    (3 steps, 2.499-2.700 V), KP*W/L 0.17521 -> 0.17557 A/V^2 (+0.2%); V_th
    2.1496 V and R^2 0.999362 unchanged. Test pin updated acco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
2026-11-09 host: V_th spread follows --vgs-range; card 25c: a trip above the slice passes
    With --vgs-range, the fit-range choices behind the V_th spread are drawn
    from the window's gate steps only, at slices those steps all reach, and
    the card says so. Without it, unchanged.
    11-08, window 2.45-2.75 V: 5 choices, not 30 (three steps leave none to
    drop, so only the slice varies), spread 1.04 mV against a fit stderr of
    11.57 mV; it was 131.37 mV over the whole family. The planned 16-step
    capture gives the full 5 x 6 grid.
    capture now prints the flagged row (V_GS, V_DS, mA) when a sweep ends
    early, so 25c can tell a trip above the 1.1 V slice from one below it.
    25c: a trip above the slice passes; the red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
2026-11-09 MVP card 25c: fail only on fewer than 10 steps in the fit
    A trip at any voltage passes if it leaves at least 10 steps in the V_th
    fit; a top-step trip below the 1.1 V slice drops that step and leaves 15.
    The flagged-row printout and the note on the slice row stay.
2026-11-13 host: channel model (gain, zero, CMRR term, voltage offset, floor); measured floor guard; MOSFET auto-fit refusal
    - `ct_host channel` fits the current channel from holds into known
    resistors (g, b, c), holds with nothing drawing DC (the floor line), and
    optionally an R_p calibration (a voltage offset delta that makes its
    line's zero the resistors'). Medians; uncertainties from 4000 draws over
    resistor tolerance and hold noise. Writes a small text model.
    - `--zero FILE` applies a model: subtracts b + c*V, divides by g, takes
    delta off the voltage, and flags rows on the floor `floor` (left out of
    fits, drawn grey). Beside an R_p calibration line only g and delta apply:
    the line a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
2026-11-13 Board 2 session 3 (2026-11-13): cap-only stabiliser quiet; channel floor; 0.1% accuracy; 2N7000 card
    Data: host/h4/s3_* (p1b_0.csv not committed). s3_22d2_hold_6v_clean.csv
    renamed s3_23d_hold_100r_6v_selfheated.csv (it was the 100 ohm at 6 V,
    ~0.21 W, I/V +1.1% over 20 s); host_note in its header, rows untouched.
    - 100 nF alone across D-S on a breadboard fixture: quiet at idle,
    0.2/1/6 V, beside 0.1% resistors and through a diode sweep (sim 16
    predicted it). MOSFET families stay on L1.
    - No-load current is the difference stage's floor, 0.198 + 0.104*V mA
    (4 holds, within 5 uA): OPA2197 swing limit (TI: 5 mV typ) plus ~44 ohm
    x the V/21k its stuck output sinks. Corrects the card's "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
2026-11-13 Fixture resistance R_x analysed; 11-13 2N7000 card under investigation; MVP card §F; blueprint §11 fourth pattern
    Daniel, 2026-11-13: the 11-13 1N4148 and 2N7000 are the 11-08 parts.
    Analysis (no new measurement) of his hypothesis, one R_x between the Kelvin
    points and the device (Kelvin in the breadboard's upper half, parts in the
    lower half, linked across the centre channel):
    - Diode: dV(11-13 - 11-08) at equal current, 20-44 mV over 0.6-19 mA.
    R*I alone fails (best 3.4 ohm, 11 mV rms). Constant + slope + R*I fits to
    0.45 mV rms with R 0.58-0.60 ohm, a constant ~21 mV and dn ~ +0.14.
    - 2N7000: extra gate at equal current 88-96 mV. Pure degeneration fails
    (6.2 ohm, 32 mV rms); 86 m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
2026-11-13 Self-heating analysed as a candidate for the 11-08/11-13 constants; card note; §F back-to-back runs
    - host/h4/s3_25_mosfet.lib regenerated with a first note, "FIXTURE-DEPENDENT,
    UNDER INVESTIGATION"; parameters unchanged (only that note and the
    timestamp differ).
    - Analysis (characterization, "Self-heating during the DC sweeps"):
    datasheets read first-hand: 2N7000 theta_JA 357 C/W and Fig. 4,
    V_GS(th) -0.16%/K (~-3.5 mV/K at 1 mA; onsemi 2N7000/D Rev. 8);
    1N4148 R_thJA 350 K/W (Vishay 81857 Rev. 1.6) / 300 C/W (onsemi 1N914/D
    Rev. 6), V_F -1.8 mV/K at 1 mA, -1.5 at 10 mA (Vishay Fig. 1). Power x
    6 ms per row through one pole, tau 0.5-60 s: sweep energies 15.8 vs
    53.8 mJ (2N7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
2026-11-13 MVP card §F: two DMM checks, the gate at the part and the node voltage (<= 25 min)
    - 32: during a 2N7000 hold (V_GS 2.6 V, V_DS 1.5 V, 90 s, L1 in), DMM DC V
    20 V range from the G column to the part's S leg (the S column is full;
    J6's S screw as fallback, < 1 mV). The first measurement of the gate at
    the part. Explains the 86 mV if it reads 55-117 mV low (2.48-2.55 V at a
    2.601 V command, DMM +/-31 mV). If so, TP16 (GATE_AMP) to TP9 in the same
    hold: as commanded -> ~86 uA leaking from the gate node through the 1 kohm
    on the breadboard (absent in J6 on 11-08); low too -> the DAC/x3.32 chain,
    common to both sessions.
    - 29b: during a cap-only diode hold at ~10 mA (--vds 1.06, 60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
